SP8EBC/ParaTNC/doc/zlacza_pcb.jpg

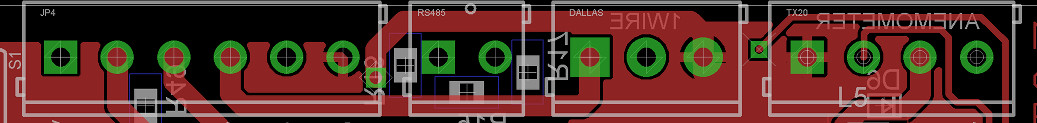
doc/zlacza_pcb.jpg
