SP8EBC/ParaTNC/doc/Screenshot_2026-09-29_10-51-03.jpg

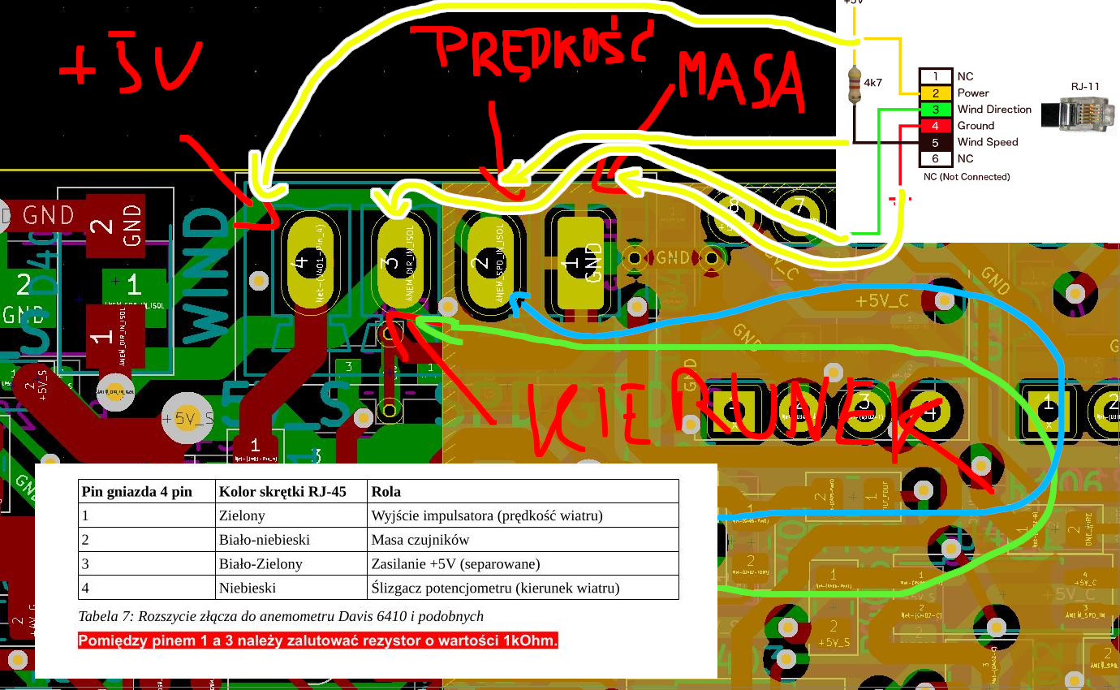
doc/Screenshot_2026-09-29_10-51-03.jpg
