SP8EBC/ParaTNC/doc/eclipse_indexer_config.png

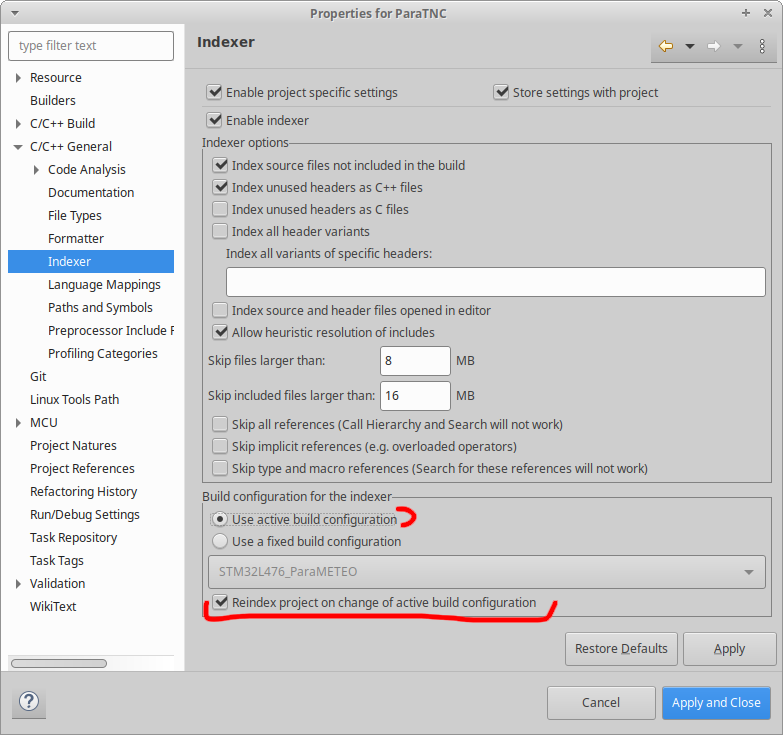
doc/eclipse_indexer_config.png
