SP8EBC/ParaTNC/doc/soft_reset_message_.jpg

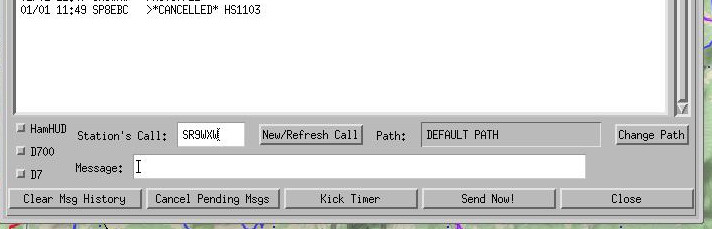
doc/soft_reset_message_.jpg
