SP8EBC/ParaTNC/(threads)

Thread 1 (2019-04-27):

Fake wind measuremenets after reconnecting DS12B20 sensor

SP8EBC, 2019-04-27:
Sometimes it is observed that after connecting DS12B20 temp sensor to controller which was powered up without it, wind measuremenets became screwed for unknown reasons

```
2019-04-27 09:58:20 CEST: SP8EBC-1>AKLPRZ,qAR,OK8UOF:T#057,058,002,109,120,000,00111000
2019-04-27 10:02:21 CEST: SP8EBC-1>AKLPRZ,qAR,OK8UOF:!4948.82N/01903.50E_000/000g000t032r...p...P...b00000
2019-04-27 10:03:22 CEST: SP8EBC-1>AKLPRZ,qAO,SP9AMG-1:=4948.82N101903.50E# Mateusz SP8EBC
2019-04-27 10:06:23 CEST: SP8EBC-1>AKLPRZ,qAO,SP9AMG-1:!4948.82N/01903.50E_000/000g000t032r...p...P...b00000
2019-04-27 10:08:24 CEST: SP8EBC-1>AKLPRZ,qAO,SP9AMG-1:T#058,073,003,105,120,000,00111000
2019-04-27 10:10:25 CEST: SP8EBC-1>AKLPRZ,qAR,OK8UOF:!4948.82N/01903.50E_000/000g000t032r...p...P...b00000
2019-04-27 10:14:26 CEST: SP8EBC-1>AKLPRZ,qAO,SP9AMG-1:!4948.82N/01903.50E_000/027g005t091r...p...P...b00000
2019-04-27 10:18:27 CEST: SP8EBC-1>AKLPRZ,qAR,OK8UOF:=4948.82N101903.50E# Mateusz SP8EBC
2019-04-27 10:18:28 CEST: SP8EBC-1>AKLPRZ,qAR,OK8UOF:!4948.82N/01903.50E_000/027g005t091r...p...P...b00000
2019-04-27 10:18:29 CEST: SP8EBC-1>AKLPRZ,qAO,SP9AMG-1:T#059,067,001,109,120,000,00111000
2019-04-27 10:22:31 CEST: SP8EBC-1>AKLPRZ,qAO,SP9AMG-1:!4948.82N/01903.50E_000/027g005t091r...p...P...b00000
```

Closed 2023-02-14.

Thread 3 (2021-06-13):

Failed linking during building target STM32L476_ParaMETEO

SP8EBC, 2021-06-13:
[console.log](https://github.com/SP8EBC/ParaTNC/files/6644348/console.log)

Closed 2021-09-14.

Thread 9 (2023-02-14):

Rework wx_handler_pressure to get pressure not humidity from RTU slave

SP8EBC, 2023-02-14:
`
```
        case WX_SOURCE_RTU:
	case WX_SOURCE_FULL_RTU: {

//		// get the value read from RTU registers
//		measurement_retval = rtu_get_humidity(&rte_wx_humidity, config_rtu);
//
//		// check
//		if (measurement_retval == MODBUS_RET_OK || measurement_retval == MODBUS_RET_DEGRADED) {
//
//			// set the flag that external temperature is available
//			output |= WX_HANDLER_PARAMETER_RESULT_HUMIDITY;
//
//			if (measurement_retval == BME280_OK) {
//				rte_wx_humidity_valid = rte_wx_humidity;
//			}
//		}
//
```
`

Thread 10 (2023-07-03):

ParaMETEO hardware: values of resitor to scale B+ to ADC voltage range

SP8EBC, 2023-07-03:
Some PCBs has 51k/510k pair. Some have 10k/100k. This might be a part of fix related to continous / non-continous ADC mode of operation. It has been checked and worked on in the past, but it needs to be consistent!!!!

Thread 11 (2023-07-13):

ParaMETEO hardware: fitting DB-9 connector

SP8EBC, 2023-07-13:
It's hard to believe but there is a problem with mechanical compatibility between two Amphenol connectors.

DE09P065TXLF - DB9 male soldered on cable
LD09S24A4GV00LF - DB9 female straight on PCB.

male plug cannot be pull completely into a connector. For some reason there will be no contact in between. The solution is to put two 1mm washers between male plug screw and a peg in the PCB female connector.

Thread 12 (2023-10-15):

APRS-IS connecting routine stalled after timeout and first reconnection

SP8EBC, 2023-10-15:
As a result the controller is no longer communicating with APRS-IS server and it looks like that it is not even connected at all. Below some raw aprs.fi logs. The second one is from a moment when communcation has been lost.
```
2023-10-14 05:32:39 CEST: [SR9WXP](https://aprs.fi/?c=raw&limit=&call=SR9WXP)>AKLPRZ,TCPIP*,qAC,T2ITALYN:!4932.18N/01919.18E_024/000g000t032r...p...P...b09682h45
2023-10-14 05:34:39 CEST: [SR9WXP](https://aprs.fi/?c=raw&limit=&call=SR9WXP)>AKLPRZ,TCPIP*,qAC,T2ITALYN:!4932.18N/01919.18E_024/000g000t032r...p...P...b09681h45
2023-10-14 05:36:37 CEST: [SR9WXP](https://aprs.fi/?c=raw&limit=&call=SR9WXP)>AKLPRZ,qAR,[SR9NSK](https://aprs.fi/?c=raw&limit=&call=SR9NSK):!4932.18N/01919.18E_021/000g000t032r...p...P...b09681h45
2023-10-14 05:36:40 CEST: [SR9WXP](https://aprs.fi/?c=raw&limit=&call=SR9WXP)>AKLPRZ,qAR,[SR9NSK](https://aprs.fi/?c=raw&limit=&call=SR9NSK):T#051,025,000,002,115,155,00101000
2023-10-14 05:38:41 CEST: [SR9WXP](https://aprs.fi/?c=raw&limit=&call=SR9WXP)>AKLPRZ,TCPIP*,qAC,T2ITALYN:!4932.18N/01919.18E_024/000g000t032r...p...P...b09681h45
2023-10-14 05:40:41 CEST: [SR9WXP](https://aprs.fi/?c=raw&limit=&call=SR9WXP)>AKLPRZ,TCPIP*,qAC,T2ITALYN:!4932.18N/01919.18E_024/000g000t032r...p...P...b09681h45
2023-10-14 05:41:41 CEST: [SR9WXP](https://aprs.fi/?c=raw&limit=&call=SR9WXP)>AKLPRZ,qAO,[SQ9KPH-12](https://aprs.fi/?c=raw&limit=&call=SQ9KPH-12):!4932.18N/01919.18E_021/000g000t032r...p...P...b09680h46
2023-10-14 05:42:42 CEST: [SR9WXP](https://aprs.fi/?c=raw&limit=&call=SR9WXP)>AKLPRZ,TCPIP*,qAC,T2ITALYN:!4932.18N/01919.18E_022/000g000t032r...p...P...b09681h46
2023-10-14 05:44:42 CEST: [SR9WXP](https://aprs.fi/?c=raw&limit=&call=SR9WXP)>AKLPRZ,TCPIP*,qAC,T2ITALYN:!4932.18N/01919.18E_022/000g000t032r...p...P...b09681h45
2023-10-14 12:19:49 CEST: [SR9WXP](https://aprs.fi/?c=raw&limit=&call=SR9WXP)>AKLPRZ,qAR,[SR9KFZ](https://aprs.fi/?c=raw&limit=&call=SR9KFZ):=4932.18NR01919.18E& DigiW1 + WX = TXPower 1W = Pilsko, wyciag orczykowy VII, 1440m AMSL = sp8ebc@interia.pl [vbat: 1318][rtc_ok: 1]
2023-10-14 12:19:52 CEST: [SR9WXP](https://aprs.fi/?c=raw&limit=&call=SR9WXP)>AKLPRZ,qAR,[SP9DLM](https://aprs.fi/?c=raw&limit=&call=SP9DLM):>[powersave registers][last_sleep_ts: 0x90724][last_wakeup_ts: 0x91152][sleep_wakeup_cntrs: 0xF90141][monitor: 0x0][last_sleep_time: 0xF0]
2023-10-14 12:21:26 CEST: [SR9WXP](https://aprs.fi/?c=raw&limit=&call=SR9WXP)>AKLPRZ,qAR,[SP9DLM](https://aprs.fi/?c=raw&limit=&call=SP9DLM):>[GSM status][network: Plus GSM][signal: -68dBm][freq: 935.59MHz][cellid: f660][lac: 539d][IP addr: 10.18.7.101  ]
2023-10-14 12:22:46 CEST: [SR9WXP](https://aprs.fi/?c=raw&limit=&call=SR9WXP)>AKLPRZ,TCPIP*,qAC,T2NORWAY:=4932.18NR01919.18E& DigiW1 + WX = TXPower 1W = Pilsko, wyciag orczykowy VII, 1440m AMSL = sp8ebc@interia.pl
2023-10-14 12:22:46 CEST: [SR9WXP](https://aprs.fi/?c=raw&limit=&call=SR9WXP)>AKLPRZ,TCPIP*,qAC,T2NORWAY:>[aprsis][]# aprsc 2.1.15-gc67551b
2023-10-14 12:24:05 CEST: [SR9WXP](https://aprs.fi/?c=raw&limit=&call=SR9WXP)>AKLPRZ,TCPIP*,qAC,T2NORWAY:!4932.18N/01919.18E_204/010g015t054r...p...P...b08523h91
2023-10-14 12:24:25 CEST: [SR9WXP](https://aprs.fi/?c=raw&limit=&call=SR9WXP)>AKLPRZ,qAR,[SR7NST](https://aprs.fi/?c=raw&limit=&call=SR7NST):!4932.18N/01919.18E_211/010g015t054r...p...P...b08522h90
2023-10-14 12:24:50 CEST: [SR9WXP](https://aprs.fi/?c=raw&limit=&call=SR9WXP)>AKLPRZ,qAR,[SP9DLM](https://aprs.fi/?c=raw&limit=&call=SP9DLM):>[APRS-IS timeout][aprsis_unsucessfull_conn_counter: 0]
2023-10-14 12:26:19 CEST: [SR9WXP](https://aprs.fi/?c=raw&limit=&call=SR9WXP)>AKLPRZ,TCPIP*,qAC,T2SWEDEN:=4932.18NR01919.18E& DigiW1 + WX = TXPower 1W = Pilsko, wyciag orczykowy VII, 1440m AMSL = sp8ebc@interia.pl
2023-10-14 12:26:19 CEST: [SR9WXP](https://aprs.fi/?c=raw&limit=&call=SR9WXP)>AKLPRZ,TCPIP*,qAC,T2SWEDEN:>[aprsis][]# aprsc 2.1.15-gc67551b
2023-10-14 12:27:30 CEST: [SR9WXP](https://aprs.fi/?c=raw&limit=&call=SR9WXP)>AKLPRZ,TCPIP*,qAC,T2SWEDEN:!4932.18N/01919.18E_207/010g016t054r...p...P...b08525h90
2023-10-14 12:29:31 CEST: [SR9WXP](https://aprs.fi/?c=raw&limit=&call=SR9WXP)>AKLPRZ,TCPIP*,qAC,T2SWEDEN:!4932.18N/01919.18E_207/009g016t054r...p...P...b08525h90
2023-10-14 12:32:52 CEST: [SR9WXP](https://aprs.fi/?c=raw&limit=&call=SR9WXP)>AKLPRZ,TCPIP*,qAC,T2CSNGRAD:=4932.18NR01919.18E& DigiW1 + WX = TXPower 1W = Pilsko, wyciag orczykowy VII, 1440m AMSL = sp8ebc@interia.pl
2023-10-14 12:32:52 CEST: [SR9WXP](https://aprs.fi/?c=raw&limit=&call=SR9WXP)>AKLPRZ,TCPIP*,qAC,T2CSNGRAD:>[aprsis][]# aprsc 2.1.15-gc67551b
2023-10-14 12:33:59 CEST: [SR9WXP](https://aprs.fi/?c=raw&limit=&call=SR9WXP)>AKLPRZ,TCPIP*,qAC,T2CSNGRAD:!4932.18N/01919.18E_209/010g016t054r...p...P...b08517h89
2023-10-14 12:34:28 CEST: [SR9WXP](https://aprs.fi/?c=raw&limit=&call=SR9WXP)>AKLPRZ,qAR,[SP9DLM](https://aprs.fi/?c=raw&limit=&call=SP9DLM):!4932.18N/01919.18E_217/010g016t054r...p...P...b08517h89
2023-10-14 12:36:06 CEST: [SR9WXP](https://aprs.fi/?c=raw&limit=&call=SR9WXP)>AKLPRZ,TCPIP*,qAC,T2PRT:=4932.18NR01919.18E& DigiW1 + WX = TXPower 1W = Pilsko, wyciag orczykowy VII, 1440m AMSL = sp8ebc@interia.pl
2023-10-14 12:36:06 CEST: [SR9WXP](https://aprs.fi/?c=raw&limit=&call=SR9WXP)>AKLPRZ,TCPIP*,qAC,T2PRT:>[aprsis][]# aprsc 2.1.14-g5e22b37
2023-10-14 12:36:29 CEST: [SR9WXP](https://aprs.fi/?c=raw&limit=&call=SR9WXP)>AKLPRZ,qAR,[SP9DLM](https://aprs.fi/?c=raw&limit=&call=SP9DLM):>[GSM status][network: Plus GSM][signal: -70dBm][freq: 935.59MHz][cellid: f660][lac: 539d][IP addr: 10.169.130.219  ]
2023-10-14 12:39:36 CEST: [SR9WXP](https://aprs.fi/?c=raw&limit=&call=SR9WXP)>AKLPRZ,qAR,[SP9DLM](https://aprs.fi/?c=raw&limit=&call=SP9DLM):!4932.18N/01919.18E_201/009g015t055r...p...P...b08522h89
2023-10-14 12:41:58 CEST: [SR9WXP](https://aprs.fi/?c=raw&limit=&call=SR9WXP)>AKLPRZ,TCPIP*,qAC,T2SWEDEN:=4932.18NR01919.18E& DigiW1 + WX = TXPower 1W = Pilsko, wyciag orczykowy VII, 1440m AMSL = sp8ebc@interia.pl
2023-10-14 12:41:58 CEST: [SR9WXP](https://aprs.fi/?c=raw&limit=&call=SR9WXP)>AKLPRZ,TCPIP*,qAC,T2SWEDEN:>[aprsis][]# aprsc 2.1.15-gc67551b
2023-10-14 12:43:38 CEST: [SR9WXP](https://aprs.fi/?c=raw&limit=&call=SR9WXP)>AKLPRZ,TCPIP*,qAC,T2SWEDEN:!4932.18N/01919.18E_203/009g013t055r...p...P...b08522h89
2023-10-14 12:45:38 CEST: [SR9WXP](https://aprs.fi/?c=raw&limit=&call=SR9WXP)>AKLPRZ,TCPIP*,qAC,T2SWEDEN:!4932.18N/01919.18E_195/008g011t055r...p...P...b08523h89
2023-10-14 12:47:38 CEST: [SR9WXP](https://aprs.fi/?c=raw&limit=&call=SR9WXP)>AKLPRZ,TCPIP*,qAC,T2SWEDEN:!4932.18N/01919.18E_199/009g015t055r...p...P...b08523h89
2023-10-14 12:49:34 CEST: [SR9WXP](https://aprs.fi/?c=raw&limit=&call=SR9WXP)>AKLPRZ,qAR,[SP9DLM](https://aprs.fi/?c=raw&limit=&call=SP9DLM):T#002,171,000,006,200,139,10001000
2023-10-14 12:49:38 CEST: [SR9WXP](https://aprs.fi/?c=raw&limit=&call=SR9WXP)>AKLPRZ,TCPIP*,qAC,T2SWEDEN:!4932.18N/01919.18E_189/009g015t055r...p...P...b08523h89
2023-10-14 12:51:38 CEST: [SR9WXP](https://aprs.fi/?c=raw&limit=&call=SR9WXP)>AKLPRZ,TCPIP*,qAC,T2SWEDEN:!4932.18N/01919.18E_198/009g012t055r...p...P...b08523h89
2023-10-14 12:54:34 CEST: [SR9WXP](https://aprs.fi/?c=raw&limit=&call=SR9WXP)>AKLPRZ,qAR,[SP9DLM](https://aprs.fi/?c=raw&limit=&call=SP9DLM):!4932.18N/01919.18E_204/008g013t055r...p...P...b08523h89
2023-10-14 12:55:39 CEST: [SR9WXP](https://aprs.fi/?c=raw&limit=&call=SR9WXP)>AKLPRZ,TCPIP*,qAC,T2SWEDEN:!4932.18N/01919.18E_204/009g014t055r...p...P...b08523h89
2023-10-14 12:57:39 CEST: [SR9WXP](https://aprs.fi/?c=raw&limit=&call=SR9WXP)>AKLPRZ,TCPIP*,qAC,T2SWEDEN:!4932.18N/01919.18E_193/009g014t055r...p...P...b08523h88
```

```2023-10-14 20:42:56 CEST: [SR9WXP](https://aprs.fi/?c=raw&limit=&call=SR9WXP)>AKLPRZ,qAR,[SP9DLM](https://aprs.fi/?c=raw&limit=&call=SP9DLM):!4932.18N/01919.18E_258/006g008t047r...p...P...b08519h97
2023-10-14 20:44:55 CEST: [SR9WXP](https://aprs.fi/?c=raw&limit=&call=SR9WXP)>AKLPRZ,TCPIP*,qAC,T2SWEDEN:!4932.18N/01919.18E_271/006g007t047r...p...P...b08520h97
2023-10-14 20:46:57 CEST: [SR9WXP](https://aprs.fi/?c=raw&limit=&call=SR9WXP)>AKLPRZ,TCPIP*,qAC,T2SWEDEN:!4932.18N/01919.18E_274/005g007t047r...p...P...b08520h97
2023-10-14 20:47:55 CEST: [SR9WXP](https://aprs.fi/?c=raw&limit=&call=SR9WXP)>AKLPRZ,qAR,[SR9NSK](https://aprs.fi/?c=raw&limit=&call=SR9NSK):!4932.18N/01919.18E_278/005g007t047r...p...P...b08520h97
2023-10-14 20:48:56 CEST: [SR9WXP](https://aprs.fi/?c=raw&limit=&call=SR9WXP)>AKLPRZ,TCPIP*,qAC,T2SWEDEN:!4932.18N/01919.18E_284/004g005t047r...p...P...b08520h97
2023-10-14 20:50:56 CEST: [SR9WXP](https://aprs.fi/?c=raw&limit=&call=SR9WXP)>AKLPRZ,TCPIP*,qAC,T2SWEDEN:!4932.18N/01919.18E_261/004g005t047r...p...P...b08519h97
2023-10-14 20:52:55 CEST: [SR9WXP](https://aprs.fi/?c=raw&limit=&call=SR9WXP)>AKLPRZ,qAR,[SP9DLM](https://aprs.fi/?c=raw&limit=&call=SP9DLM):!4932.18N/01919.18E_324/002g005t047r...p...P...b08518h97
2023-10-14 20:55:33 CEST: [SR9WXP](https://aprs.fi/?c=raw&limit=&call=SR9WXP)>AKLPRZ,TCPIP*,qAC,T2SWEDEN:!4932.18N/01919.18E_280/005g008t047r...p...P...b08519h97
2023-10-14 20:57:58 CEST: [SR9WXP](https://aprs.fi/?c=raw&limit=&call=SR9WXP)>AKLPRZ,qAR,[SP9DLM](https://aprs.fi/?c=raw&limit=&call=SP9DLM):!4932.18N/01919.18E_272/006g007t047r...p...P...b08520h97
2023-10-14 20:57:59 CEST: [SR9WXP](https://aprs.fi/?c=raw&limit=&call=SR9WXP)>AKLPRZ,qAR,[SP9DLM](https://aprs.fi/?c=raw&limit=&call=SP9DLM):>[GSM status][network: Plus GSM][signal: -70dBm][freq: 935.59MHz][cellid: f660][lac: 539d][IP addr: 10.22.78.160  ]
2023-10-14 20:59:00 CEST: [SR9WXP](https://aprs.fi/?c=raw&limit=&call=SR9WXP)>AKLPRZ,TCPIP*,qAC,T2ROMANIA:=4932.18NR01919.18E& DigiW1 + WX = TXPower 1W = Pilsko, wyciag orczykowy VII, 1440m AMSL = sp8ebc@interia.pl
2023-10-14 21:03:00 CEST: [SR9WXP](https://aprs.fi/?c=raw&limit=&call=SR9WXP)>AKLPRZ,qAR,[SP9UVG-13](https://aprs.fi/?c=raw&limit=&call=SP9UVG-13):!4932.18N/01919.18E_275/004g006t047r...p...P...b08521h97
2023-10-14 21:03:04 CEST: [SR9WXP](https://aprs.fi/?c=raw&limit=&call=SR9WXP)>AKLPRZ,qAR,[SP9UVG-13](https://aprs.fi/?c=raw&limit=&call=SP9UVG-13):T#051,186,000,002,127,127,10001000
2023-10-14 21:13:04 CEST: [SR9WXP](https://aprs.fi/?c=raw&limit=&call=SR9WXP)>AKLPRZ,qAR,[SP9UVG-13](https://aprs.fi/?c=raw&limit=&call=SP9UVG-13):!4932.18N/01919.18E_312/003g004t044r...p...P...b08521h96
2023-10-14 21:13:07 CEST: [SR9WXP](https://aprs.fi/?c=raw&limit=&call=SR9WXP)>AKLPRZ,qAR,[SP9UVG-13](https://aprs.fi/?c=raw&limit=&call=SP9UVG-13):T#052,182,000,000,128,125,10001000
2023-10-14 21:18:11 CEST: [SR9WXP](https://aprs.fi/?c=raw&limit=&call=SR9WXP)>AKLPRZ,qAR,[SP9UVG-13](https://aprs.fi/?c=raw&limit=&call=SP9UVG-13):!4932.18N/01919.18E_018/003g004t043r...p...P...b08521h96
2023-10-14 21:23:07 CEST: [SR9WXP](https://aprs.fi/?c=raw&limit=&call=SR9WXP)>AKLPRZ,qAR,[SR9KFZ](https://aprs.fi/?c=raw&limit=&call=SR9KFZ):!4932.18N/01919.18E_347/001g002t042r...p...P...b08520h96```

SP8EBC, 2023-10-24:
This was not an error. There is a problem with GSM signal level in that location. Network becomes unavailable during foggy and/or rainy weather.

Closed 2023-10-24.

Thread 13 (2023-10-30):

Probable bug in srl_reset function

SP8EBC, 2023-10-30:
This function supposes to reset USART driver state by clearing receive and transmit enums to 'IDLE', reset some counter etc. It is used in three places by sim800 GPRS/GSM modem driver. The problem might be that srl_reset does not disable interrupts for USART port, which might cause a deadlock or rather a deadloop, after a port will receive something **after** it is reset.

Below some screenshots of controller in such state.
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

SP8EBC, 2023-10-30:
```mateusz@mateusz-ThinkCentre-M720q:~/Documents/___STM32/ParaTNC$ git diff 4429c67 6648c8c system/src/drivers/l4/serial_stm32l4x.c
mateusz@mateusz-ThinkCentre-M720q:~/Documents/___STM32/ParaTNC$ git diff 4429c67 28b65cc system/src/drivers/l4/serial_stm32l4x.c
diff --git a/system/src/drivers/l4/serial_stm32l4x.c b/system/src/drivers/l4/serial_stm32l4x.c
index 4d9182c..9e2796a 100644
--- a/system/src/drivers/l4/serial_stm32l4x.c
+++ b/system/src/drivers/l4/serial_stm32l4x.c
@@ -730,7 +730,22 @@ void srl_irq_handler(srl_context_t *ctx) {
                        }

                        break;
-                       default: break;
+               case SRL_TX_IDLE:^M
+                       ctx->port->CR1 &= (0xFFFFFFFF ^ USART_CR1_TE);          //wyġṗczanie nadajnika portu szeregowego^M
+                       ctx->port->CR1 &= (0xFFFFFFFF ^ USART_CR1_TXEIE);^M
+                       ctx->port->CR1 &= (0xFFFFFFFF ^ USART_CR1_TCIE);        // wyġṗczanie przerwañ od portu szeregowego^M
+                       ctx->port->ISR &= (0xFFFFFFFF ^ USART_ISR_TC);^M
+                       ctx->srl_tx_state = SRL_TX_IDLE;^M
+^M
+                       // reset tx buffer pointer to internal one^M
+                       ctx->srl_tx_buf_pointer = ctx->srl_tx_internal_buf_pointer;^M
+                       ctx->srl_tx_buf_ln = ctx->srl_tx_internal_buf_ln;^M
+^M
+                       if (ctx->te_port != 0) {^M
+                               LL_GPIO_ResetOutputPin(ctx->te_port, ctx->te_pin);^M
+                       }^M
+                       break;^M
+               default: break;^M
                }
        }

mateusz@mateusz-ThinkCentre-M720q:~/Documents/___STM32/ParaTNC$```
