SP8EBC/ParaTNC/hardware/parameteo_hwrev_h/parameteo_hwrev_h.pdf

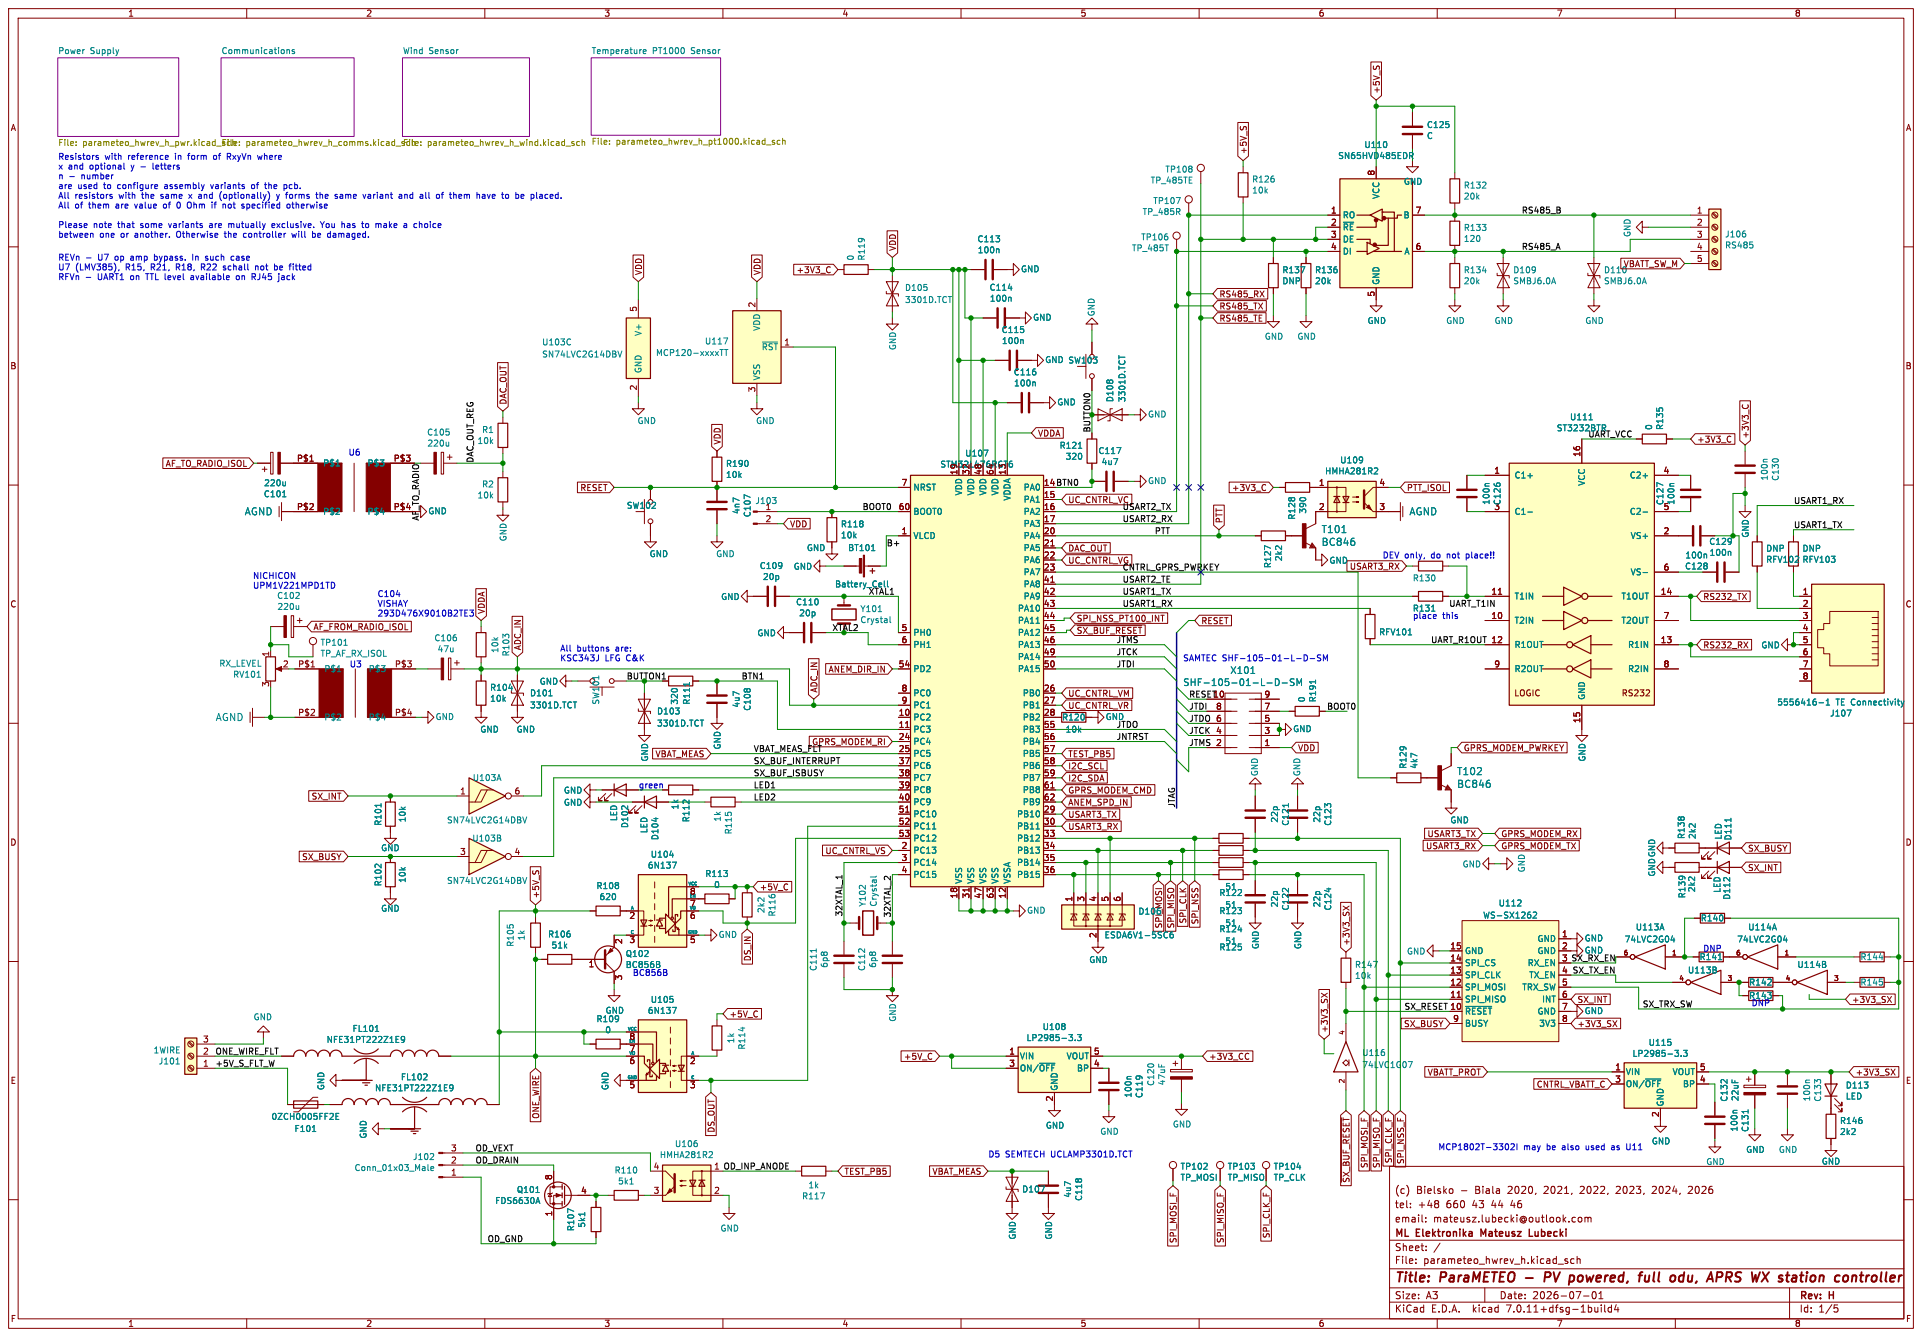
[picture p27: page 1]

Communications File: parameteo_hwrev_h_comms.kicad_sch Wind Sensor File: parameteo_hwrev_h_wind.kicad_sch Power Supply File: parameteo_hwrev_h_pwr.kicad_sch

2 3 GND GND GND R101 10k GND GND R102 10k R107 5k1 FL101 NFE31PT222Z1E9 F101

2 ON/~{OFF} 3 BP 4 VOUT 5 U108

2 ON/~{OFF} 3 BP 4 VOUT 5 C118 4u7D107 GND

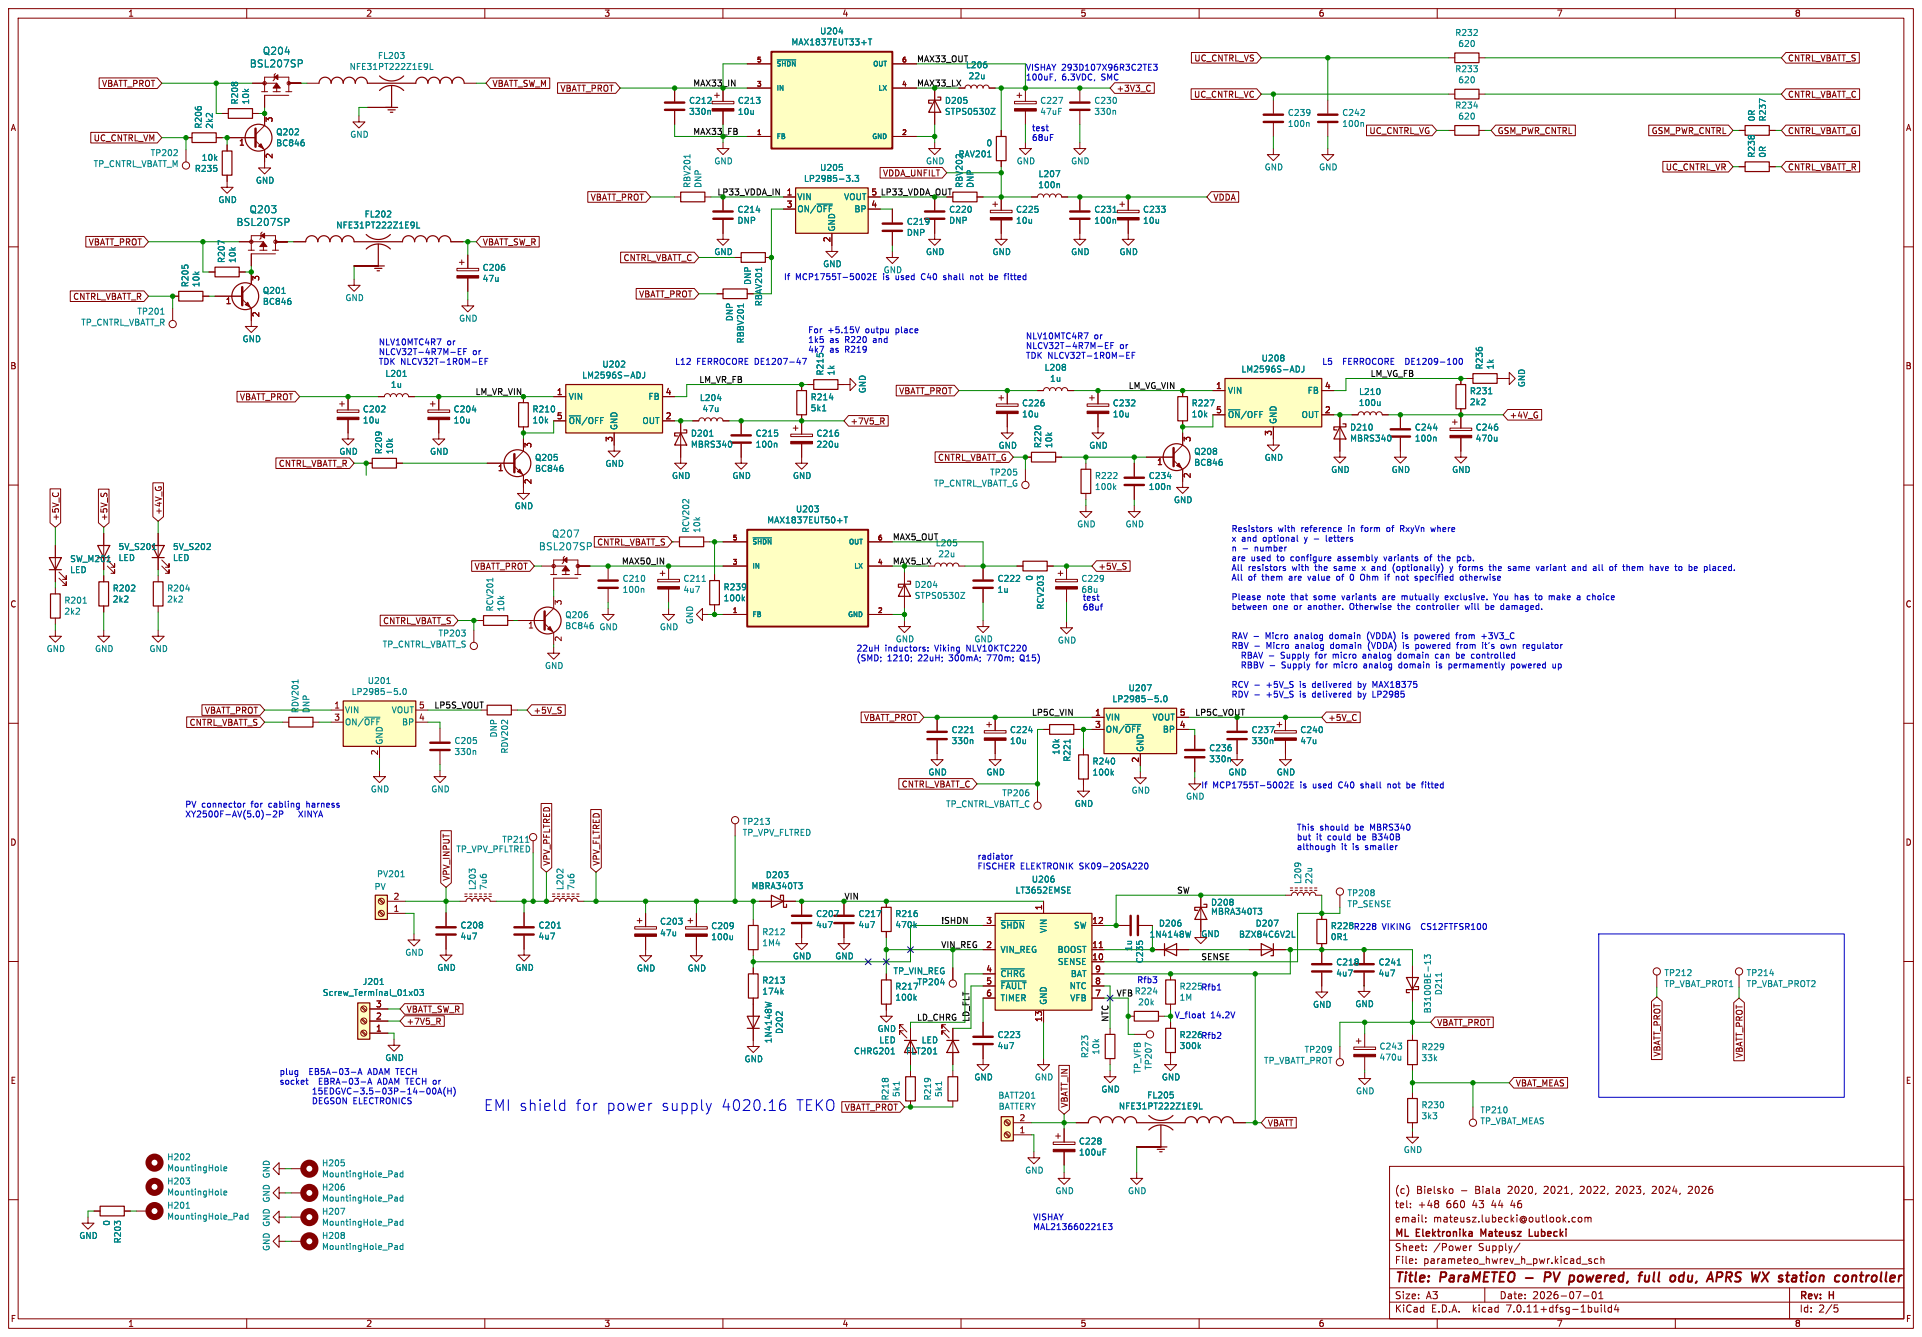
[picture p28: page 2]

2 ON/~{OFF} 3 BP 4 VOUT 5 C212

2 ON/~{OFF} 3 BP 4 VOUT 5 U205

3 FB 4 ~{ON}/OFF 5 GND Q208

2 ON/~{OFF} 3 BP 4 VOUT 5 U201

2 ON/~{OFF} 3 BP 4 VOUT 5 U207

2 ON/~{OFF} 3 BP 4 VOUT 5 GND

but it could be B340B

radiator FISCHER ELEKTRONIK SK09-20SA220 EMI shield for power supply 4020.16 TEKO

1 SENSE 10 BOOST 11 SW 12 GND 13 VIN_REG 2 ~{SHDN} 3 ~{CHRG} 4 ~{FAULT} 5 TIMER 6 VFB 7 NTC 8 BAT 9 U206
LT3652EMSE

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

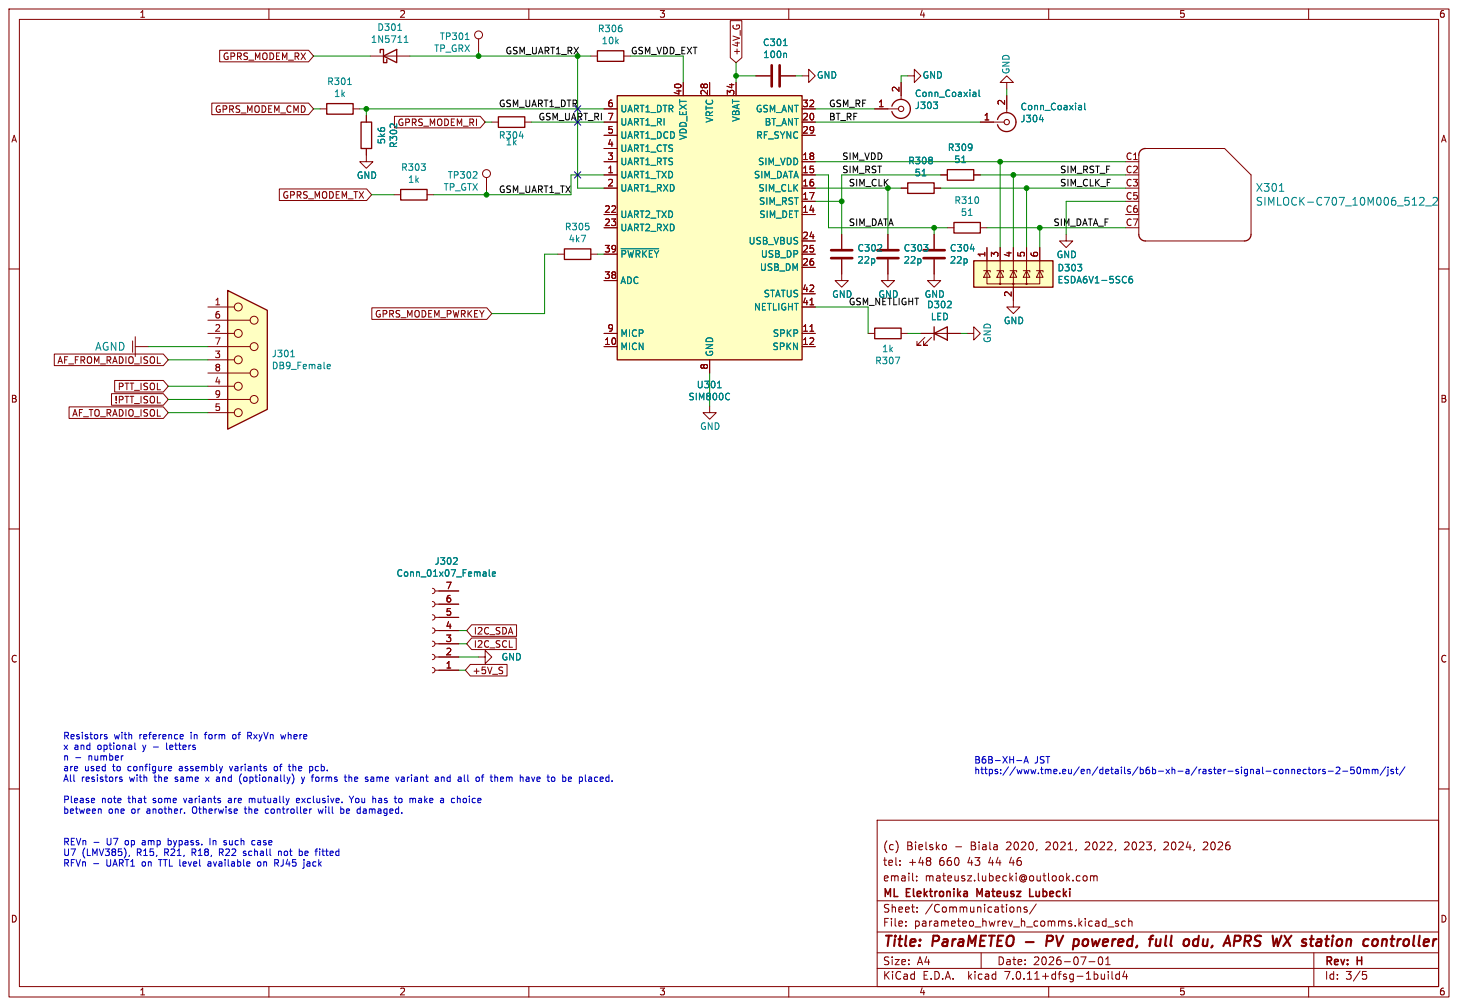
[picture p29: page 3]

https://www.tme.eu/en/details/b6b-xh-a/raster-signal-connectors-2-50mm/jst/

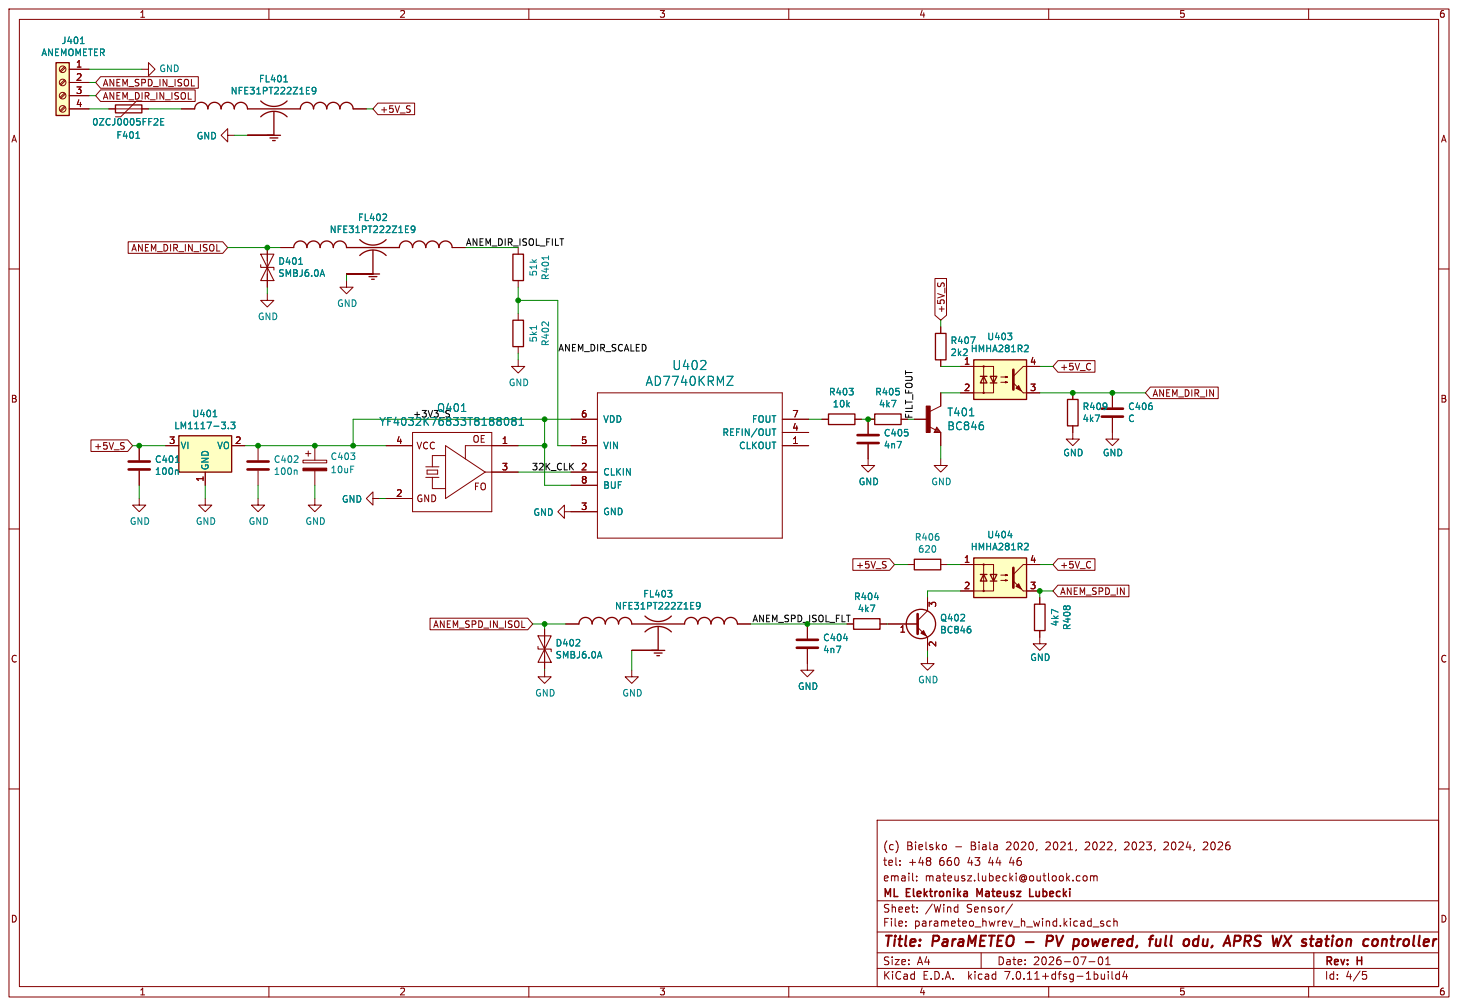
[picture p30: page 4]

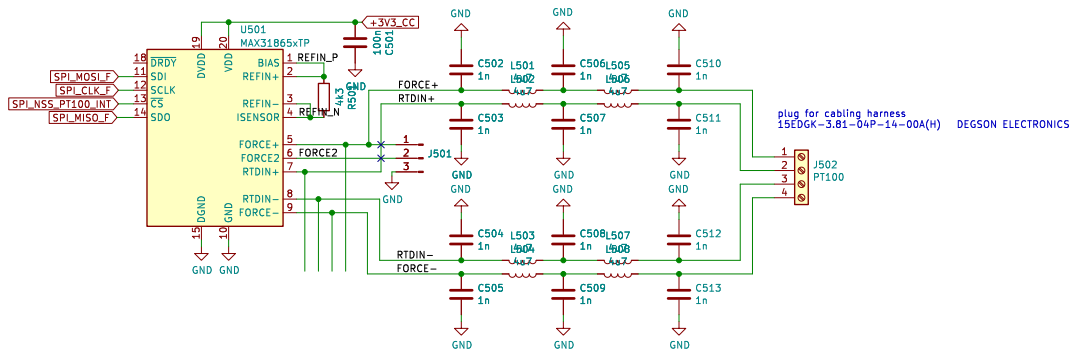
[picture p31: page 5]
