SP8EBC/ParaTNC/hardware/parameteo_hwrev_f/parameteo_hwrev_f.pdf

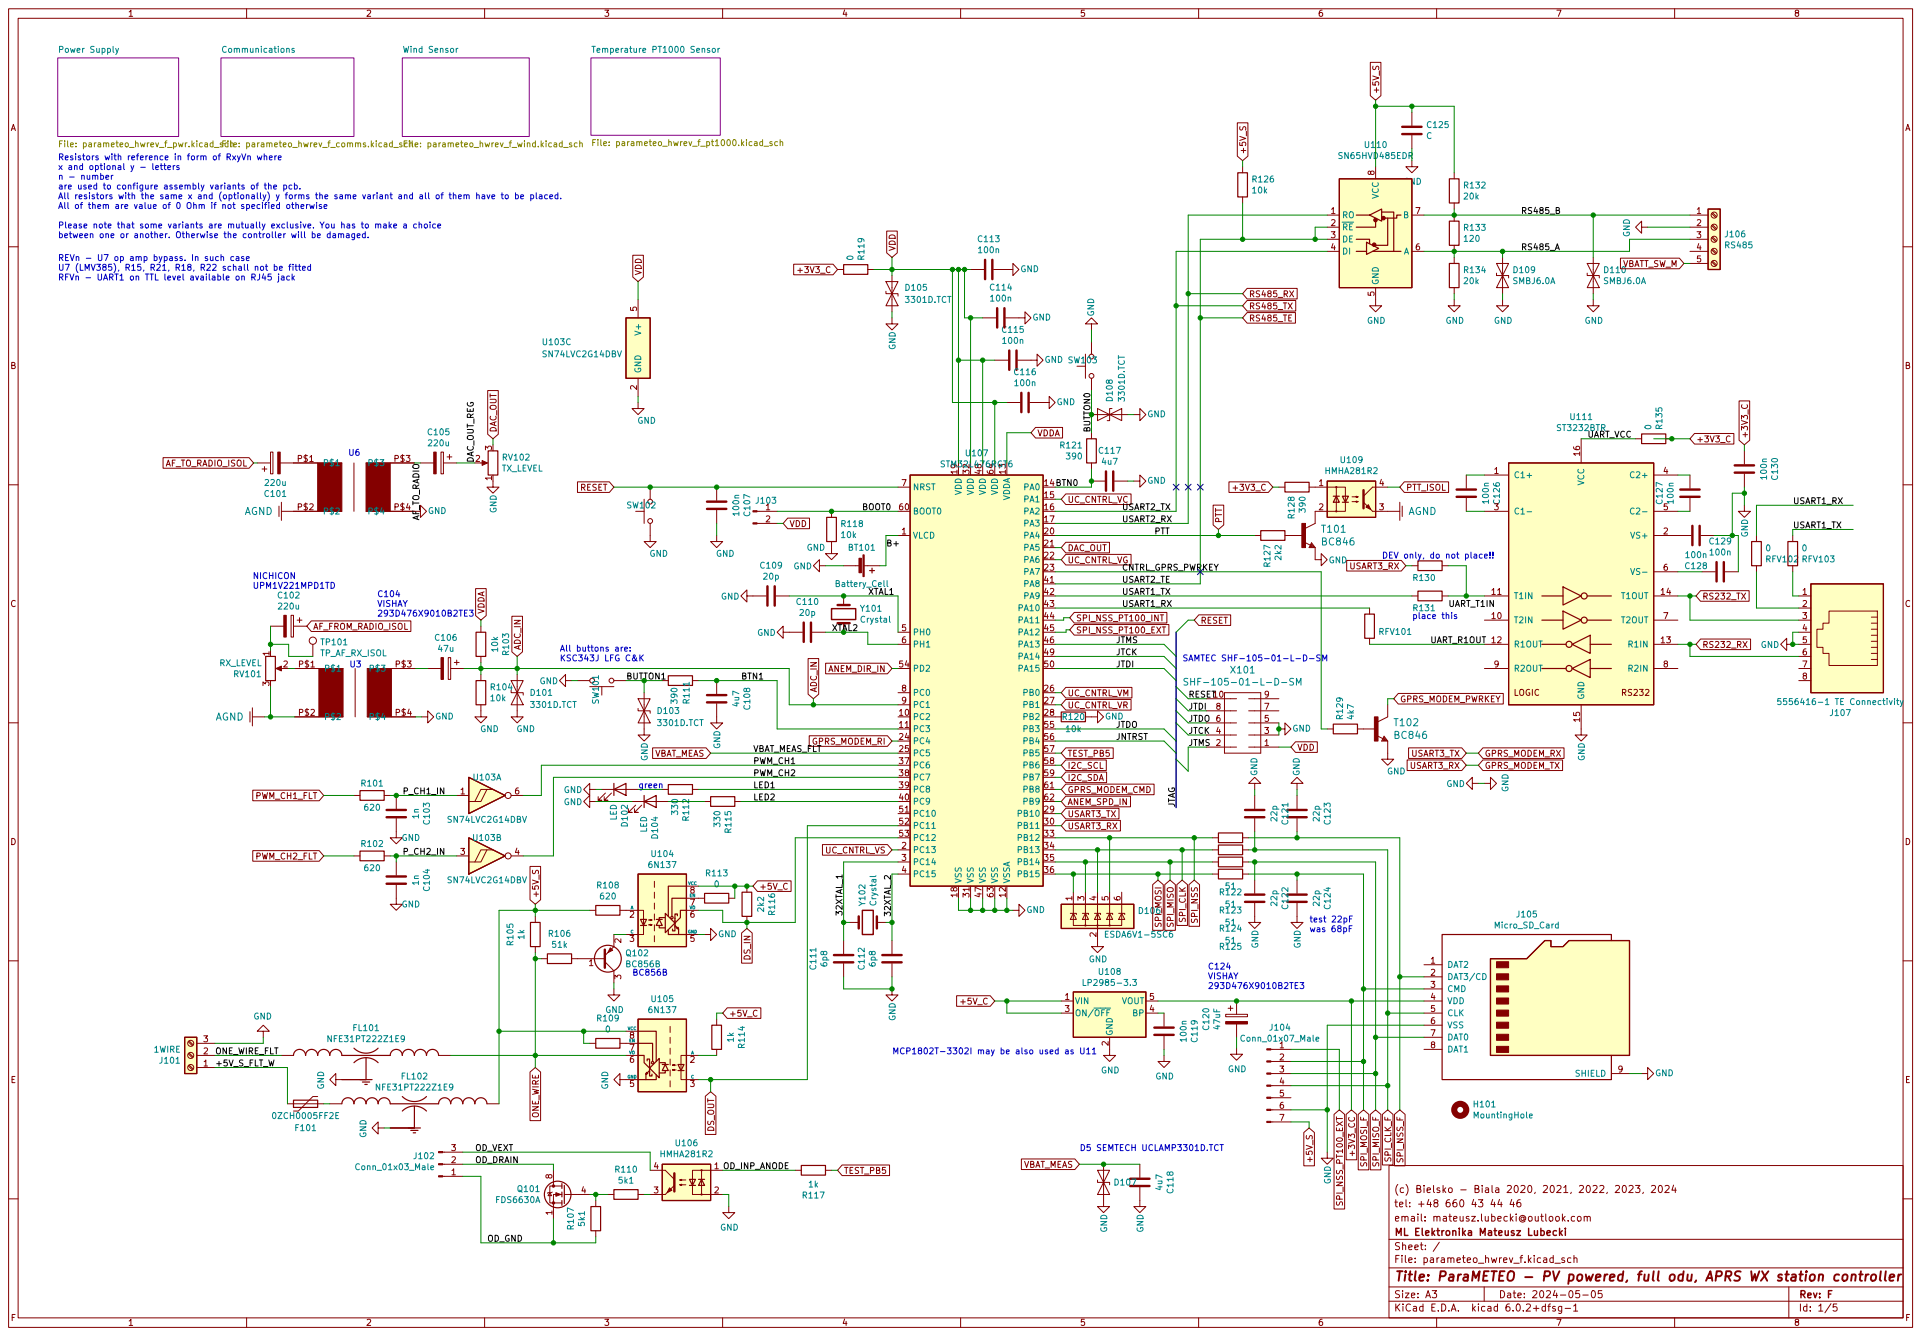
[picture p32: page 1]

Communications File: parameteo_hwrev_f_comms.kicad_sch Wind Sensor File: parameteo_hwrev_f_wind.kicad_sch

File: parameteo_hwrev_f_pwr.kicad_sch
Resistors with reference in form of RxyVn where
x and optional y - letters n - number are used to configure assembly variants of the pcb.

All resistors with the same x and (optionally) y forms the same variant and all of them have to be placed.
All of them are value of 0 Ohm if not specified otherwise

Please note that some variants are mutually exclusive. You has to make a choice
between one or another. Otherwise the controller will be damaged. NICHICON

U7 (LMV385), R15, R21, R18, R22 schall not be fitted
RFVn - UART1 on TTL level available on RJ45 jack

place this All buttons are: KSC343J LFG C&K C104 VISHAY

was 68pF SAMTEC SHF-105-01-L-D-SM

2 ON/~{OFF} 3 BP 4 VOUT 5 U108

MCP1802T-3302I may be also used as U11

(c) Bielsko - Biala 2020, 2021, 2022, 2023, 2024
tel: +48 660 43 44 46
File: parameteo_hwrev_f.kicad_sch Sheet: / ML Elektronika Mateusz Lubecki email: mateusz.lubecki@outlook.com

Id: 1/5 Title: ParaMETEO - PV powered, full odu, APRS WX station controller

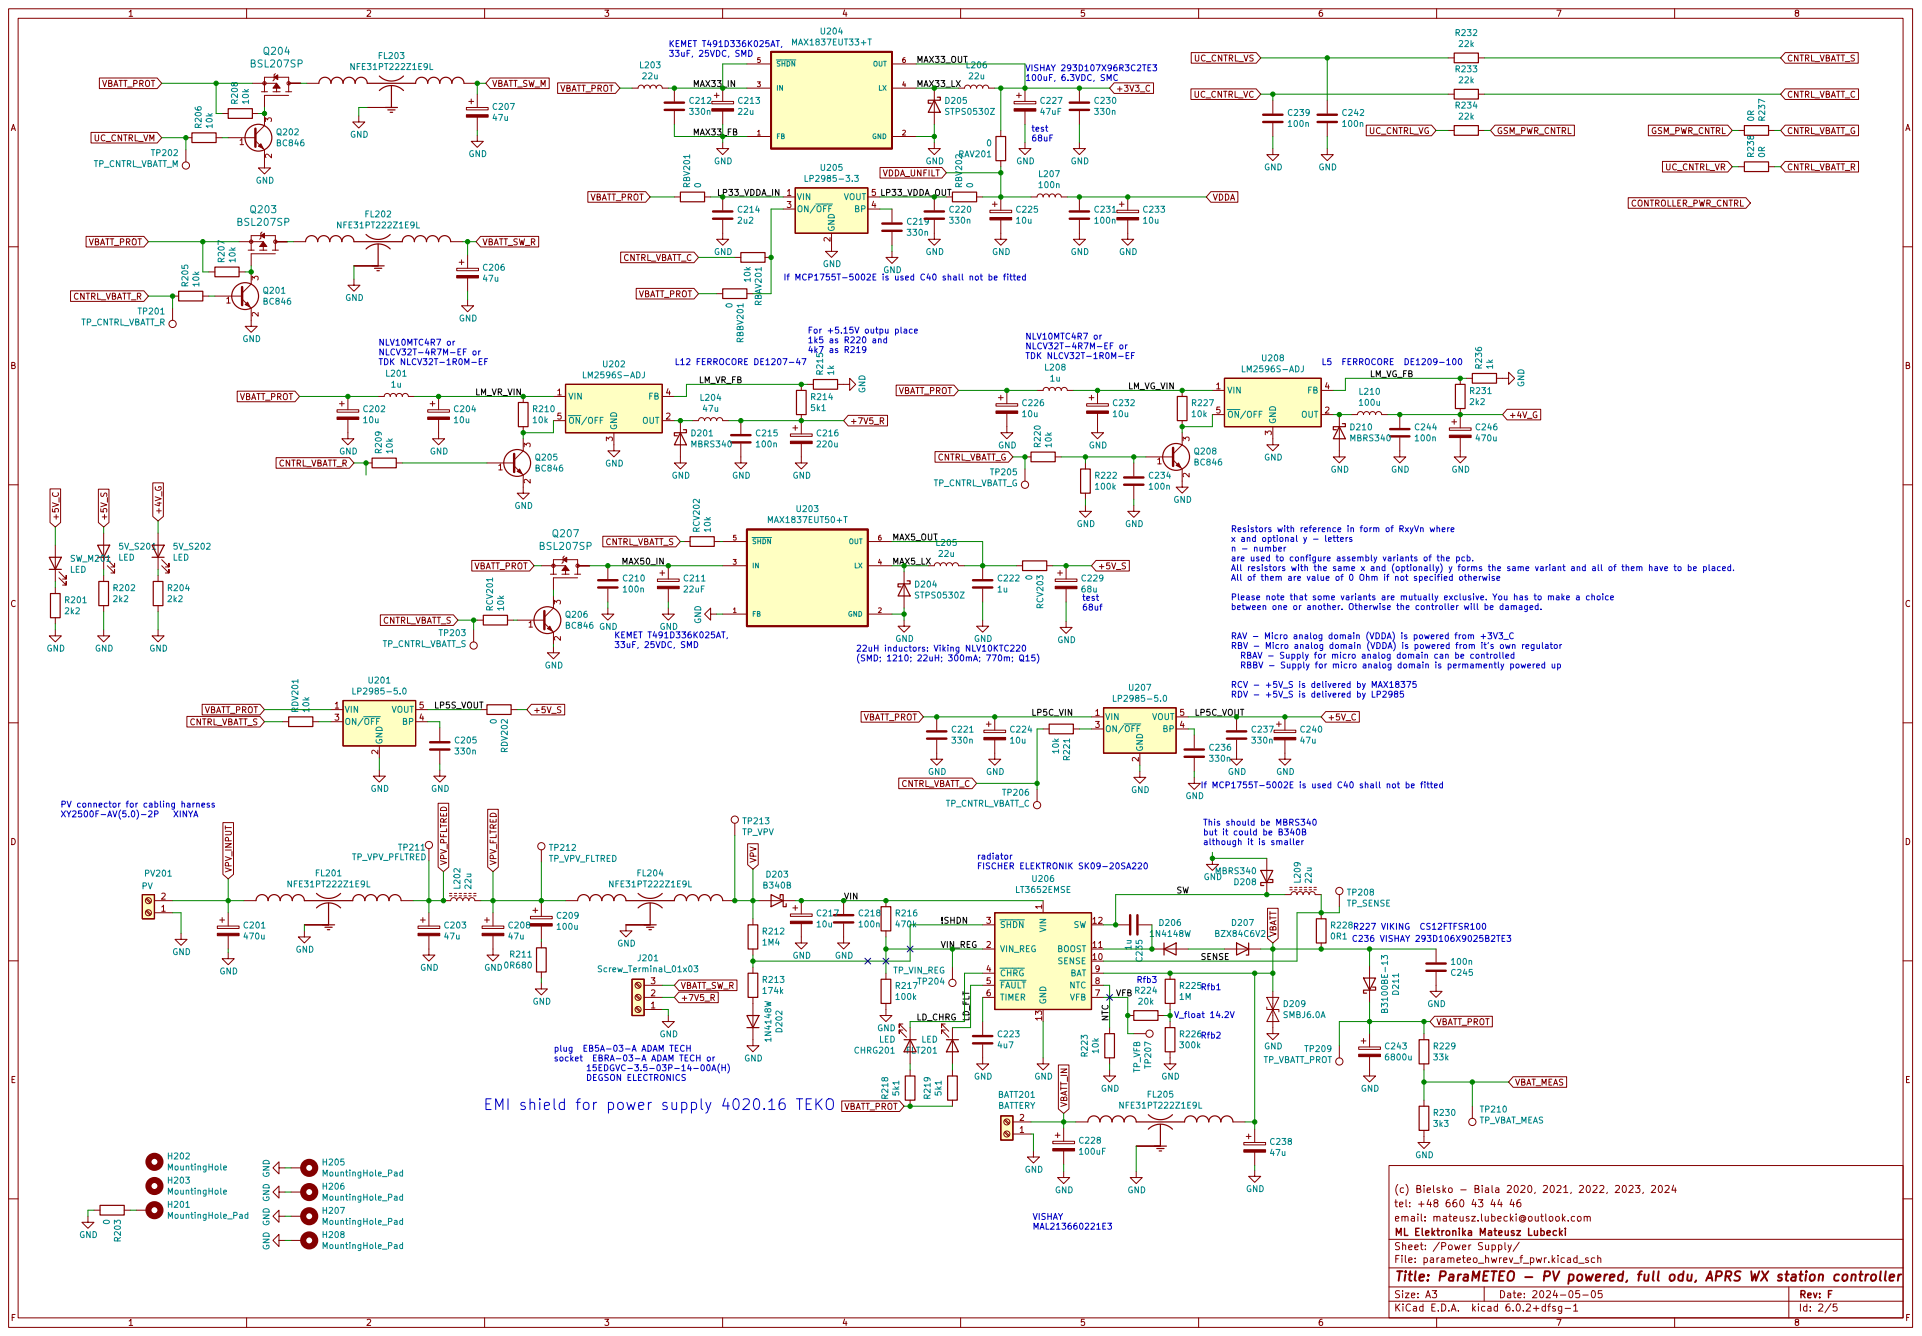
[picture p33: page 2]

NLV10MTC4R7 or NLCV32T-4R7M-EF or TDK NLCV32T-1R0M-EF VISHAY 293D107X96R3C2TE3 100uF, 6.3VDC, SMC

2 ON/~{OFF} 3 BP 4 VOUT 5 U205

2 3 Q201 BC846 R207 10k GND R2030 H203 MountingHole H202 MountingHole GND
5k1 FL204 NFE31PT222Z1E9L GND

If MCP1755T-5002E is used C40 shall not be fitted

For +5.15V outpu place 1k5 as R220 and 4k7 as R219

NLV10MTC4R7 or NLCV32T-4R7M-EF or TDK NLCV32T-1R0M-EF

x and optional y - letters n - number are used to configure assembly variants of the pcb.

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

Please note that some variants are mutually exclusive. You has to make a choice
between one or another. Otherwise the controller will be damaged.
GND R223 10k R221 10k GND GND

RAV - Micro analog domain (VDDA) is powered from +3V3_C
RBV - Micro analog domain (VDDA) is powered from it's own regulator
RBAV - Supply for micro analog domain can be controlled
RBBV - Supply for micro analog domain is permamently powered up
LP5C_VOUT SENSE

2 ON/~{OFF} 3 BP 4 VOUT 5 U201

2 ON/~{OFF} 3 BP 4 VOUT 5 U207

RCV - +5V_S is delivered by MAX18375
RDV - +5V_S is delivered by LP2985 C236 VISHAY 293D106X9025B2TE3

PV connector for cabling harness
XY2500F-AV(5.0)-2P XINYA

but it could be B340B
although it is smaller Rfb1

1 SENSE 10 BOOST 11 SW 12 GND 13 VIN_REG 2 ~{SHDN} 3 ~{CHRG} 4 ~{FAULT} 5 TIMER 6 VFB 7 NTC 8 BAT 9 U206

plug EB5A-03-A ADAM TECH socket EBRA-03-A ADAM TECH or

EMI shield for power supply 4020.16 TEKO

(c) Bielsko - Biala 2020, 2021, 2022, 2023, 2024
tel: +48 660 43 44 46
Sheet: /Power Supply/ ML Elektronika Mateusz Lubecki email: mateusz.lubecki@outlook.com

File: parameteo_hwrev_f_pwr.kicad_sch
Id: 2/5 Title: ParaMETEO - PV powered, full odu, APRS WX station controller

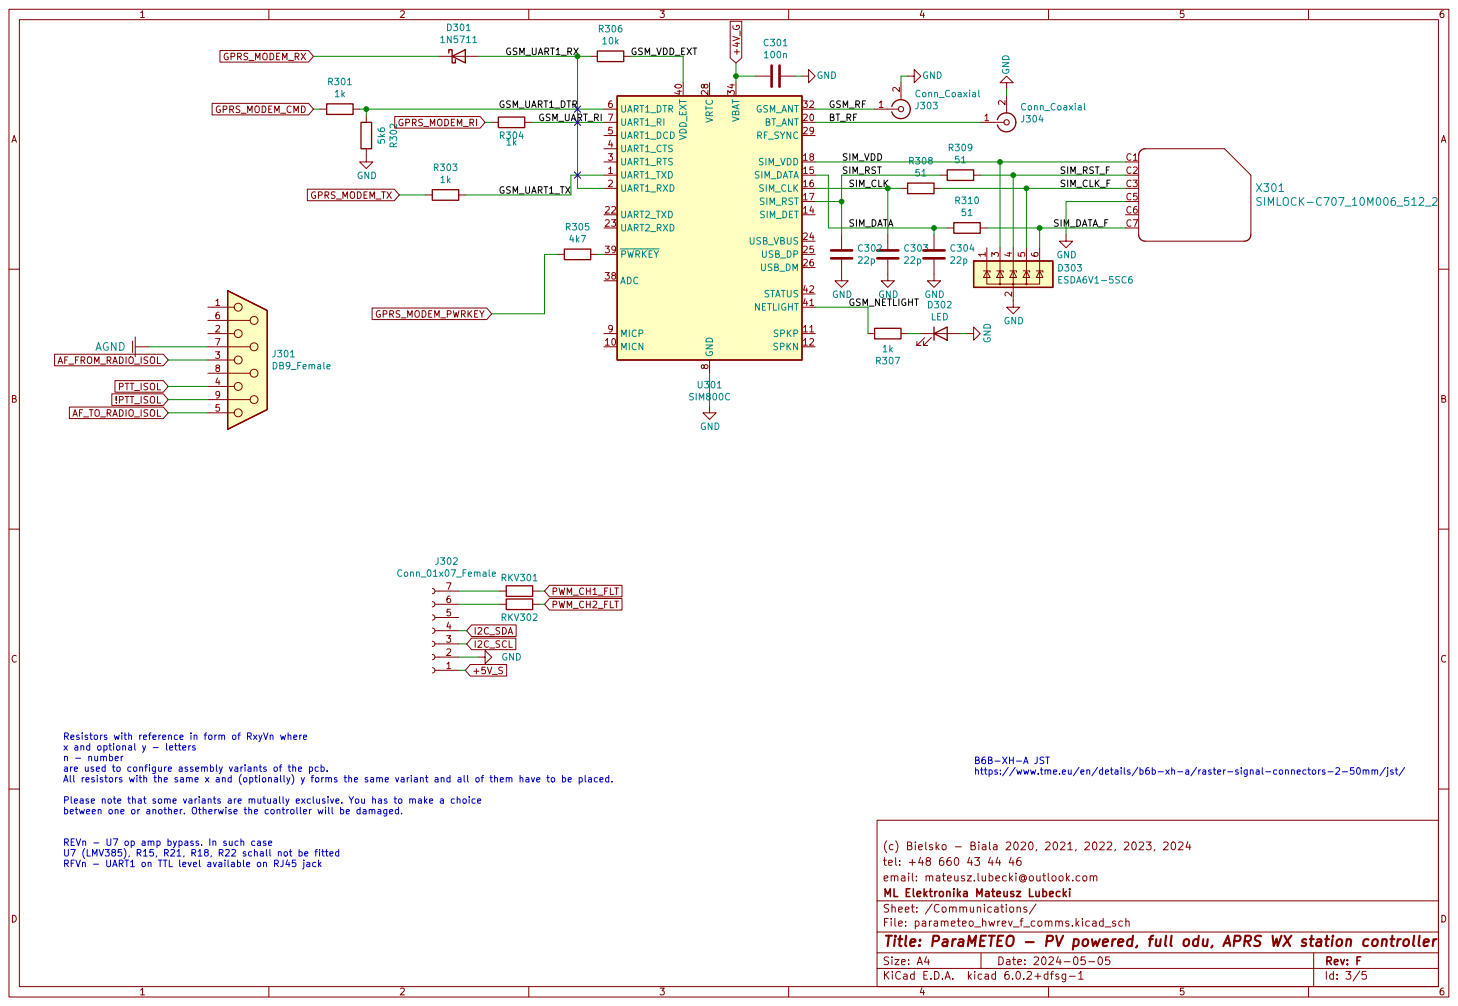
[picture p34: page 3]

Resistors with reference in form of RxyVn where
x and optional y - letters n - number are used to configure assembly variants of the pcb.
All resistors with the same x and (optionally) y forms the same variant and all of them have to be placed.

https://www.tme.eu/en/details/b6b-xh-a/raster-signal-connectors-2-50mm/jst/

Please note that some variants are mutually exclusive. You has to make a choice

REVn - U7 op amp bypass. In such case
U7 (LMV385), R15, R21, R18, R22 schall not be fitted
RFVn - UART1 on TTL level available on RJ45 jack

(c) Bielsko - Biala 2020, 2021, 2022, 2023, 2024
tel: +48 660 43 44 46
File: parameteo_hwrev_f_comms.kicad_sch Sheet: /Communications/ ML Elektronika Mateusz Lubecki email: mateusz.lubecki@outlook.com

Id: 3/5 Title: ParaMETEO - PV powered, full odu, APRS WX station controller

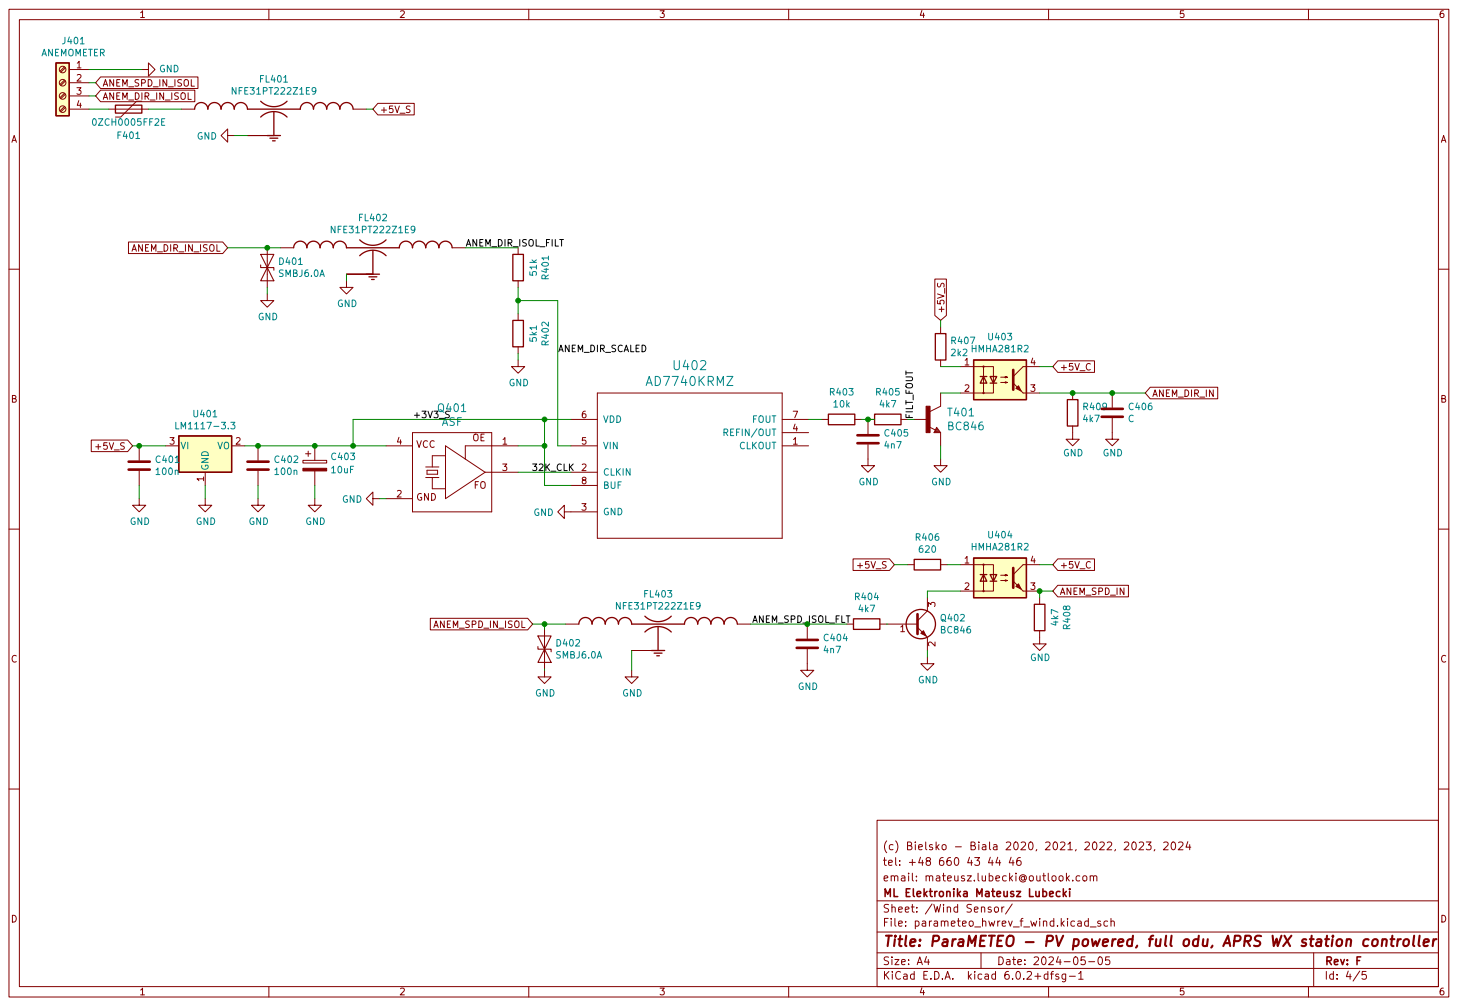
[picture p35: page 4]

(c) Bielsko - Biala 2020, 2021, 2022, 2023, 2024
tel: +48 660 43 44 46
File: parameteo_hwrev_f_wind.kicad_sch Sheet: /Wind Sensor/ ML Elektronika Mateusz Lubecki email: mateusz.lubecki@outlook.com

Id: 4/5 Title: ParaMETEO - PV powered, full odu, APRS WX station controller

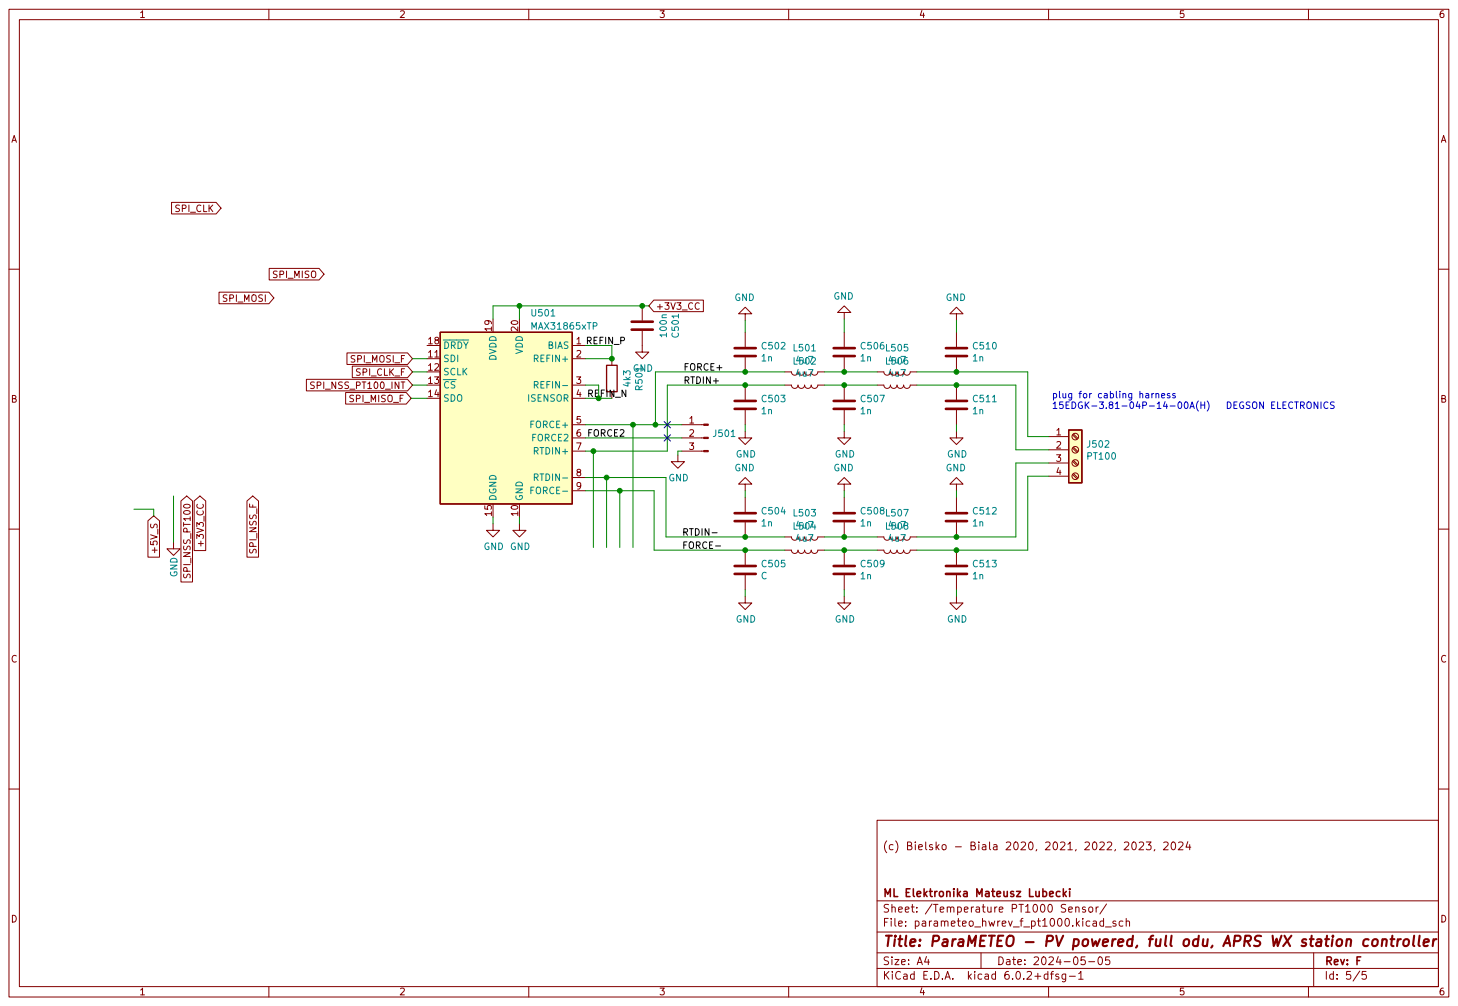
[picture p36: page 5]

Sheet: /Temperature PT1000 Sensor/ ML Elektronika Mateusz Lubecki (c) Bielsko - Biala 2020, 2021, 2022, 2023, 2024 R501 4k3

File: parameteo_hwrev_f_pt1000.kicad_sch
Id: 5/5 Title: ParaMETEO - PV powered, full odu, APRS WX station controller
