SP8EBC/ParaTNC/src/configuration_nvm/configuration_handler.c

/*
 * configuration_handler.c
 *
 *  Created on: Apr 28, 2021
 *      Author: mateusz
 */

#include <configuration_nvm/config_data.h>
#include <configuration_nvm/config_data_externs.h>
#include <configuration_nvm/configuration_handler.h>
#include "station_config_target_hw.h"

#include "io_default_vbat_scaling.h"

#include "main.h"

#ifdef STM32F10X_MD_VL
#include <stm32f10x.h>
#include <stm32f10x_crc.h>
#include <stm32f10x_flash.h>
#endif

#ifdef STM32L471xx
#include "./drivers/l4/flash_stm32l4x.h"
#include <stm32l4xx.h>
#include <stm32l4xx_ll_crc.h>
#endif

/**
 * STM32L476RE, 512KB flash mem, last flash memory page
 * 0x0807F800 - 0x0807FFFF; 2 K; Page 383
 *
 *  __config_section_default_start =    0x0801E000;
    __config_section_first_start = 	    0x0801E800;		// page 61, 0x3D
    __config_section_second_start =     0x0801F000;		// page 62, 0x3E
    __config_section_third_start =      0x0801F800;		// page 63, 0x3F
 *
 */

#define CONFIG_SECTION_FIRST_START 		0x0801E800
#define CONFIG_SECTION_SECOND_START		0x0801F000
#define CONFIG_SECTION_DEFAULT_START	0x0801E000

#define CONFIG_MODE_PGM_CNTR	0x0
#define CONFIG_MODE_OFSET		0x20			//	Current size: 0x14, free: 0x0C
#define CONFIG_BASIC_OFFSET		0x40			//	Current size: 0xA6, free: 0x3A
#define CONFIG_SOURCES_OFFSET	0x120			//	Current size: 0x8,  free: 0x18
#define CONFIG_UMB_OFFSET		0x140			//	Current size: 0x10, free: 0x10
#define CONFIG_RTU_OFFSET		0x160			//	Current size: 0x10, free: 0x90
#define CONFIG_GSM_OFFSET		0x200			//	Current size: 0x114,
#define CONFIG__END__OFFSET		0x7E0

#include <string.h>

const uint32_t * const config_section_first_start = 		(const uint32_t *)CONFIG_SECTION_FIRST_START;
const uint32_t * const config_section_second_start = 		(const uint32_t *)CONFIG_SECTION_SECOND_START;
const uint32_t * const config_section_default_start = 		(const uint32_t *)CONFIG_SECTION_DEFAULT_START;

#ifdef PARAMETEO
#define STRUCT_COUNT 6
#endif

#ifdef STM32L471xx
const uint16_t * config_data_pgm_cntr_first_ptr		= (uint16_t*)(CONFIG_SECTION_FIRST_START + CONFIG_MODE_PGM_CNTR);
const uint16_t * config_data_pgm_cntr_second_ptr	= (uint16_t*)(CONFIG_SECTION_SECOND_START + CONFIG_MODE_PGM_CNTR);

const config_data_mode_t * config_data_mode_first_ptr 				= (const config_data_mode_t * )		(CONFIG_SECTION_FIRST_START + CONFIG_MODE_OFSET);
const config_data_basic_t * config_data_basic_first_ptr 			= (const config_data_basic_t *)		(CONFIG_SECTION_FIRST_START + CONFIG_BASIC_OFFSET);
const config_data_wx_sources_t * config_data_wx_sources_first_ptr 	= (const config_data_wx_sources_t *)(CONFIG_SECTION_FIRST_START + CONFIG_SOURCES_OFFSET);
const config_data_umb_t * config_data_umb_first_ptr					= (const config_data_umb_t *)		(CONFIG_SECTION_FIRST_START + CONFIG_UMB_OFFSET);
const config_data_rtu_t * config_data_rtu_first_ptr					= (const config_data_rtu_t *)		(CONFIG_SECTION_FIRST_START + CONFIG_RTU_OFFSET);
const config_data_gsm_t * config_data_gsm_first_ptr					= (const config_data_gsm_t *)		(CONFIG_SECTION_FIRST_START + CONFIG_GSM_OFFSET);

const config_data_mode_t * config_data_mode_second_ptr 						= (const config_data_mode_t * )		(CONFIG_SECTION_SECOND_START + CONFIG_MODE_OFSET);
const config_data_basic_t * config_data_basic_second_ptr 					= (const config_data_basic_t *)		(CONFIG_SECTION_SECOND_START + CONFIG_BASIC_OFFSET);
const config_data_wx_sources_t * config_data_wx_sources_second_ptr			= (const config_data_wx_sources_t *)(CONFIG_SECTION_SECOND_START + CONFIG_SOURCES_OFFSET);
const config_data_umb_t * config_data_umb_second_ptr 						= (const config_data_umb_t *)		(CONFIG_SECTION_SECOND_START + CONFIG_UMB_OFFSET);
const config_data_rtu_t * config_data_rtu_second_ptr						= (const config_data_rtu_t *)		(CONFIG_SECTION_SECOND_START + CONFIG_RTU_OFFSET);
const config_data_gsm_t * config_data_gsm_second_ptr						= (const config_data_gsm_t *)		(CONFIG_SECTION_SECOND_START + CONFIG_GSM_OFFSET);

const config_data_gsm_t * config_data_gsm_default_ptr = (const config_data_gsm_t *)&config_data_gsm_default;

#endif

#ifdef STM32F10X_MD_VL

#define STRUCT_COUNT 5
const uint16_t * config_data_pgm_cntr_first_ptr		= &config_data_pgm_cntr_first;
const uint16_t * config_data_pgm_cntr_second_ptr	= &config_data_pgm_cntr_second;

const config_data_mode_t * config_data_mode_first_ptr 				= &config_data_mode_first;
const config_data_basic_t * config_data_basic_first_ptr 			= &config_data_basic_first;
const config_data_wx_sources_t * config_data_wx_sources_first_ptr 	= &config_data_wx_sources_first;
const config_data_umb_t * config_data_umb_first_ptr					= &config_data_umb_first;
const config_data_rtu_t * config_data_rtu_first_ptr					= &config_data_rtu_first;

const config_data_mode_t * config_data_mode_second_ptr 						= &config_data_mode_second;
const config_data_basic_t * config_data_basic_second_ptr 					= &config_data_basic_second;
const config_data_wx_sources_t * config_data_wx_sources_second_ptr			= &config_data_wx_sources_second;
const config_data_umb_t * config_data_umb_second_ptr 						= &config_data_umb_second;
const config_data_rtu_t * config_data_rtu_second_ptr						= &config_data_rtu_second;

#endif

#define CRC_OFFSET				0x7F8
#define CRC_16B_WORD_OFFSET		CRC_OFFSET / 2
#define CRC_32B_WORD_OFFSET		CRC_OFFSET / 4

#define CONFIG_SECTION_LN 0x800

#define FEND	(uint8_t)0xC0
#define FESC	(uint8_t)0xDB
#define TFEND	(uint8_t)0xDC
#define TFESC	(uint8_t)0xDD

#define KISS_GET_RUNNING_CONFIG 	(uint8_t) 0x20
#define KISS_RUNNING_CONFIG			(uint8_t) 0x70

volatile extern const config_data_basic_t config_data_basic_default;
volatile extern const config_data_mode_t config_data_mode_default;
volatile extern const config_data_umb_t config_data_umb_default;
volatile extern const config_data_rtu_t config_data_rtu_default;
volatile extern const config_data_wx_sources_t config_data_wx_sources_default;

configuration_handler_region_t configuration_handler_loaded;

uint8_t config_kiss_flash_state = 0;

#define WAIT_FOR_PGM_COMPLETION			\
	while (1) {\
		flash_status = FLASH_GetBank1Status();				\
															\
		if (flash_status == FLASH_BUSY) {					\
			;												\
		}													\
		else if (flash_status == FLASH_ERROR_PG) {			\
			out = -1;										\
			break;											\
		}													\
		else {												\
			break;											\
		}													\
	}														\

static int configuration_handler_program_counter(uint16_t counter, int8_t bank) {

	int out = 0;

	// flash operation result
	FLASH_Status flash_status = 0;

	// unlock flash memory
	FLASH_Unlock();

	// enable programming
	FLASH->CR |= FLASH_CR_PG;

#ifdef STM32F10X_MD_VL
	if (bank == 1) {
		// set programming counter. If second region is also screwed the first one will be used as a source
		// if second is OK it will be used instead (if its programming counter has value three or more).
		*(uint16_t*)&config_data_pgm_cntr_first = counter;
	}
	else {
		// set programming counter. If second region is also screwed the first one will be used as a source
		// if second is OK it will be used instead (if its programming counter has value three or more).
		*(uint16_t*)&config_data_pgm_cntr_second = counter;
	}

#endif

#ifdef STM32L471xx
	if (bank == 1) {
		// set programming counter. If second region is also screwed the first one will be used as a source
		// if second is OK it will be used instead (if its programming counter has value three or more).
		*((uint32_t*)(config_data_pgm_cntr_first_ptr)) = counter;
		WAIT_FOR_PGM_COMPLETION

		*((uint32_t*)(config_data_pgm_cntr_first_ptr)+ 1) = 0xFFFFFFFFu;
		WAIT_FOR_PGM_COMPLETION

	}
	else {
		// set programming counter. If second region is also screwed the first one will be used as a source
		// if second is OK it will be used instead (if its programming counter has value three or more).
		*((uint32_t*)(config_data_pgm_cntr_second_ptr)) = counter;
		WAIT_FOR_PGM_COMPLETION

		*((uint32_t*)(config_data_pgm_cntr_second_ptr) + 1) = 0xFFFFFFFFu;
		WAIT_FOR_PGM_COMPLETION

	}
#endif
	// disable programming
	FLASH->CR &= (0xFFFFFFFF ^ FLASH_CR_PG);

	// lock the memory back
	FLASH_Lock();

	return out;
}

static int configuration_handler_program_crc(uint32_t crc, int8_t bank) {

	int out = 0;

	// flash operation result
	FLASH_Status flash_status = 0;

	// unlock flash memory
	FLASH_Unlock();

	// enable programming
	FLASH->CR |= FLASH_CR_PG;

#ifdef STM32F10X_MD_VL
	uint16_t * dst = 0;

	if (bank == 1) {
		dst = (uint16_t *)(config_section_first_start) + CRC_16B_WORD_OFFSET;
	}
	else if (bank == 2) {
		dst = (uint16_t *)(config_section_second_start) + CRC_16B_WORD_OFFSET;
	}

	// program the CRC value
	*dst = (uint16_t)(crc & 0xFFFF);
	WAIT_FOR_PGM_COMPLETION
	*(dst + 1) = (uint16_t)((crc & 0xFFFF0000) >> 16);

	flash_status = FLASH_GetBank1Status();

	if (flash_status != FLASH_COMPLETE) {
		out = -2;	// exit from the loop in case of programming error
	}
#endif

#ifdef STM32L471xx
	if (bank == 1) {
		// program the CRC value
		*(uint32_t*)((uint32_t *)config_section_first_start + CRC_32B_WORD_OFFSET) = (uint32_t)(crc);
		WAIT_FOR_PGM_COMPLETION
		*(uint32_t*)((uint32_t *)config_section_first_start + CRC_32B_WORD_OFFSET + 1) = 0xFFFFFFFFu;
		WAIT_FOR_PGM_COMPLETION

	}
	else if (bank == 2) {
		// program the CRC value
		*(uint32_t*)((uint32_t *)config_section_second_start + CRC_32B_WORD_OFFSET) = (uint32_t)(crc);
		WAIT_FOR_PGM_COMPLETION
		*(uint32_t*)((uint32_t *)config_section_second_start + CRC_32B_WORD_OFFSET + 1) = 0xFFFFFFFFu;
		WAIT_FOR_PGM_COMPLETION

	}
	else {
		out = -3;
	}


#endif

	// disable programming
	FLASH->CR &= (0xFFFFFFFF ^ FLASH_CR_PG);

	// lock the memory back
	FLASH_Lock();

	return out;
}

static int configuration_handler_program_data(volatile void * source, volatile void * destination, uint16_t size) {

	int out = 0;

	int i = 0;

	// flash operation result
	FLASH_Status flash_status = 0;

	// unlock flash memory
	FLASH_Unlock();

#ifdef STM32F10X_MD_VL
	// source pointer
	volatile uint16_t * src = (uint16_t *)source;

	// destination pointer for flash reprogramming
	volatile uint16_t * dst = (uint16_t *)destination;

	// amount of 16 bit words to copy across the memory
	uint16_t siz = size / 2;
#endif

#ifdef STM32L471xx
	// source pointer
	volatile uint32_t * src = (uint32_t *)source;

	// destination pointer for flash reprogramming
	volatile uint32_t * dst = (uint32_t *)destination;

	// amount of 32 bit words to copy across the memory
	uint16_t siz = size / 4;
#endif

	// enable programming
	FLASH->CR |= FLASH_CR_PG;

	// if so reprogram first section
	for (i = 0; i < siz; i++) {

		// copy data
		*(dst + i) = *(src + i);

		WAIT_FOR_PGM_COMPLETION
	}

#ifdef STM32L471xx
	// this family supports only 64 bit aligned in-application flash programming
	if ((siz % 2) != 0) {
		// if size is an odd number pad with extra 0xFFFFFF
		*(dst + i) = 0xFFFFFFFFu;

		// check current status
		flash_status = FLASH_GetBank1Status();
	}
#endif

	// disable programming
	FLASH->CR &= (0xFFFFFFFF ^ FLASH_CR_PG);

	// lock the memory back
	FLASH_Lock();

	return out;
}

uint32_t configuration_handler_check_crc(void) {

	// last four bytes of a configuration blocks holds the CRC32 value itself.
	// four bytes before CRC is used to store programming timestamp,
	// which is not included into CRC calculation.
	// four bytes AFTER a crc is not used at all and is kept due to
	// STM32L4xx target limitations which require 64 bit aligned write block size

	uint32_t out = 0;

	// crc stored in the configuration section
	uint32_t crc_expected = 0;

	// calculated CRC value
	uint32_t crc_current = 0;

	// calculate CRC over everything from config_section_first except last 12 bytes
	crc_current = calcCRC32std(config_section_first_start, CRC_OFFSET - 4, 0x04C11DB7, 0xFFFFFFFF, 0, 0, 0);

	// expected crc is stored in the last 32b word of the configuration section
	crc_expected = *(config_section_first_start + CRC_32B_WORD_OFFSET);

	// check if calculated CRC value match value stored in flash memory
	if (crc_expected == crc_current) {
		out |= 0x01;
	}

	// and do the same but for second section
	crc_current = calcCRC32std(config_section_second_start, CRC_OFFSET - 4, 0x04C11DB7, 0xFFFFFFFF, 0, 0, 0);

	//crc_expected = *__config_section_second_end;
	crc_expected = *(config_section_second_start + CRC_32B_WORD_OFFSET);

	// check if calculated CRC value match value stored in flash memory
	if (crc_expected == crc_current) {
		out |= 0x02;
	}
	return out;
}

uint32_t configuration_handler_restore_default_first(void) {

	uint32_t out = 0;

	// loop iterators
	int i = 0;
	int8_t config_struct_it = 0;

	// source pointer
	volatile void * source = 0x00;

	// destination pointer for flash reprogramming
	volatile void * target = 0x00;

	// amount of 16 bit words to copy across the memory
	uint16_t size = 0;

	// target region CRC value to be stored in the flash memory
	uint32_t target_crc_value = 0;

	// flash operation result
	FLASH_Status flash_status = 0;

	int comparision_result = 0;

#ifdef STM32F10X_MD_VL
	FLASH_Unlock();
#endif

	// erase first page
	flash_status = FLASH_ErasePage((uint32_t)config_section_first_start);
	flash_status = FLASH_ErasePage((uint32_t)config_section_first_start + 0x400);

	// check if erasure was completed successfully
	if (flash_status == FLASH_COMPLETE) {

		for (config_struct_it = 0; config_struct_it < STRUCT_COUNT; config_struct_it++) {

			// set pointers
			switch (config_struct_it) {
				case 0:	// mode
					source = (void *) &config_data_mode_default;
					target = (void *) config_data_mode_first_ptr;
					size = sizeof(config_data_mode_t);			// divide two for 16bit programming, divide four for
					break;
				case 1:	// basic
					source = (void *) &config_data_basic_default;
					target = (void *) config_data_basic_first_ptr;
					size = sizeof(config_data_basic_t);
					break;
				case 2:	// sources
					source = (void *) &config_data_wx_sources_default;
					target = (void *) config_data_wx_sources_first_ptr;
					size = sizeof(config_data_wx_sources_t);
					break;
				case 3:
					source = (void *) &config_data_umb_default;
					target = (void *) config_data_umb_first_ptr;
					size = sizeof(config_data_umb_t);
					break;
				case 4:
					source = (void *) &config_data_rtu_default;
					target = (void *) config_data_rtu_first_ptr;
					size = sizeof(config_data_rtu_t);
					break;
#ifdef PARAMETEO
				case 5:
					source = (void *) &config_data_gsm_default;
					target = (void *) config_data_gsm_first_ptr;
					size = sizeof(config_data_gsm_t);
					break;
#endif
			}

			// program data
			configuration_handler_program_data(source, target, size);

			// verify programming
			comparision_result = memcmp((const void * )target, (const void * )source, size);

			if (comparision_result != 0) {
				// quit from the
				out = -1;

				return out;
			}
		}
	}
	else {
		return -2;
	}

	configuration_handler_program_counter(0x0002u, 1);

	// set programming counter. If second region is also screwed the first one will be used as a source
	// if second is OK it will be used instead (if its programming counter has value three or more).
	//*(uint16_t*)&config_data_pgm_cntr_first = 0x0002u;

	target_crc_value = calcCRC32std(config_section_first_start, CRC_OFFSET - 4, 0x04C11DB7, 0xFFFFFFFF, 0, 0, 0);

	out = configuration_handler_program_crc(target_crc_value, 1);

	// disable programming
	FLASH->CR &= (0xFFFFFFFF ^ FLASH_CR_PG);

	// lock the memory back
	FLASH_Lock();

	return out;

}

uint32_t configuration_handler_restore_default_second(void) {
	uint32_t out = 0;

	// loop iterators
	int i = 0;
	int8_t config_struct_it = 0;

	// source pointer
	volatile void * source = 0x00;

	// destination pointer for flash reprogramming
	volatile void * target = 0x00;

	// amount of 16 bit words to copy across the memory
	uint16_t size = 0;

	// target region CRC value to be stored in the flash memory
	uint32_t target_crc_value = 0;

	// flash operation result
	FLASH_Status flash_status = 0;

	int comparision_result = 0;

#ifdef STM32F10X_MD_VL
	FLASH_Unlock();
#endif

	// erase first page
	flash_status = FLASH_ErasePage((uint32_t)config_section_second_start);
	flash_status = FLASH_ErasePage((uint32_t)config_section_second_start + 0x400);

	// check if erasure was completed successfully
	if (flash_status == FLASH_COMPLETE) {

		for (config_struct_it = 0; config_struct_it < STRUCT_COUNT; config_struct_it++) {

			// set pointers
			switch (config_struct_it) {
				case 0:	// mode
					source = (void *) &config_data_mode_default;
					target = (void *) config_data_mode_second_ptr;
					size = sizeof(config_data_mode_t);
					break;
				case 1:	// basic
					source = (void *) &config_data_basic_default;
					target = (void *) config_data_basic_second_ptr;
					size = sizeof(config_data_basic_t);
					break;
				case 2:	// sources
					source = (void *) &config_data_wx_sources_default;
					target = (void *) config_data_wx_sources_second_ptr;
					size = sizeof(config_data_wx_sources_t);
					break;
				case 3:
					source = (void *) &config_data_umb_default;
					target = (void *) config_data_umb_second_ptr;
					size = sizeof(config_data_umb_t);
					break;
				case 4:
					source = (void *) &config_data_rtu_default;
					target = (void *) config_data_rtu_second_ptr;
					size = sizeof(config_data_rtu_t);
					break;
#ifdef PARAMETEO
				case 5:
					source = (void *) &config_data_gsm_default;
					target = (void *) config_data_gsm_second_ptr;
					size = sizeof(config_data_gsm_t);
					break;
#endif
			}

			// program data
			configuration_handler_program_data(source, target, size);

			// verify programming
			comparision_result = memcmp((const void * )target, (const void * )source, size);

			if (comparision_result != 0) {
				// quit from the
				out = -1;

				return out;
			}
		}
	}
	else {
		return -2;
	}

	configuration_handler_program_counter(0x0003u, 2);

	// set programming counter. If second region is also screwed the first one will be used as a source
	// if second is OK it will be used instead (if its programming counter has value three or more).
	//*(uint16_t*)&config_data_pgm_cntr_second = 0x0002u;

	target_crc_value = calcCRC32std(config_section_second_start, CRC_OFFSET - 4, 0x04C11DB7, 0xFFFFFFFF, 0, 0, 0);

	out = configuration_handler_program_crc(target_crc_value, 2);

	// disable programming
	FLASH->CR &= (0xFFFFFFFF ^ FLASH_CR_PG);

	// lock the memory back
	FLASH_Lock();

	return out;
}

void configuration_handler_load_configuration(configuration_handler_region_t region) {

#ifdef STM32L471xx
	if (region == REGION_DEFAULT) {
		main_config_data_gsm = config_data_gsm_default_ptr;
	}
	else if (region == REGION_FIRST) {
		main_config_data_gsm = config_data_gsm_first_ptr;
	}
	else if (region == REGION_SECOND) {
		main_config_data_gsm = config_data_gsm_second_ptr;
	}
	else {
		;
	}
#endif

	if (region == REGION_DEFAULT) {
		main_config_data_mode = &config_data_mode_default;
		main_config_data_basic = &config_data_basic_default;
		main_config_data_wx_sources = &config_data_wx_sources_default;
		main_config_data_umb = &config_data_umb_default;
		main_config_data_rtu = &config_data_rtu_default;
	}
	else if (region == REGION_FIRST) {
		main_config_data_mode = config_data_mode_first_ptr;
		main_config_data_basic = config_data_basic_first_ptr;
		main_config_data_wx_sources = config_data_wx_sources_first_ptr;
		main_config_data_umb = config_data_umb_first_ptr;
		main_config_data_rtu = config_data_rtu_first_ptr;
	}
	else if (region == REGION_SECOND) {
		main_config_data_mode = config_data_mode_second_ptr;
		main_config_data_basic = config_data_basic_second_ptr;
		main_config_data_wx_sources = config_data_wx_sources_second_ptr;
		main_config_data_umb = config_data_umb_second_ptr;
		main_config_data_rtu = config_data_rtu_second_ptr;
	}
	else {
		;
	}

	configuration_handler_loaded = region;

}

configuration_erase_startup_t configuration_handler_erase_startup(void) {
	// flash operation result
	FLASH_Status flash_status = 0;

	uint32_t page_address;

	if (configuration_handler_loaded == REGION_FIRST) {
		page_address = (uint32_t)config_section_second_start;
	}
	else if (configuration_handler_loaded == REGION_SECOND) {
		page_address = (uint32_t)config_section_first_start;
	}
	else {
		return ERASE_STARTUP_IDLE;
	}


#ifdef STM32F10X_MD_VL
	FLASH_Unlock();
#endif

	// erase page
	flash_status = FLASH_ErasePage((uint32_t)page_address);
	flash_status = FLASH_ErasePage((uint32_t)page_address + 0x400);

	// lock the memory back
	FLASH_Lock();

	if (flash_status == FLASH_COMPLETE) {
		return ERASE_STARTUP_DONE;
	}
	else {
		return ERASE_STARTUP_ERROR;
	}
}

configuration_erase_startup_t configuration_handler_program_startup(uint8_t * data, uint8_t dataln, uint16_t offset) {

	int comparision_result;

	// flash operation result
	int flash_status = 0;

	// source pointer
	volatile void * source = data;

	// destination pointer for flash reprogramming
	volatile void * target = 0x00;

	if (configuration_handler_loaded == REGION_FIRST) {
		target = (void *)config_section_second_start + offset;
	}
	else if (configuration_handler_loaded == REGION_SECOND) {
		target = (void *)config_section_first_start + offset;
	}
	else {
		return ERASE_STARTUP_IDLE;
	}

	if ((dataln % 8) != 0) {
		return ERASE_STARTUP_IDLE;

	}

	// program data
	flash_status = configuration_handler_program_data(source, target, dataln);

	if (flash_status == 0) {

		// verify programming
		comparision_result = memcmp((const void * )target, (const void * )source, dataln);

		if (comparision_result == 0) {
			return ERASE_STARTUP_DONE;
		}
		else {
			return ERASE_STARTUP_ERROR;
		}

		return ERASE_STARTUP_DONE;
	}
	else {
		return ERASE_STARTUP_ERROR;
	}

}

uint32_t configuration_get_register(void) {

	uint32_t out = 0;

#ifdef STM32F10X_MD_VL
	out = BKP->DR3;
#endif

#ifdef STM32L471xx
	out = RTC->BKP3R;

#endif

	return out;
}

void configuration_set_register(uint32_t value) {
#ifdef STM32F10X_MD_VL
	BKP->DR3 = value;
#endif

#ifdef STM32L471xx
	// enable access to backup domain
	PWR->CR1 |= PWR_CR1_DBP;

	RTC->BKP3R = value;

	PWR->CR1 &= (0xFFFFFFFF ^ PWR_CR1_DBP);

#endif
}

void configuration_set_bits_register(uint32_t value) {
#ifdef STM32F10X_MD_VL
	BKP->DR3 |= value;
#endif

#ifdef STM32L471xx
	// enable access to backup domain
	PWR->CR1 |= PWR_CR1_DBP;

	RTC->BKP3R |= value;

	PWR->CR1 &= (0xFFFFFFFF ^ PWR_CR1_DBP);

#endif
}

void configuration_clear_bits_register(uint32_t value) {
#ifdef STM32F10X_MD_VL
	BKP->DR3 &= (0xFFFF ^ value);
#endif

#ifdef STM32L471xx
	// enable access to backup domain
	PWR->CR1 |= PWR_CR1_DBP;

	RTC->BKP3R &= (0xFFFFFFFF ^ value);

	PWR->CR1 &= (0xFFFFFFFF ^ PWR_CR1_DBP);

#endif
}

configuration_handler_region_t configuration_get_current(uint32_t * size) {
	if (size != 0x00) {
		*size = CONFIG_SECTION_LN;
	}

	return configuration_handler_loaded;
}

const uint32_t * configuration_get_address(configuration_handler_region_t region) {
	switch (region) {
	case REGION_FIRST:
		return config_section_first_start;
		break;
	case REGION_SECOND:
		return config_section_second_start;
		break;
	default:
		return config_section_default_start;
	}

}

int configuration_get_inhibit_wx_pwr_handle(void) {

	int out = 0;

	if ((main_config_data_basic->engineering1 & ENGINEERING1) == 0) {
		if ((main_config_data_basic->engineering1 & ENGINEERING1_INH_WX_PWR_HNDL) != 0) {
			out = 1;
		}
	}

	return out;
}

int configuration_get_early_tx_assert(void) {
	int out = 0;

	if ((main_config_data_basic->engineering1 & ENGINEERING1) == 0) {
		if ((main_config_data_basic->engineering1 & ENGINEERING1_EARLY_TX_ASSERT) != 0) {
			out = 1;
		}
	}

	return out;
}

int configuration_get_power_cycle_gsmradio_on_no_communications(void) {
	int out = 0;

	if ((main_config_data_basic->engineering1 & ENGINEERING1) == 0) {
		if ((main_config_data_basic->engineering1 & ENGINEERING1_PWRCYCLE_GSM_ON_NOCOMM) != 0) {
			out = 1;
		}
	}

	return out;
}

int configuration_get_power_cycle_vbat_r(void) {

	int out = 0;

	if ((main_config_data_basic->engineering2 & ENGINEERING2) == 0) {
		if ((main_config_data_basic->engineering2 & ENGINEERING2_POWER_CYCLE_R) != 0) {
			out = 1;
		}
	}

	return out;
}

int configuration_get_reboot_after_24_hours(void) {
	int out = 0;

	if ((main_config_data_basic->engineering2 & ENGINEERING2) == 0) {
		if ((main_config_data_basic->engineering2 & ENGINEERING2_REBOOT_AFTER_24) != 0) {
			out = 1;
		}
	}

	return out;
}

uint16_t configuration_get_vbat_a_coeff(void) {

	uint16_t out = 0;

	// get coefficient stored into flash memory
	out = main_config_data_basic->battery_scalling_a;

	// check if it is set to non default value
	if (out == 0x00 || out == 0xFF) {
		// revert back to hardcoded value
		out = VBAT_MEAS_A_COEFF;
	}

	return out;
}


uint16_t configuration_get_vbat_b_coeff(void) {

	uint16_t out = 0;

	// get coefficient stored into flash memory
	out = main_config_data_basic->battery_scalling_b;

	// check if it is set to non default value
	if (out == 0x00 || out == 0xFF) {
		// revert back to hardcoded value
		out = VBAT_MEAS_B_COEFF;
	}

	return out;
}

configuration_button_function_t configuration_get_left_button(void) {
	configuration_button_function_t out = BUTTON_DISABLED;

	switch (main_config_data_basic->button_one_left) {
		case 1:	out = BUTTON_SEND_WX; 			break;
		case 2:	out = BUTTON_SEND_WX_INTERNET; 	break;
		case 3:	out = BUTTON_SEND_BEACON;		break;
		case 4:	out = BUTTON_FORCE_UART_KISS;	break;
		case 5: out = BUTTON_FORCE_UART_LOG;	break;
		case 6: out = BUTTON_RESET_GSM_GPRS;	break;
		case 7: out = BUTTON_RECONNECT_APRSIS; break;
	}

	return out;
}


configuration_button_function_t configuration_get_right_button(void) {
	configuration_button_function_t out = BUTTON_DISABLED;

	switch (main_config_data_basic->button_two_right) {
		case 1:	out = BUTTON_SEND_WX; 			break;
		case 2:	out = BUTTON_SEND_WX_INTERNET; 	break;
		case 3:	out = BUTTON_SEND_BEACON;		break;
		case 4:	out = BUTTON_FORCE_UART_KISS;	break;
		case 5: out = BUTTON_FORCE_UART_LOG;	break;
		case 6: out = BUTTON_RESET_GSM_GPRS;	break;
		case 7: out = BUTTON_RECONNECT_APRSIS; break;
	}

	return out;
}

/**
 * This function check if security access must be unlocked to execute given
 * UDS service
 * @param medium
 * @param routine_type
 * @return
 */
int configuration_get_is_security_access_required(uint8_t medium, uint8_t routine_type) {

}
