SP8EBC/ParaTNC/include/main_freertos_externs.h

/*
 * main_freertos_externs.h
 *
 *  Created on: Aug 17, 2025
 *      Author: mateusz
 */

#ifndef MAIN_FREERTOS_EXTERNS_H_
#define MAIN_FREERTOS_EXTERNS_H_

#include <FreeRTOS.h>
#include <event_groups.h>

/// ==================================================================================================
///	GLOBAL DEFINITIONS
/// ==================================================================================================
// clang-format off
#define MAIN_EVENTGROUP_PWRSAVE_ONE_MIN			(1 << 0)
#define MAIN_EVENTGROUP_PWRSAVE_ONE_SEC			(1 << 1)
#define MAIN_EVENTGROUP_PWRSAVE_TWO_SEC			(1 << 2)
#define MAIN_EVENTGROUP_PWRSAVE_TEN_SEC			(1 << 4)
#define MAIN_EVENTGROUP_PWRSAVE_MAIN			(1 << 5)
#define MAIN_EVENTGROUP_PWRSAVE_FANET			(1 << 6)
#define MAIN_EVENTGROUP_PWRSAVE_EV_SRL_KISS_RX	(1 << 7)
#define MAIN_EVENTGROUP_PWRSAVE_EV_SRL_KISS_TX	(1 << 8)
#define MAIN_EVENTGROUP_PWRSAVE_EV_SRL_GSM_RX	(1 << 9)
#define MAIN_EVENTGROUP_PWRSAVE_EV_SRL_GSM_TX	(1 << 10)
#define MAIN_EVENTGROUP_PWRSAVE_EV_SRL_SENSOR	(1 << 11)
#define MAIN_EVENTGROUP_PWRSAVE_EV_APRS_TRIG	(1 << 12)

#define MAIN_EVENTGROUP_WAIT_FOR	(									\
									MAIN_EVENTGROUP_PWRSAVE_ONE_MIN |	\
									MAIN_EVENTGROUP_PWRSAVE_ONE_SEC |	\
									MAIN_EVENTGROUP_PWRSAVE_TWO_SEC |	\
									MAIN_EVENTGROUP_PWRSAVE_TEN_SEC |	\
									MAIN_EVENTGROUP_PWRSAVE_MAIN	|	\
									MAIN_EVENTGROUP_PWRSAVE_FANET	|	\
									MAIN_EVENTGROUP_PWRSAVE_EV_SRL_KISS_RX	|	\
									MAIN_EVENTGROUP_PWRSAVE_EV_SRL_KISS_TX	|	\
									MAIN_EVENTGROUP_PWRSAVE_EV_SRL_GSM_RX		|	\
									MAIN_EVENTGROUP_PWRSAVE_EV_SRL_GSM_TX		|	\
									MAIN_EVENTGROUP_PWRSAVE_EV_SRL_SENSOR		|	\
									MAIN_EVENTGROUP_PWRSAVE_EV_APRS_TRIG	\
									)


#define MAIN_EVENTGROUP_SERIAL_KISS_RX_DONE		(1 << 0)
#define MAIN_EVENTGROUP_SERIAL_GSM_RX_DONE		(1 << 1)
#define MAIN_EVENTGROUP_SERIAL_GSM_TX_DONE		(1 << 2)
#define MAIN_EVENTGROUP_SERIAL_KISS_TX_DONE		(1 << 3)
#define MAIN_EVENTGROUP_SERIAL_WX_RX_DONE		(1 << 4)
#define MAIN_EVENTGROUP_SERIAL_WX_RX_ERROR		(1 << 5)
#define MAIN_EVENTGROUP_SERIAL_WX_TX_DONE		(1 << 6)

#define MAIN_EVENTGROUP_SERIAL_WX	(MAIN_EVENTGROUP_SERIAL_WX_RX_DONE | \
									MAIN_EVENTGROUP_SERIAL_WX_RX_ERROR | \
									MAIN_EVENTGROUP_SERIAL_WX_TX_DONE)

#define MAIN_EVENTGROUP_APRSIS_TRIG_MESSAGE_ACK			(1 << 0)
#define MAIN_EVENTGROUP_APRSIS_TRIG_SEND_MESSAGE		(1 << 1)
#define MAIN_EVENTGROUP_APRSIS_TRIG_GSM_STATUS			(1 << 2)
#define MAIN_EVENTGROUP_APRSIS_TRIG_APRSIS_COUNTERS		(1 << 3)
#define MAIN_EVENTGROUP_APRSIS_TRIG_APRSIS_LOGINSTRING	(1 << 4)
#define MAIN_EVENTGROUP_APRSIS_TRIG_TELEMETRY_VALUES	(1 << 5)
#define MAIN_EVENTGROUP_APRSIS_TRIG_TELEMETRY_DESCR		(1 << 6)
#define MAIN_EVENTGROUP_APRSIS_TRIG_EVENTS				(1 << 7)

#define MAIN_EVENTGROUP_APRSIS_TRIG  	MAIN_EVENTGROUP_APRSIS_TRIG_MESSAGE_ACK 		|	\
										MAIN_EVENTGROUP_APRSIS_TRIG_SEND_MESSAGE 		| 	\
										MAIN_EVENTGROUP_APRSIS_TRIG_GSM_STATUS			|	\
										MAIN_EVENTGROUP_APRSIS_TRIG_APRSIS_COUNTERS 	|	\
										MAIN_EVENTGROUP_APRSIS_TRIG_APRSIS_LOGINSTRING 	| 	\
										MAIN_EVENTGROUP_APRSIS_TRIG_TELEMETRY_VALUES	|	\
										MAIN_EVENTGROUP_APRSIS_TRIG_EVENTS

#define MAIN_EVENTGROUP_RADIO_MESSAGE_RXED		(1 << 0)

#define MAIN_EVENTGROUP_RADIO_MESSAGE_TXED		(1 << 0)

#define MAIN_EVENTGROUP_API_NTP_SEND_EVENT_LOG	(1 << 0)
#define MAIN_EVENTGROUP_API_NTP_SYNC_TIME		(1 << 1)

#define MAIN_EVENTGROUP_API_NTP		MAIN_EVENTGROUP_API_NTP_SEND_EVENT_LOG	|	\
									MAIN_EVENTGROUP_API_NTP_SYNC_TIME

#define MAIN_EVENTGROUP_SX1262_ISBUSY			(1 << 0)
#define MAIN_EVENTGROUP_SX1262_INTERRUPT		(1 << 1)

#define MAIN_EVENTGROUP_FANET_SEND_METEO		(1 << 0)

#define MAIN_EVENTGROUP_ONE_MINUTE		(1 << 10)

// clang-format on
/// ==================================================================================================
///	GLOBAL TYPEDEFS
/// ==================================================================================================

/// ==================================================================================================
///	GLOBAL VARIABLES
/// ==================================================================================================

//! Event group synchronizing powersave task not to run while another tasks are running.
extern EventGroupHandle_t main_eventgroup_handle_powersave;

extern EventGroupHandle_t main_eventgroup_handle_serial_kiss;

//! Event group blocking GSM 800 driver code until rx or tx from/to GSM modem is complete.
extern EventGroupHandle_t main_eventgroup_handle_serial_gsm;

extern EventGroupHandle_t main_eventgroup_handle_serial_sensor;

//! Event group blocking GSM 800 driver code until rx or tx from/to GSM modem is complete.
extern EventGroupHandle_t main_eventgroup_handle_aprs_trigger;

extern EventGroupHandle_t main_eventgroup_handle_radio_message;

extern EventGroupHandle_t main_eventgroup_handle_radio_message_transmit;

extern EventGroupHandle_t main_eventgroup_handle_ntp_and_api_client;

//! Declare a variable to hold the handle of the event group for triggering FANET.
extern EventGroupHandle_t main_eventgroup_handle_fanet;

//! a variable to hold the handle of the event group for sx1262 driver.
extern EventGroupHandle_t main_eventgroup_handle_sx1262;

extern EventGroupHandle_t main_eventgtoup_handle_one_minute;

extern TimerHandle_t main_timer_aprsis_telemetry_descr;

/// ==================================================================================================
///	GLOBAL FUNCTIONS
/// ==================================================================================================
void main_callback_post_tx (void);

#endif /* MAIN_FREERTOS_EXTERNS_H_ */
