SP8EBC/ParaTNC/src/event_log_to_string.c

/*
 * event_log_to_string.c
 *
 *  Created on: Sep 4, 2026
 *      Author: mateusz
 */

#include "event_log_to_string.h"
#include "debug_hardfault.h"
#include "event_log_strings.h"
#include <stdio.h>

const char *event_log_severity_to_str (event_log_severity_t severity)
{

	switch (severity) {
	case EVENT_DEBUG: return event_log_str_severity_debug; /**< EVENT_DEBUG */
	case EVENT_INFO: return event_log_str_severity_info;   /**< EVENT_INFO */
	case EVENT_INFO_CYCLIC: return event_log_str_severity_info_cyclic;
	case EVENT_WARNING: return event_log_str_severity_warning; /**< EVENT_WARNING */
	case EVENT_ERROR: return event_log_str_severity_error;	   /**< EVENT_ERROR */
	case EVENT_ASSERT:
		return event_log_str_severity_assert; /**< EVENT_ASSERT assert failure, which result in hard
												 reset*/
	case EVENT_BOOTUP:
		return event_log_str_severity_bootup; /**< EVENT_BOOTUP all info events generated during
												 bootup */
	case EVENT_TIMESYNC:
		return event_log_str_severity_timesync; /**< EVENT_TIMESYNC event generated once at startup
		   and then every 6 hours to keep master_time and RTC date and time sync */
	case EVENT_MARKER_BAD: return "";
	}

	return 0;
}

/**
 * Returns a pointer to a string representing event source
 * @param src
 * @return
 */
const char *event_log_source_to_str (event_log_source_t src)
{
	switch (src) {
	case EVENT_SRC_MAIN: return event_log_str_src_main; break;
	case EVENT_SRC_WX_HANDLER: return event_log_str_src_wx_handler; break;
	case EVENT_SRC_PWR_SAVE: return event_log_str_src_pwr_save; break;
	case EVENT_SRC_PACKET_TX_HANDLER: return event_log_str_src_packet_tx_handler; break;
	case EVENT_SRC_APRSIS: return event_log_str_src_aprsis; break;
	case EVENT_SRC_KISS: return event_log_str_src_kiss; break;
	case EVENT_SRC_APRS_RF: return event_log_str_src_aprs_rf; break;
	case EVENT_SRC_GSM_GPRS: return event_log_str_src_gsm_gprs; break;
	case EVENT_SRC_TCPIP: return event_log_str_src_tcpip; break;
	case EVENT_SRC_HTTP_CLIENT: return event_log_str_src_http_client; break;
	case EVENT_SRC_MODBUS: return event_log_str_src_modbus; break;
	case EVENT_SRC_UMB: return event_log_str_src_umb; break;
	case EVENT_SRC_DRV_ANEMOMETER: return event_log_str_src_drv_anemometer; break;
	case EVENT_SRC_DRV_I2C: return event_log_str_src_drv_i2c; break;
	case EVENT_SRC_DRV_UART: return event_log_str_src_drv_uart; break;
	case EVENT_SRC_DRV_SPI: return event_log_str_src_drv_spi; break;
	default: return event_log_default;
	}
}

/**
 *
 * @param source
 * @param event_id
 * @return
 */
const char *event_id_to_str (event_log_source_t source, uint8_t event_id)
{
	const char *out = event_log_default;

	switch (source) {
	case EVENT_SRC_MAIN: {

		if (event_id == EVENTS_MAIN_BOOTUP_COMPLETE) {
			out = event_log_str_main_bootup_complete;
		}
		else if (event_id == EVENTS_MAIN_TIMESYNC_BOOTUP) {
			out = event_log_str_main_timesync_bootup;
		}
		else if (event_id == EVENTS_MAIN_TIMESYNC_PERIODIC) {
			out = event_log_str_main_timesync_periodic;
		}
		else if (event_id == EVENTS_MAIN_TIMESYNC_NTP) {
			out = event_log_str_main_timesync_ntp;
		}
		else if (event_id == EVENTS_MAIN_CYCLIC) {
			out = event_log_str_main_info_cyclic;
		}
		else if (event_id == EVENTS_MAIN_POSTMORTEM_HARDFAULT) {
			out = event_log_str_main_info_hardault;
		}
		else if (event_id == EVENTS_MAIN_POSTMORTEM_SUPERVISOR) {
			out = event_log_str_main_info_supervisor;
		}
		else if (event_id == EVENTS_MAIN_CONFIG_FIRST_CRC_FAIL) {
			out = event_log_str_main_error_first_crc_fail;
		}
		else if (event_id == EVENTS_MAIN_CONFIG_SECOND_CRC_FAIL) {
			out = event_log_str_main_error_second_crc_fail;
		}
		else if (event_id == EVENTS_MAIN_CONFIG_FIRST_RESTORE) {
			out = event_log_str_main_warn_first_restore;
		}
		else if (event_id == EVENTS_MAIN_CONFIG_SECOND_RESTORE) {
			out = event_log_str_main_warn_second_restore;
		}
		else if (event_id == EVENTS_MAIN_CALLBACK_PRETX) {
			out = event_log_str_main_callback_pretx;
		}
		else if (event_id == EVENTS_MAIN_CALLBACK_POSTTX) {
			out = event_log_str_main_callback_posttx;
		}
		break;
	}
	case EVENT_SRC_WX_HANDLER: {

		if (event_id == EVENTS_WX_HANDLER_WARN_TEMPERATURE_INT_FAILED) {
			out = event_log_str_wx_handler_temperature_int_failed;
		}
		else if (event_id == EVENTS_WX_HANDLER_WARN_TEMPERATURE_DALLAS_DEGR) {
			out = event_log_str_wx_handler_temperature_dallas_degraded;
		}
		else if (event_id == EVENTS_WX_HANDLER_WARN_TEMPERATURE_DALLAS_NAV) {
			out = event_log_str_wx_handler_temperature_dallas_not_avble;
		}
		else if (event_id == EVENTS_WX_HANDLER_WARN_TEMPERATURE_EXCESIVE_SLEW) {
			out = event_log_str_wx_handler_temperature_excesive_slew;
		}
		else if (event_id == EVENTS_WX_HANDLER_WARN_PRESSURE_FAILED) {
			out = event_log_str_wx_handler_temperature_pressure_fail;
		}
		else if (event_id == EVENTS_WX_HANDLER_WARN_HUMIDITY_FAILED) {
			out = event_log_str_wx_handler_temperature_humidity_fail;
		}
		///////
		///
		else if (event_id == EVENTS_WX_HANDLER_ERROR_RTE_CHECK_ANEM_TIMER_HAS_BEEN_FIRED) {
			out = event_log_str_wx_handler_error_rte_check_anem_timer_has_been_fired;
		}
		else if (event_id == EVENTS_WX_HANDLER_ERROR_RTE_CHECK_SLEW_LIMIT) {
			out = event_log_str_wx_handler_error_rte_check_slew_limit;
		}
		else if (event_id == EVENTS_WX_HANDLER_ERROR_RTE_CHECK_DEBOUCING) {
			out = event_log_str_wx_handler_error_rte_check_debouncing;
		}
		else if (event_id == EVENTS_WX_HANDLER_ERROR_RTE_CHECK_UF_CONVERTER_FAIL) {
			out = event_log_str_wx_handler_error_rte_check_uf_converter_fail;
		}
		else if (event_id == EVENTS_WX_HANDLER_ERROR_RTE_CHECK_WINDSPEED_BUFFERS) {
			out = event_log_str_wx_handler_error_rte_check_windspeed_buffers;
		}

		break;
	}
	case EVENT_SRC_PWR_SAVE:
		if (event_id == EVENTS_PWR_SAVE_BATT_LOW_GOING_SLEEP) {
			out = event_log_str_pwr_save_going_sleep;
		}
		else if (event_id == EVENTS_PWR_SAVE_GO_TO_INTERMEDIATE_SLEEP) {
			out = event_log_str_pwr_save_goto_intermediate_sleep;
		}
		else if (event_id == EVENTS_PWR_SAVE_WOKEN_UP_RTC_INTERRUPT) {
			out = event_log_str_pwr_save_wokenup_rtc_it;
		}
		else if (event_id == EVENTS_PWR_SAVE_WOKEN_UP_AFTER_LAST_SLEEP) {
			out = event_log_str_pwr_save_wokenup_after_last;
		}
		else if (event_id == EVENTS_PWR_SAVE_WOKEN_UP_EXITED) {
			out = event_log_str_pwr_save_wokenup_exited;
		}
		else if (event_id == EVENTS_PWR_SAVE_SWITCHING_MODE) {
			out = event_log_str_pwr_save_switching_mode;
		}
		// event_log_str_pwr_save_switching_mode
		else if (event_id == EVENTS_PWR_SAVE_STATE_C0) {
			out = event_log_str_pwr_save_state_c0;
		}
		else if (event_id == EVENTS_PWR_SAVE_STATE_C1) {
			out = event_log_str_pwr_save_state_c1;
		}
		else if (event_id == EVENTS_PWR_SAVE_STATE_C2) {
			out = event_log_str_pwr_save_state_c2;
		}
		else if (event_id == EVENTS_PWR_SAVE_STATE_C3) {
			out = event_log_str_pwr_save_state_c3;
		}
		else if (event_id == EVENTS_PWR_SAVE_STATE_M4) {
			out = event_log_str_pwr_save_state_m4;
		}
		else if (event_id == EVENTS_PWR_SAVE_STATE_M4A) {
			out = event_log_str_pwr_save_state_m4a;
		}
		else if (event_id == EVENTS_PWR_SAVE_STATE_I5) {
			out = event_log_str_pwr_save_state_i5;
		}
		else if (event_id == EVENTS_PWR_SAVE_STATE_L6) {
			out = event_log_str_pwr_save_state_l6;
		}
		else if (event_id == EVENTS_PWR_SAVE_STATE_L7) {
			out = event_log_str_pwr_save_state_l7;
		}
		break;
	case EVENT_SRC_PACKET_TX_HANDLER:
		if (event_id == EVENTS_TX_HANDLER_INFO_SENDING_WXFRAME) {
			out = event_log_str_packet_tx_handler_info_sending_wx_frame;
		}
		else if (event_id == EVENTS_TX_HANDLER_INFO_SET_CURRENT_COUNTERS) {
			out = event_log_str_packet_tx_handler_info_set_counters;
		}
		else if (event_id == EVENTS_TX_HANDLER_INFO_SENDING_WXFRAME_APRSIS) {
			out = event_log_str_packet_tx_handler_info_sending_wx_frame_via_gsm;
		}
		break;
	case EVENT_SRC_APRSIS: {
		if (event_id == EVENTS_APRSIS_ERROR_IM_NOT_OK_LAST_KEEPALIVE) {
			out = event_log_str_aprsis_im_not_ok_last_keepalive;
		}
		else if (event_id == EVENTS_APRSIS_ERROR_IM_NOT_OK_LAST_TRANSMIT_LONG) {
			out = event_log_str_aprsis_im_not_ok_last_transmit;
		}
		else if (event_id == EVENTS_APRSIS_WARN_AUTH_FAILED) {
			out = event_log_str_aprsis_warn_auth_failed;
		}
		else if (event_id == EVENTS_APRSIS_WARN_TIMEOUT_WAITING_AUTH) {
			out = event_log_str_aprsis_warn_timeout_waiting_auth;
		}
		else if (event_id == EVENTS_APRSIS_WARN_NO_HELLO_MESSAGE) {
			out = event_log_str_aprsis_warn_no_hello_message;
		}
		else if (event_id == EVENTS_APRSIS_WARN_TIMEOUT_WAITING_HELLO_MSG) {
			out = event_log_str_aprsis_warn_timeout_waiting_hello_msg;
		}
		else if (event_id == EVENTS_APRSIS_WARN_CONNECT_FAILED) {
			out = event_log_str_aprsis_warn_connect_failed;
		}
		else if (event_id == EVENTS_APRSIS_WARN_WRONG_STATE) {
			out = event_log_str_aprsis_warn_wrong_state;
		}
		else if (event_id == EVENTS_APRSIS_WARN_DEAD_KEEPALIVE) {
			out = event_log_str_aprsis_warn_dead_keepalive;
		}
		else if (event_id == EVENTS_APRSIS_WARN_DEAD_TRANSMIT) {
			out = event_log_str_aprsis_warn_dead_transmit;
		}
		else if (event_id == EVENTS_APRSIS_INFO_CONNECTING_APRSIS) {
			out = event_log_str_aprsis_connecting;
		}
		break;
	}
	case EVENT_SRC_KISS:
		if (event_id == EVENTS_DEFINITIONS_KISS_WARN_ERASING_STARTUP) {
			out = event_log_str_kiss_warn_erasing_startup;
		}
		else if (event_id == EVENTS_DEFINITIONS_KISS_WARN_FLASHING_STARTUP) {
			out = event_log_str_kiss_warn_programming_startup;
		}

		break;
	case EVENT_SRC_APRS_RF: break;
	case EVENT_SRC_GSM_GPRS:
		if (event_id == EVENTS_GSM_GPRS_ERR_APN_CONFIGURATION_MISSING) {
			out = event_log_str_tcpip_error_apn_config_missing;
		}
		else if (event_id == EVENTS_GSM_GPRS_WARN_ASYNC_MSG_DETECTED) {
			out = event_log_str_tcpip_warn_async_msg_detected;
		}
		else if (event_id == EVENTS_GSM_GPRS_ERR_SIM_CARD_STATUS) {
			out = event_log_str_tcpip_error_sim_card_status;
		}
		else if (event_id == EVENTS_GSM_GPRS_WARN_NOT_REGISTERED_TO_NETWORK) {
			out = event_log_str_tcpip_warn_not_registered_to_nework;
		}
		else if (event_id == EVENTS_GSM_GPRS_WARN_SERIAL_RX_ERROR) {
			out = event_log_str_tcpip_warn_serial_rx_error;
		}
		else if (event_id == EVENTS_GSM_GPRS_REGISTERED_NETWORK) {
			out = event_log_str_tcpip_bootup_registered_network;
		}
		else if (event_id == EVENTS_GSM_GPRS_SIGNAL_LEVEL) {
			out = event_log_str_tcpip_bootup_signal_level;
		}
		else if (event_id == EVENTS_GSM_GPRS_IMSI) {
			out = event_log_str_tcpip_bootup_imsi;
		}
		else if (event_id == EVENTS_GSM_GPRS_IP_ADDRESS) {
			out = event_log_str_tcpip_bootup_ip_address;
		}
		else if (event_id == EVENTS_GSM_GPRS_HANDSHAKING) {
			out = event_log_str_tcpip_handshaking;
		}
		else if (event_id == EVENTS_GSM_GPRS_POWERED_ON) {
			out = event_log_str_tcpip_powered_on;
		}
		else if (event_id == EVENTS_GSM_GPRS_WARN_RESET_SERIAL) {
			out = event_log_str_tcpip_reset_serial;
		}
		else if (event_id == EVENTS_GSM_GPRS_INITIALIZING_GET_PIN_STATUS) {
			out = event_log_str_tcpip_get_pin_status;
		}
		else if (event_id == EVENTS_GSM_GPRS_INITIALIZING_GET_PIN_STATUS_DONE) {
			out = event_log_str_tcpip_initializing_get_pin_status_done;
		}
		else if (event_id == EVENTS_GSM_GPRS_WARN_GET_NETWORK_REGISTRATION) {
			out = event_log_str_tcpip_warn_get_network_registration;
		}
		else if (event_id == EVENTS_GSM_GPRS_INITIALIZING_GET_NETWORK_REGISTR) {
			out = event_log_str_tcpip_get_network_registration;
		}
		else if (event_id == EVENTS_GSM_GPRS_INITIALIZING_GET_NETWORK_REGISTR_DONE) {
			out = event_log_str_tcpip_initializing_get_network_reg_done;
		}
		else if (event_id == EVENTS_GSM_GPRS_INITIALIZING_GET_IMSI) {
			out = event_log_str_tcpip_get_imsi;
		}
		break;
	case EVENT_SRC_TCPIP:
		if (event_id == EVENTS_TCPIP_ERR_CONNECTING) {
			out = event_log_str_tcpip_error_connecting;
		}
		else if (event_id == EVENTS_TCPIP_ERR_CONNECTING_NO_MODEM_RESPONSE) {
			out = event_log_str_tcpip_error_connecting_no_modem_resp;
		}

		break;
	case EVENT_SRC_HTTP_CLIENT: break;
	case EVENT_SRC_MODBUS: break;
	case EVENT_SRC_UMB: {
		if (event_id == EVENTS_UMB_WARN_CRC_FAILED_IN_RECEIVED_FRAME) {
			out = event_log_str_umb_warn_crc_failed_in_received_frame;
		}
		else if (event_id == EVENTS_UMB_WARN_RECEIVED_FRAME_MALFORMED) {
			out = event_log_str_umb_warn_received_frame_malformed;
		}
		else if (event_id == EVENTS_UMB_WARN_NOK_STATUS_IN_GET_STATUS_RESP) {
			out = event_log_str_umb_warn_nok_sensor_status_in_get_status_data;
		}
		else if (event_id == EVENTS_UMB_WARN_NOK_STATUS_IN_OFFLINE_DATA_RESP) {
			out = event_log_str_umb_warn_nok_sensor_status_in_offline_data;
		}
		else if (event_id == EVENTS_UMB_ERROR_RECEIVING) {
			out = event_log_str_umb_error_receiving;
		}
		else if (event_id == EVENTS_UMB_ERROR_UNEXPECTED_ROUTINE_ID) {
			out = event_log_str_umb_error_unexp_routine_id;
		}
		else if (event_id == EVENTS_UMB_ERROR_QF_NOT_AVAILABLE) {
			out = event_log_str_umb_error_quality_factor_not_avail;
		}

		break;
	}
	case EVENT_SRC_DRV_ANEMOMETER: {

		if (event_id == EVENTS_DRV_ANEMOMETER_WARN_NO_PULSES_INT_FIRED) {
			out = event_log_str_drv_anemometer_no_pulses_int_fired;
		}
		else if (event_id == EVENTS_DRV_ANEMOMETER_WARN_EXCESIVE_SLEW) {
			out = event_log_str_drv_anemometer_excesive_slew_rate;
		}
		else if (event_id == EVENTS_DRV_ANEMOMETER_ERROR_UF_CONV_NOT_WORKING) {
			out = event_log_str_drv_anemometer_uf_conv_not_working;
		}
		else if (event_id == EVENTS_DRV_ANEMOMETER_ERROR_UF_FREQ_TOO_HI) {
			out = event_log_str_drv_anemometer_uf_freq_to_hi;
		}
		else if (event_id == EVENTS_DRV_ANEMOMETER_WARN_QF_NOT_FULL) {
			out = event_log_str_drv_anemometer_qf_not_full;
		}

		break;
	}
	case EVENT_SRC_DRV_I2C: break;
	case EVENT_SRC_DRV_UART: break;
	case EVENT_SRC_DRV_SPI: break;
	case EVENT_SRC_FANET:
		if (event_id == EVENTS_FANET_FAIL_TO_SEND_METEO) {
			out = event_log_str_fanet_fail_to_send_weather;
		}
		break;
	default: out = event_log_default;
	}

	return out;
}

/**
 * Generates string representation of given event log in exposed form
 * @param exposed pointer to an event to be converted
 * @param output char buffer to place a string into
 * @param output_ln maximum length of output string
 * @return length of assembled string
 */
uint16_t event_exposed_to_string (const event_log_exposed_t *exposed, char *output,
								  uint16_t output_ln)
{
	uint16_t out = 0;

	char severity = ' ';

	switch (exposed->severity) {
	case EVENT_DEBUG: severity = 'D'; break;
	case EVENT_INFO: severity = 'I'; break;
	case EVENT_INFO_CYCLIC: severity = 'C'; break;
	case EVENT_WARNING: severity = 'W'; break;
	case EVENT_ERROR: severity = 'E'; break;
	case EVENT_ASSERT: severity = 'A'; break;
	case EVENT_BOOTUP: severity = 'B'; break;
	case EVENT_TIMESYNC: severity = 'T'; break;
	case EVENT_MARKER_BAD: severity = ' '; break;
	}

	if (exposed->severity == EVENT_TIMESYNC) {
		out = snprintf (output,
						output_ln,
						"[%c][CNT:%lu][MT:%lu][RTC_TIMESYNC][DATE:%d/%d/%d][TIME:%d:%d:%d]",
						severity,
						exposed->event_counter_id,
						exposed->event_master_time,
						(uint16_t)exposed->param2,
						(uint16_t)exposed->param,
						(uint16_t)exposed->wparam,
						(uint16_t)exposed->wparam2,
						(uint16_t)exposed->lparam,
						(uint16_t)exposed->lparam2);
	}
	else if (exposed->severity == EVENT_ERROR &&
			 exposed->event_id == EVENTS_MAIN_POSTMORTEM_HARDFAULT) {
		// special format for hardfault postmortem logs

		char *first = (char *)event_log_default;
		char *second = (char *)event_log_default;

		// param value defines which stackframe registers are stored as lparams
		switch (exposed->param) {
		case 1:
			first = (char *)event_log_str_hardfault_lr;
			second = (char *)event_log_str_hardfault_pc;
			break;
		case 2:
			first = (char *)event_log_str_hardfault_r0;
			second = (char *)event_log_str_hardfault_r1;
			break;
		case 3:
			first = (char *)event_log_str_hardfault_r2;
			second = (char *)event_log_str_hardfault_r3;
			break;
		case 4:
			first = (char *)event_log_str_hardfault_r12;
			second = (char *)event_log_str_hardfault_cfsr;
			break;
		case 5:
			first = (char *)event_log_str_hardfault_src;
			second = (char *)event_log_str_hardfault_xpsr;
			break;
		default:
			first = (char *)event_log_default;
			second = (char *)event_log_default;
			break;
		}

		// value of 5 contain hard fault source, which might be decoded from numeric value to
		// dedicated string
		if (exposed->param == 5) {
			char *source = (char *)event_log_default;

			switch (exposed->lparam) {
			case DEBUG_HARDFAULT_SOURCE_HFLT: source = (char *)event_log_str_hardfault_hf; break;
			case DEBUG_HARDFAULT_SOURCE_USAGEFLT:
				source = (char *)event_log_str_hardfault_usage;
				break;
			case DEBUG_HARDFAULT_SOURCE_BUSFLT: source = (char *)event_log_str_hardfault_bus; break;
			case DEBUG_HARDFAULT_SOURCE_MMUFLT: source = (char *)event_log_str_hardfault_mmu; break;
			}
			// special case if the fault source can be printed
			out = snprintf (output,
							output_ln,
							"[ERR-HF][CNT:%lu][%s: %s][%s: 0x%lX]",
							(unsigned long)exposed->event_counter_id,
							first,
							source,
							second,
							exposed->lparam2);
		}
		else {
			// everything else which has only registers values
			out = snprintf (output,
							output_ln,
							"[ERR-HF][CNT:%lu][%s: 0x%lX][%s: 0x%lX]",
							(unsigned long)exposed->event_counter_id,
							first,
							exposed->lparam,
							second,
							exposed->lparam2);
		}
	}
	else if (exposed->severity == EVENT_ERROR &&
			 exposed->event_id == EVENTS_MAIN_POSTMORTEM_SUPERVISOR) {
		// special case for a log with a master time value on which
		// supervisor failure has been detected
		if (exposed->param == 0) {
			out = snprintf (output,
							output_ln,
							"[ERR-SUP][CNT:%lu][0][MT-FLT: %lu][%d: %lu]",
							(unsigned long)exposed->event_counter_id,
							exposed->lparam,
							exposed->param + 1,
							exposed->lparam2);
		}
		else {
			if (exposed->lparam != 0 && exposed->lparam2 != 0) {
				// everything else which has only registers values
				out = snprintf (output,
								output_ln,
								"[ERR-SUP][CNT:%lu][0][%d: %lu][%d: %lu]",
								(unsigned long)exposed->event_counter_id,
								exposed->param,
								exposed->lparam,
								exposed->param + 1,
								exposed->lparam2);
			}
		}
	}
	else {
		// if pointer to event string is set
		if (variant_validate_is_within_flash ((const void *)exposed->event_str_name) == 1) {
			out = snprintf (output,
							output_ln,
							"[%c][CNT:%lu][MT:%lu][%s][%s][P: %X %X %X %X %lX %lX]",
							severity,
							(unsigned long)exposed->event_counter_id,
							exposed->event_master_time,
							exposed->source_str_name,
							exposed->event_str_name,
							exposed->param,
							exposed->param2,
							exposed->wparam,
							exposed->wparam2,
							exposed->lparam,
							exposed->lparam2);
		}
		else {
			out = snprintf (output,
							output_ln,
							"[%c][CNT:%lu][MT:%lu][%s][EV:%d][P: %X %X %X %X %lX %lX]",
							severity,
							(unsigned long)exposed->event_counter_id,
							exposed->event_master_time,
							exposed->source_str_name,
							exposed->event_id,
							exposed->param,
							exposed->param2,
							exposed->wparam,
							exposed->wparam2,
							exposed->lparam,
							exposed->lparam2);
		}
	}

	return out;
}
