SP8EBC/ParaTNC/system/src/drivers/l4/serial_stm32l4x.c

#include "drivers/serial.h"

#include "station_config.h"
#include "station_config_target_hw.h"

#include "kiss_communication/kiss_communication_defs.h"

#include "main.h" // global_time is here

#include <string.h>

#include <stm32l4xx.h>
#include <stm32l4xx_ll_dma.h>
#include <stm32l4xx_ll_gpio.h>
#include <stm32l4xx_ll_usart.h>

#ifdef SEPARATE_TX_BUFF
uint8_t srl_usart1_tx_buffer[TX_BUFFER_1_LN] = {'\0'};
#endif

#ifdef SEPARATE_RX_BUFF
uint8_t srl_usart1_rx_buffer[RX_BUFFER_1_LN] = {'\0'};
#endif

#ifdef SEPARATE_TX_BUFF
uint8_t srl_usart2_tx_buffer[TX_BUFFER_2_LN] = {'\0'};
#endif

#ifdef SEPARATE_RX_BUFF
uint8_t srl_usart2_rx_buffer[RX_BUFFER_2_LN] = {'\0'};
#endif

uint8_t srl_usart3_tx_buffer[TX_BUFFER_3_LN] = {'\0'};
uint8_t srl_usart3_rx_buffer[RX_BUFFER_3_LN] = {'\0'};

void srl_init (srl_context_t *ctx, USART_TypeDef *port, uint8_t *rx_buffer, uint16_t rx_buffer_size,
			   uint8_t *tx_buffer, uint16_t tx_buffer_size, uint32_t baudrate, uint8_t stop_bits)
{

	if (ctx->srl_rx_state == SRL_RX_IDLE)
		return;

// point to internal buffers by default
#ifdef SEPARATE_TX_BUFF
	ctx->srl_tx_buf_pointer = tx_buffer;
	ctx->srl_rx_buf_ln = tx_buffer_size;
#endif

#ifdef SEPARATE_RX_BUFF
	ctx->srl_rx_buf_pointer = rx_buffer;
	ctx->srl_tx_buf_ln = rx_buffer_size;
#endif

	ctx->srl_tx_internal_buf_pointer = tx_buffer;
	ctx->srl_tx_internal_buf_ln = tx_buffer_size;

	memset (ctx->srl_rx_buf_pointer, 0x00, ctx->srl_rx_buf_ln);
	memset (ctx->srl_tx_buf_pointer, 0x00, ctx->srl_tx_buf_ln);

	ctx->port = port;
	ctx->port_baurate = baudrate;
	ctx->port_stopbits = stop_bits;

	// ctx->te_port = 0;
	// ctx->te_pin = 0;

	ctx->srl_tx_start_time = 0xFFFFFFFFu;

	LL_USART_InitTypeDef USART_InitStructure;

	USART_InitStructure.BaudRate = baudrate;
	USART_InitStructure.DataWidth = LL_USART_DATAWIDTH_8B;
	USART_InitStructure.StopBits = LL_USART_STOPBITS_1;
	USART_InitStructure.Parity = LL_USART_PARITY_NONE;
	USART_InitStructure.TransferDirection = LL_USART_DIRECTION_RX;
	USART_InitStructure.HardwareFlowControl = LL_USART_HWCONTROL_NONE;
	USART_InitStructure.OverSampling = LL_USART_OVERSAMPLING_16;

	const ErrorStatus init_res = LL_USART_Init (port, &USART_InitStructure);

	if (init_res != SUCCESS) {
		ctx->srl_rx_state = SRL_RX_ERROR;
		return;
	}

	if (port == USART1) {
		NVIC_EnableIRQ (USART1_IRQn);
	}
	else if (port == USART2) {
		NVIC_EnableIRQ (USART2_IRQn);
	}
	else if (port == USART3) {
		NVIC_EnableIRQ (USART3_IRQn);
	}

	port->CR1 |= USART_CR1_UE;
	port->ISR &= (0xFFFFFFFF ^ USART_ISR_TC);

	ctx->srl_rx_state = SRL_RX_IDLE;
	ctx->srl_tx_state = SRL_TX_IDLE;
	ctx->srl_tx_with_dma = 0;

	ctx->srl_rx_error_reason = SRL_ERR_NONE;

	ctx->srl_rx_timeout_calc_started = 0;
	ctx->total_idle_counter = 0;
	ctx->total_overrun_counter = 0;

	ctx->srl_rx_start_time = 0;
	ctx->srl_rx_waiting_start_time = 0;

	ctx->srl_rx_timeout_enable = 0;
	ctx->srl_rx_timeout_waiting_enable = 0;

	ctx->srl_rx_kiss_mode = 0;
	ctx->srl_rx_kiss_escaping_now = 0;

	// ctx->srl_rx_done_or_error = 0;
	ctx->srl_rx_term = 0;
}

static void srl_init_dma_helper (uint8_t *tx_buffer,
								 uint32_t tx_buffer_size, USART_TypeDef *port)
{
	LL_DMA_InitTypeDef DMA_InitStruct;
	LL_DMA_StructInit(&DMA_InitStruct);

	DMA_InitStruct.Direction = LL_DMA_DIRECTION_MEMORY_TO_PERIPH;
	DMA_InitStruct.Mode = LL_DMA_MODE_NORMAL;
	DMA_InitStruct.NbData = tx_buffer_size;
	DMA_InitStruct.MemoryOrM2MDstAddress = (uint32_t)tx_buffer;
	DMA_InitStruct.MemoryOrM2MDstDataSize = LL_DMA_MDATAALIGN_BYTE;
	DMA_InitStruct.MemoryOrM2MDstIncMode = LL_DMA_MEMORY_INCREMENT;
	// DMA_InitStruct.PeriphOrM2MSrcAddress = (uint32_t)tx_buffer;
	DMA_InitStruct.PeriphOrM2MSrcDataSize = LL_DMA_PDATAALIGN_BYTE;
	DMA_InitStruct.PeriphOrM2MSrcIncMode = LL_DMA_PERIPH_NOINCREMENT;

	if (port == USART1) {
		DMA_InitStruct.PeriphOrM2MSrcAddress = (uint32_t)&USART1->TDR;
		DMA_InitStruct.PeriphRequest = LL_DMA_REQUEST_2;
		LL_DMA_DeInit (DMA1, LL_DMA_CHANNEL_4);
		LL_DMA_Init (DMA1, LL_DMA_CHANNEL_4, &DMA_InitStruct);
		LL_DMA_EnableIT_TC (DMA1, LL_DMA_CHANNEL_4);
		LL_DMA_EnableChannel (DMA1, LL_DMA_CHANNEL_4);
		LL_USART_EnableDMAReq_TX (USART1);
		NVIC_EnableIRQ (DMA1_Channel4_IRQn);
	}
	else if (port == USART2) {
		DMA_InitStruct.PeriphOrM2MSrcAddress = (uint32_t)&USART2->TDR;
		DMA_InitStruct.PeriphRequest = LL_DMA_REQUEST_2;
		LL_DMA_DeInit (DMA1, LL_DMA_CHANNEL_7);
		LL_DMA_Init (DMA1, LL_DMA_CHANNEL_7, &DMA_InitStruct);
		LL_DMA_EnableIT_TC (DMA1, LL_DMA_CHANNEL_7);
		LL_DMA_EnableChannel (DMA1, LL_DMA_CHANNEL_7);
		NVIC_EnableIRQ (DMA1_Channel7_IRQn);
	}
	else if (port == USART3) {
		DMA_InitStruct.PeriphOrM2MSrcAddress = (uint32_t)&USART3->TDR;
		DMA_InitStruct.PeriphRequest = LL_DMA_REQUEST_2;
		LL_DMA_DeInit (DMA1, LL_DMA_CHANNEL_2);
		LL_DMA_Init (DMA1, LL_DMA_CHANNEL_2, &DMA_InitStruct);
		LL_DMA_EnableIT_TC (DMA1, LL_DMA_CHANNEL_2);
		LL_DMA_EnableChannel (DMA1, LL_DMA_CHANNEL_2);
		NVIC_EnableIRQ (DMA1_Channel2_IRQn);
	}
}

void srl_init_dma (srl_context_t *ctx, USART_TypeDef *port, uint8_t *rx_buffer,
				   uint16_t rx_buffer_size, uint8_t *tx_buffer, uint16_t tx_buffer_size,
				   uint32_t baudrate, uint8_t stop_bits)
{

	// firstly do regular initialization
	srl_init (ctx, port, rx_buffer, rx_buffer_size, tx_buffer, tx_buffer_size, baudrate, stop_bits);

	srl_init_dma_helper (tx_buffer, tx_buffer_size, port);

	ctx->srl_tx_with_dma = 1;

	port->ISR &= (0xFFFFFFFF ^ USART_ISR_TC);
	port->ISR &= (0xFFFFFFFF ^ USART_ISR_TXE);
}

void srl_reset (srl_context_t *ctx)
{
	ctx->srl_rx_state = SRL_RX_IDLE;
	ctx->srl_tx_state = SRL_TX_IDLE;

	ctx->srl_rx_error_reason = SRL_ERR_NONE;

	ctx->srl_rx_timeout_calc_started = 0;
	ctx->total_idle_counter = 0;
	ctx->total_overrun_counter = 0;

	ctx->srl_rx_start_time = 0;
	ctx->srl_rx_waiting_start_time = 0;

	// ctx->srl_rx_timeout_enable = 0;
	ctx->srl_rx_timeout_waiting_enable = 0;
	ctx->srl_rx_kiss_mode = 0;
	ctx->srl_rx_kiss_escaping_now = 0;
}

void srl_close (srl_context_t *ctx)
{
	LL_USART_DeInit (ctx->port);

	if (ctx->te_port != NULL && ctx->te_pin != 0) {
		LL_GPIO_ResetOutputPin (ctx->te_port, ctx->te_pin);
	}

	ctx->srl_rx_state = SRL_RX_NOT_CONFIG;
	ctx->srl_tx_state = SRL_TX_NOT_CONFIG;
}

// this function shall be called in 10ms periods by some timer to check the timeout
// during receive. This method works differently depends on what receive mode was initiaded
//
// if start & stop characters are in use the timeout will be calculted from the time when
// start character was received and operation mode has been switched from SRL_WAITING_TO_RX
// to SRL_RXING
//
// if no start & stop character is used by software timeout is calculated from the time when
// first character was received after calling srl_receive_data
void srl_keep_timeout (srl_context_t *ctx)
{
	if (ctx->srl_rx_state != SRL_RX_NOT_CONFIG && ctx->srl_rx_timeout_enable == 1) {

		// checking if flag to check a timeout is raised
		if (ctx->srl_rx_timeout_calc_started == 1) {

			// check if timeout expired
			if (master_time - ctx->srl_rx_start_time > ctx->srl_rx_timeout_trigger_value_in_msec) {
				// disable the receiving part of UART, disable interrupt and switch to an error
				// state
				ctx->port->CR1 &= (0xFFFFFFFF ^ USART_CR1_RE);
				ctx->port->CR1 &= (0xFFFFFFFF ^ USART_CR1_RXNEIE);

				ctx->srl_rx_state = SRL_RX_ERROR;

				ctx->srl_rx_error_reason = SRL_ERR_TIMEOUT_RECEIVING;

				if (ctx->srl_rx_done_or_error != 0) {
					ctx->srl_rx_done_or_error (ctx);
				}
			}
		}
	}
	else {
		;
	}

	if ((ctx->srl_rx_state == SRL_WAITING_TO_RX || ctx->srl_rx_state == SRL_RXING) &&
		ctx->srl_rx_timeout_waiting_enable == 1) {
		if (master_time - ctx->srl_rx_waiting_start_time >
			ctx->srl_rx_timeout_trigger_value_in_msec) {
			ctx->port->CR1 &= (0xFFFFFFFF ^ USART_CR1_RE);
			ctx->port->CR1 &= (0xFFFFFFFF ^ USART_CR1_RXNEIE);

			ctx->srl_rx_state = SRL_RX_ERROR;

			ctx->srl_rx_error_reason = SRL_ERR_TIMEOUT_WAITING;

			if (ctx->srl_rx_done_or_error != 0) {
				ctx->srl_rx_done_or_error (ctx);
			}
		}
	}
}

uint8_t srl_send_data (srl_context_t *ctx, const uint8_t *data, uint8_t mode, uint16_t leng,
					   uint8_t internal_external)
{
	if (ctx->srl_tx_state == SRL_TXING)
		return SRL_BUSY;

	/* Wesja z dnia 04.09.2013

		char* data - wskaznik na tablice z danymi do przeslania
		char mode - tryb pracy ktory okresla czy ma wysylac okreslona liczbe znakow
					czy wysylac wszystko do napotkania 0x00
		short leng - ilosc znakow do wyslania istotna tylko gdy mode = 1
		internal_external - ustawienie 0 spowoduje skopiowanie do wewnentrznego bufora i wysylanie z
	   niego jedynka spowoduje wysylanie bezposrednio z wewnetrznego
		 */
	int i;

	// the bytes counter needs to be set to 1 as the first byte is sent in this function
	ctx->srl_tx_bytes_counter = 1;

	// if an user want to send data using internal buffer
	if (internal_external == 0) {

		// if data at the input is too long to fit in the buffer
		if (leng >= ctx->srl_rx_buf_ln)
			return SRL_DATA_TOO_LONG;

		// setting a pointer to transmit buffer to the internal buffer inside the driver
		ctx->srl_tx_buf_pointer = ctx->srl_tx_internal_buf_pointer;

		ctx->srl_tx_buf_ln = ctx->srl_tx_internal_buf_ln;

		// cleaning the buffer from previous content
		memset (ctx->srl_tx_buf_pointer, 0x00, ctx->srl_tx_buf_ln);

		// copying the data from provided pointer to internal buffer
		if (mode == 0) {
			// copying everything till the 0x00 is spoted or till the buffer border is reached
			for (i = 0; (i < TX_BUFFER_1_LN && *(data + i) != '\0'); i++)
				ctx->srl_tx_buf_pointer[i] = data[i];
			ctx->srl_tx_bytes_req = i;
		}
		else if (mode == 1) {
			// we don't need to check against buffer size because this was confirmed already
			for (i = 0; i <= leng; i++)
				ctx->srl_tx_buf_pointer[i] = data[i];
			ctx->srl_tx_bytes_req = leng;
		}
	}
	else if (internal_external == 1) {
		ctx->srl_tx_buf_pointer = data;
		ctx->srl_tx_bytes_req = leng;
		ctx->srl_tx_buf_ln = leng;
	}
	else
		return SRL_WRONG_BUFFER_PARAM;

	if (ctx->te_port != 0 && ctx->early_tx_assert != 0) { // added in commit 8d0dd57
		LL_GPIO_SetOutputPin (ctx->te_port, ctx->te_pin);
	}
	if (ctx->srl_tx_with_dma == 1) {

		ctx->port->ISR &= (0xFFFFFFFF ^ USART_ISR_TC);
		ctx->port->ISR &= (0xFFFFFFFF ^ USART_ISR_TXE);

		srl_init_dma_helper (ctx->srl_tx_buf_pointer,
							 ctx->srl_tx_bytes_req,
							 ctx->port);

		// enabling transmitter
		ctx->port->CR1 |= USART_CR1_TE;
		ctx->port->ISR &= (0xFFFFFFFF ^ USART_ISR_TC);
		ctx->port->TDR = ctx->srl_tx_buf_pointer[0];
		ctx->srl_tx_state = SRL_TXING;
		ctx->port->CR1 &= (0xFFFFFFFF ^ USART_CR1_TXEIE);
		ctx->port->CR1 |= USART_CR1_TCIE;

		return SRL_OK;
	}

	// enabling transmitter
	ctx->port->CR1 |= USART_CR1_TE;
	ctx->port->ISR &= (0xFFFFFFFF ^ USART_ISR_TC);
	ctx->port->TDR = ctx->srl_tx_buf_pointer[0];
	ctx->srl_tx_state = SRL_TXING;
	ctx->port->CR1 |= USART_CR1_TXEIE;
	ctx->port->CR1 |= USART_CR1_TCIE;


	return SRL_OK;
}

/**
 * This function assumes than
 */
uint8_t srl_start_tx (srl_context_t *ctx, short leng)
{
	if (ctx->srl_tx_state == SRL_TXING)
		return SRL_BUSY;

	// if data at the input is too long to fit in the buffer
	if (leng >= ctx->srl_rx_buf_ln)
		return SRL_DATA_TOO_LONG;

	if (leng == 0)
		return SRL_WRONG_PARAMS_COMBINATION;

	ctx->srl_tx_bytes_req = leng;

	// setting a pointer to transmit buffer to the internal buffer inside the driver
	// ctx->srl_tx_buf_pointer = srl_usart1_tx_buffer;

	if (ctx->te_port != 0 && ctx->early_tx_assert != 0) { // // added in commit 8d0dd57
		LL_GPIO_SetOutputPin (ctx->te_port, ctx->te_pin);
	}

	// check if delay should be applied to transmission
	if (ctx->srl_tx_start_time == 0xFFFFFFFFu) {
		if (ctx->srl_tx_with_dma == 1) {

			ctx->port->ISR &= (0xFFFFFFFF ^ USART_ISR_TC);
			ctx->port->ISR &= (0xFFFFFFFF ^ USART_ISR_TXE);

			srl_init_dma_helper (ctx->srl_tx_buf_pointer,
								 ctx->srl_tx_bytes_req,
								 ctx->port);

			// enabling transmitter
			ctx->port->CR1 |= USART_CR1_TE;
			ctx->port->ISR &= (0xFFFFFFFF ^ USART_ISR_TC);
			ctx->port->TDR = ctx->srl_tx_buf_pointer[0];
			ctx->srl_tx_state = SRL_TXING;
			ctx->port->CR1 &= (0xFFFFFFFF ^ USART_CR1_TXEIE);
			ctx->port->CR1 |= USART_CR1_TCIE;
		}
		else {

			// 0xFFFFFFFF is a magic number which disables the pre-tx delay
			ctx->port->CR1 |= USART_CR1_TE;
			ctx->port->ISR &= (0xFFFFFFFF ^ USART_ISR_TC);
			ctx->port->TDR = ctx->srl_tx_buf_pointer[0];

			// the bytes counter needs to be set to 1 as the first byte is sent in this function
			ctx->srl_tx_bytes_counter = 1;

			ctx->srl_tx_state = SRL_TXING;

			ctx->port->CR1 |= USART_CR1_TXEIE;
			ctx->port->CR1 |= USART_CR1_TCIE;
		}
	}
	else {
		ctx->srl_tx_state = SRL_TX_WAITING;
		ctx->srl_tx_start_time = main_get_master_time ();
	}

	return SRL_OK;
}

void srl_wait_for_tx_completion (srl_context_t *ctx)
{
	while (ctx->srl_tx_state != SRL_TX_IDLE && ctx->srl_tx_state != SRL_TX_ERROR)
		;
}

uint8_t srl_wait_for_rx_completion_or_timeout (srl_context_t *ctx, uint8_t *output)
{

	*output = SRL_UNINITIALIZED;

	// block the execution until the
	while (ctx->srl_rx_state != SRL_RX_DONE && ctx->srl_rx_state != SRL_RX_ERROR)
		;

	switch (ctx->srl_rx_state) {
	case SRL_RX_DONE: {
		*output = SRL_OK;
		break;
	}

	case SRL_RX_ERROR: {
		*output = SRL_TIMEOUT;
		break;
	}

	default: {
		break;
	}
	}

	return *output;
}

uint8_t srl_receive_data (srl_context_t *ctx, int num, char start, char stop, char echo,
						  char len_addr, char len_modifier)
{
	if (ctx->srl_rx_state == SRL_RXING)
		return SRL_BUSY;

	// trace_printf("Serial:SrlReceiveData()\r\n");

	if (num >= ctx->srl_rx_buf_ln)
		return SRL_DATA_TOO_LONG;

	memset (ctx->srl_rx_buf_pointer, 0x00, ctx->srl_rx_buf_ln);

	ctx->srl_rx_error_reason = SRL_ERR_NONE;

	ctx->srl_rx_kiss_mode = 0;
	ctx->srl_rx_kiss_escaping_now = 0;

	// checking if user want
	if (start != 0x00) {
		ctx->srl_triggered_start = 1;
		ctx->srl_start_trigger = start;
	}
	else {
		ctx->srl_triggered_start = 0;
		ctx->srl_start_trigger = 0;
	}

	if (stop != 0x00) {
		ctx->srl_triggered_stop = 1;
		ctx->srl_stop_trigger = stop;
	}
	else {
		ctx->srl_triggered_stop = 0;
		ctx->srl_stop_trigger = 0;
	}

	if (ctx->srl_triggered_start == 1 /*|| ctx->srl_triggered_stop == 1*/) {
		if (num < 3)
			return SRL_WRONG_PARAMS_COMBINATION;

		ctx->srl_rx_state = SRL_WAITING_TO_RX;
		ctx->srl_rx_waiting_start_time = master_time;
	}
	else {
		ctx->srl_rx_state = SRL_RXING;
	}

	ctx->srl_enable_echo = echo;
	ctx->srl_rx_bytes_counter = 0;
	ctx->srl_rx_bytes_req = num;

	if (len_addr != 0) {
		ctx->srl_rx_lenght_param_addres = len_addr;
	}
	else {
		ctx->srl_rx_lenght_param_addres = num + 1;
	}
	ctx->srl_rx_lenght_param_modifier = len_modifier;

	ctx->srl_rx_timeout_calc_started = 0;

	ctx->port->CR1 |= USART_CR1_RE;		// uruchamianie odbiornika
	ctx->port->CR1 |= USART_CR1_RXNEIE;
	ctx->port->CR1 &= (0xFFFFFFFF ^ USART_CR1_IDLEIE);


	return SRL_OK;
}

/**
 * Triggers reception of KISS protocol data
 * @param ctx pointer to serial port context
 * @param num maximum frame lenght to be received
 * @return
 */
uint8_t srl_receive_data_kiss_protocol (srl_context_t *ctx, int num)
{
	if (ctx->srl_rx_state == SRL_RXING)
		return SRL_BUSY;

	if (num >= ctx->srl_rx_buf_ln)
		return SRL_DATA_TOO_LONG;

	// clear the rx buffer
	memset (ctx->srl_rx_buf_pointer, 0x00, ctx->srl_rx_buf_ln);

	ctx->srl_rx_kiss_mode = 1;
	ctx->srl_rx_kiss_escaping_now = 0;

	ctx->srl_triggered_start = 1;
	ctx->srl_start_trigger = FEND;

	ctx->srl_triggered_stop = 1;
	ctx->srl_stop_trigger = FEND;

	ctx->srl_enable_echo = 0;
	ctx->srl_rx_bytes_counter = 0;
	ctx->srl_rx_bytes_req = num;

	ctx->srl_rx_lenght_param_addres = num + 1;
	ctx->srl_rx_lenght_param_modifier = 0;

	ctx->srl_rx_timeout_calc_started = 0;

	ctx->srl_rx_state = SRL_WAITING_TO_RX;
	ctx->srl_rx_waiting_start_time = master_time;

	ctx->srl_rx_term = 0;

	ctx->port->CR1 |= USART_CR1_RE;		// uruchamianie odbiornika
	ctx->port->CR1 |= USART_CR1_RXNEIE;
	ctx->port->CR1 &= (0xFFFFFFFF ^ USART_CR1_IDLEIE);

	return SRL_OK;
}

/**
 * This function start the transfer with
 */
uint8_t srl_receive_data_with_instant_timeout (srl_context_t *ctx, int num, char start, char stop,
											   char echo, char len_addr, char len_modifier)
{
	if (ctx->srl_rx_state == SRL_RXING)
		return SRL_BUSY;

	if (num >= ctx->srl_rx_buf_ln)
		return SRL_DATA_TOO_LONG;

	memset (ctx->srl_rx_buf_pointer, 0x00, ctx->srl_rx_buf_ln);

	ctx->srl_rx_kiss_mode = 0;
	ctx->srl_rx_kiss_escaping_now = 0;

	// checking if user want
	if (start != 0x00) {
		ctx->srl_triggered_start = 1;
		ctx->srl_start_trigger = start;
	}
	else {
		ctx->srl_triggered_start = 0;
	}

	if (stop != 0x00) {
		ctx->srl_triggered_stop = 1;
		ctx->srl_stop_trigger = stop;
	}
	else {
		ctx->srl_triggered_stop = 0;
	}

	if (ctx->srl_triggered_start == 1 /*|| ctx->srl_triggered_stop == 1*/) {
		if (num < 3)
			return SRL_WRONG_PARAMS_COMBINATION;

		ctx->srl_rx_state = SRL_WAITING_TO_RX;
		ctx->srl_rx_waiting_start_time = master_time;
	}
	else {
		ctx->srl_rx_state = SRL_RXING;
	}

	ctx->srl_enable_echo = echo;
	ctx->srl_rx_bytes_counter = 0;
	ctx->srl_rx_bytes_req = num;

	if (len_addr != 0) {
		ctx->srl_rx_lenght_param_addres = len_addr;
	}
	else {
		ctx->srl_rx_lenght_param_addres = num + 1;
	}
	ctx->srl_rx_lenght_param_modifier = len_modifier;

	// set current time as receive start time
	ctx->srl_rx_start_time = master_time;

	ctx->srl_rx_timeout_calc_started = 1;

	ctx->port->CR1 |= USART_CR1_RE;		// uruchamianie odbiornika
	ctx->port->CR1 |= USART_CR1_RXNEIE;


	return SRL_OK;
}

uint8_t srl_receive_data_with_callback (srl_context_t *ctx, srl_rx_termination_callback_t cbk)
{
	uint8_t retval = SRL_OK;

	if (ctx->srl_rx_state == SRL_RXING) {
		retval = SRL_BUSY;
	}
	else {
		// check if input pointers were set to something
		if (cbk == NULL || ctx == NULL) {
			retval = SRL_WRONG_PARAMS_COMBINATION;
		}
		else {
			ctx->srl_rx_kiss_mode = 0;
			ctx->srl_rx_kiss_escaping_now = 0;

			// set the callback pointer within the context
			ctx->srl_rx_term = cbk;

			// set the amount of bytes to be received as the size
			// of the receive buffer (minus one byte for safety).
			// it will be up to the callback function to terminate the receiving
			ctx->srl_rx_bytes_req = ctx->srl_rx_buf_ln - 1;

			// clear the rx buffer
			memset (ctx->srl_rx_buf_pointer, 0x00, ctx->srl_rx_buf_ln);

			ctx->srl_rx_bytes_counter = 0;

			ctx->srl_rx_lenght_param_addres = 0xFF;
			ctx->srl_rx_lenght_param_modifier = 0;

			ctx->srl_triggered_start = 0;
			ctx->srl_triggered_stop = 0;
			ctx->srl_enable_echo = 0;

			ctx->srl_rx_timeout_calc_started = 0;

			ctx->srl_rx_state = SRL_RXING;
			ctx->port->CR1 |= USART_CR1_RE; // uruchamianie odbiornika
			ctx->port->CR1 |= USART_CR1_RXNEIE;
			ctx->port->CR1 |= USART_CR1_IDLEIE;

			ctx->srl_rx_waiting_start_time = master_time;
			ctx->srl_rx_start_time = master_time;
		}
	}

	return retval;
}
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
