SP8EBC/ParaTNC/src/it_handlers.c

/*
 * it_handlers.c
 *
 *  Created on: 28.05.2017
 *      Author: mateusz
 */

#include "it_handlers.h"
#include "station_config_target_hw.h"

#include <delay.h>

#include "cmsis/stm32l4xx/system_stm32l4xx.h"
#include "drivers/sx1262/sx1262.h"
#include "pwr_save.h"
#include <stm32l471xx.h>
#include <stm32l4xx.h>
#include <stm32l4xx_ll_dma.h>
#include <stm32l4xx_ll_tim.h>

#include "LedConfig.h"
#include "aprs/beacon.h"
#include "aprs/telemetry.h"
#include "aprs/wx.h"
#include "drivers/analog_anemometer.h"
#include "drivers/dallas.h"
#include "drivers/i2c.h"
#include "drivers/ms5611.h"
#include "drivers/serial.h"
#include "drivers/spi.h"
#include "main.h"
// #include "afsk.h"
#include "backup_registers.h"
#include "button.h"
#include "diag/Trace.h"
#include "io.h"
#include "supervisor.h"

#include "main_freertos_externs.h"
#include "rte_main.h"

#include "station_config.h"
#include <stored_configuration_nvm/configuration_handler.h>

/*
 * TIMERS
 *
 * TIM2_IRQHandler
 * TIM4 - windspeed
 * TIM5_IRQHandler
 * TIM7_IRQHandler
 * TIM17 - TIM1_TRG_COM_TIM17_IRQHandler
 */

/// ==================================================================================================
///	LOCAL DEFINITIONS
/// ==================================================================================================

/// ==================================================================================================
///	LOCAL DATA TYPES
/// ==================================================================================================

/// ==================================================================================================
///	LOCAL VARIABLES
/// ==================================================================================================

/* Zmienne używane do oversamplingu */
static int adc_sample_c2 = 0;	 // Zmienna odliczająca próbki
unsigned short int AdcBuffer[4]; // Bufor przechowujący kolejne wartości rejestru DR
static short int AdcValue;

static uint16_t it_handlers_60sec_counter_for_increment_counters = 0;

/// ==================================================================================================
///	GLOBAL VARIABLES
/// ==================================================================================================

uint8_t it_handlers_cpu_load_pool = 0;

uint8_t it_handlers_inhibit_radiomodem_dcd_led = 0;

volatile uint32_t it_handlers_freertos_proxy = 0;

/// ==================================================================================================
///	LOCAL FUNCTIONS
/// ==================================================================================================

/// ==================================================================================================
///	GLOBAL FUNCTIONS
/// ==================================================================================================

/**
 * Sets interrupt priorities
 */
void it_handlers_set_priorities (void)
{
	NVIC_SetPriority (TIM2_IRQn, 1); // one-wire delay
	NVIC_SetPriority (I2C1_EV_IRQn, 2);
	NVIC_SetPriority (TIM5_IRQn, 3);		  // DAC
	NVIC_SetPriority (DMA2_Channel5_IRQn, 4); // ADC dma transfer (was ADC)
	NVIC_SetPriority (SPI2_IRQn, 5);
	NVIC_SetPriority (USART1_IRQn, 6);		  // kiss
	NVIC_SetPriority (USART2_IRQn, 7);		  // wx
	NVIC_SetPriority (TIM1_UP_TIM16_IRQn, 8); // periodic counters (former Systick)
	NVIC_SetPriority (EXTI4_IRQn, 9);		  // DHT22 humidity sensor
	NVIC_SetPriority (I2C1_ER_IRQn, 10);
	NVIC_SetPriority (EXTI0_IRQn, 11); // FreeRTOS api proxy
	HAL_NVIC_SetPriority (SysTick_IRQn, 15, 0U);
}

void RTC_WKUP_IRQHandler (void)
{

	rte_main_woken_up = RTE_MAIN_WOKEN_UP_RTC_INTERRUPT;

	main_reload_internal_wdg ();

	// clear pending interrupt
	NVIC_ClearPendingIRQ (RTC_WKUP_IRQn);

	// enable access to backup domain
	PWR->CR1 |= PWR_CR1_DBP;

	// enable write access to RTC registers by writing two magic words
	RTC->WPR = 0xCA;
	RTC->WPR = 0x53;

	// disable wakeup interrupt
	RTC->CR &= (0xFFFFFFFF ^ RTC_CR_WUTIE);

	// disable wakeup timer
	RTC->CR &= (0xFFFFFFFF ^ RTC_CR_WUTE);

	// clear Wakeup timer flag
	// This flag is set by hardware when the wakeup auto-reload counter reaches 0.
	// This flag is cleared by software by writing 0.
	// This flag must be cleared by software at least 1.5 RTCCLK periods before WUTF is set to 1
	// again.
	RTC->ISR &= (0xFFFFFFFF ^ RTC_ISR_WUTF_Msk);

	// wait for wakeup timer to disable
	while ((RTC->ISR & RTC_ISR_WUTWF) == 0)
		;

	EXTI->PR1 |= EXTI_PR1_PIF20;

	// disable access do backup domain
	PWR->CR1 &= (0xFFFFFFFF ^ PWR_CR1_DBP);
}

/**
 * Interrupt handler used as a proxy to call FreeRTOS interrupt safe functions, from ISR context
 * at priority higher than a value of configLIBRARY_MAX_SYSCALL_INTERRUPT_PRIORITY
 */
void EXTI0_IRQHandler (void)
{

	// clear pending interrupt
	NVIC_ClearPendingIRQ (EXTI0_IRQn);

	if ((IT_HANDLERS_PROXY_KISS_UART_EV & it_handlers_freertos_proxy) != 0) {
		BaseType_t xHigherPriorityTaskWoken = pdFALSE;
		BaseType_t xResult = pdFAIL;
		xResult = xEventGroupSetBitsFromISR (main_eventgroup_handle_serial_kiss,
											 MAIN_EVENTGROUP_SERIAL_KISS_RX_DONE,
											 &xHigherPriorityTaskWoken);

		it_handlers_freertos_proxy &= (0xFFFFFFFFu ^ IT_HANDLERS_PROXY_KISS_UART_EV);

		if (xResult != pdFAIL)

		{
			/* If xHigherPriorityTaskWoken is now set to pdTRUE then a context
			   switch should be requested. The macro used is port specific and will
			   be either portYIELD_FROM_ISR() or portEND_SWITCHING_ISR() - refer to
			   the documentation page for the port being used. */
			portYIELD_FROM_ISR (xHigherPriorityTaskWoken);
		}
	}

	if ((IT_HANDLERS_PROXY_KISS_TX_UART_EV & it_handlers_freertos_proxy) != 0) {
		BaseType_t xHigherPriorityTaskWoken = pdFALSE;
		BaseType_t xResult = pdFAIL;
		xResult = xEventGroupSetBitsFromISR (main_eventgroup_handle_serial_kiss,
											 MAIN_EVENTGROUP_SERIAL_KISS_TX_DONE,
											 &xHigherPriorityTaskWoken);

		it_handlers_freertos_proxy &= (0xFFFFFFFFu ^ IT_HANDLERS_PROXY_KISS_TX_UART_EV);

		if (xResult != pdFAIL)

		{
			/* If xHigherPriorityTaskWoken is now set to pdTRUE then a context
			   switch should be requested. The macro used is port specific and will
			   be either portYIELD_FROM_ISR() or portEND_SWITCHING_ISR() - refer to
			   the documentation page for the port being used. */
			portYIELD_FROM_ISR (xHigherPriorityTaskWoken);
		}
	}

	if ((IT_HANDLERS_PROXY_GSM_RX_UART_EV & it_handlers_freertos_proxy) != 0) {
		BaseType_t xHigherPriorityTaskWoken = pdFALSE;
		BaseType_t xResult = pdFAIL;
		xResult = xEventGroupSetBitsFromISR (main_eventgroup_handle_serial_gsm,
											 MAIN_EVENTGROUP_SERIAL_GSM_RX_DONE,
											 &xHigherPriorityTaskWoken);

		it_handlers_freertos_proxy &= (0xFFFFFFFFu ^ IT_HANDLERS_PROXY_GSM_RX_UART_EV);

		if (xResult != pdFAIL)
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
