SP8EBC/ParaTNC/(commit log)

2017-08-20 Fix of critical bug in makefile and add wiring description
2018-04-17 first sketch of the dht22 sensor driver
2018-04-18 sht22 driver almost ready
2018-04-20 humidity sensor working with ms5611 and dallas on the same time
2018-04-21 little bugfix in main and testing without trace_printf
    [main.cpp]
2018-05-01 fix in kiss communication with host
    [TimerConfig.c, main.cpp]
2018-05-07 cirital bug fixed in PathConfig.h
    [PathConfig.c]
2018-05-07 sample config file and new gitignore
2018-12-29 interrupts routines moved to it_handlers.c
2019-01-02 refactoring serial driver, code actually in incompilable state
2019-01-02 daily commit with work on serial driver
2019-01-12 serial driver in compilable form
2019-01-13 full duplex transmission over UART
2019-01-13 Systick configuration and timeout keeper for uart
2019-01-22 refactoring of i2c code
2019-01-23 i2c timeout handler added, trasmit delay in afsk
2019-01-26 a lot of refactoring in drivers
2019-02-10 few bugfixed around KISS communication with host
    [KissCommunication.c, KissCommunication.h, main.c, main.h, serial.h]
2019-03-13 new way of testing uart
2019-04-16 bugfixes according to possible out of range buffers access
    [rte_wx.c]
2019-04-28 quality factor for ds12b20 fix
    [dallas.c, main.h, packet_tx_handler.c, wx_handler.c]
2019-05-04 added slew rate limiter to tx20 driver
2019-05-05 added function to generate kiss frame from own aprs frames
2019-05-05 sending own generated WX frames do host via KISS
2019-07-06 a bugfix of major bug in sleew rate limiter in tx20 support
    [main.h]
2019-08-21 prototype version with splited RX and TX pin for dallas one wire
2019-08-28 storing input pin in separate variable
2019-09-03 one-wire moved from pins conflicting with i2c. ELF name changed
2019-09-08 - Fixed i2c timeout keeper - Added new function to reinitialize i2c controller after failure - Fixed CRC4 calculation for MS5611 sensor driver - Fixed timeout handling in MS5611 sensor driver
    [main.c, main.h, ms5611.c, ms5611.h, wx_handler.c]
2019-09-08 - Added a pressure and temperature validator in MS5611 driver basing on min & max values
2019-09-11 - Fixed critical bug in TX20 anemometer driver , which caused gusts to be calculated wrong - Button will trigger WX packets instead of Beaons if _METEO is triggered
    [main.c, main.h]
2019-09-24 hardware documentation and gerber files added
    [b.gbl, bs.gbs, opis.gbl, opis.gtl, t.gtl, ts.gts]
2019-10-02 corrected gerber files
    [b.gbl, bs.gbs, opis.gbl, opis.gtl, t.gtl, ts.gts]
2019-10-27 - Merging USART driver from ParaMETEO-UMB project to fix a bug with sending first byte twice - Merging Dallas one-wire temperature sensor from ParaMETEO-UMB to provide temperature averaging
    [dallas.c, dallas.h, main.c, packet_tx_handler.c, rte_wx.c, rte_wx.h, wx_handler.c]
2019-10-30 extended pressure resolution to proper .1 of hPa
2019-12-16 resetting power to sensors if no comms received
    [it_handlers.c, main.c, main.h, wx_handler.c, wx_handler.h]
2019-12-22 temperature slew rate inhibiter to allow first measuremenets to be retrieved from the sensor
2019-12-26 first sketch of a driver for analogue pulses/voltage anemometers
    [skalowania.ods]
2019-12-27 analogue windspeed
    [skalowania.ods]
2019-12-28 DMA Channel 7 initialization functionality refactored to external file to stub in UT
2020-01-01 function to convert time between pulses to windspeed
    [skalowania.ods]
2020-01-04 Set of features implemented in code responsible for handling an analogue anemometer -> timer capture-compare configuration -> dma configuration to copy timer values into buffer -> converting impulse 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
    Missing wind direction sensing using external U/f ic
    [LedConfig.c, it_handlers.c, main.c, main.h, packet_tx_handler.c, rte_wx.c, rte_wx.h, wx_handler.c]
2020-01-05 new readme, schematics, partlist etc
2020-01-30 wind direction calculation basing on the frequency value
    [skalowania.ods]
2020-02-01 direction from analog anemometer corrected
    [analog_anemometer.c, analog_anemometer.h, it_handlers.c, main.c, main.h, rte_wx.c, rte_wx.h, wx_handler.c]
2020-02-02 recalculation of the wind direction angle fixed
    [analog_anemometer.c, analog_anemometer.h, main.c]
2020-02-23 - First cketch of UMB client (UMB master) - Conditional compiling of analog anemometer driver
2020-03-01 more tweaks within analog anemometer driver
2020-03-03 some more refactoring inside tx20 driver
2020-03-03 quick bugfix in SendWXFrame
    [main.h]
2020-03-06 calculating targer ms5611 pressure value from average calculated from 4 elements long history
2020-03-26 - handling timeout for serial port when driver is waiting for starting receive - sending quality factor for anemometer
2020-03-29 fixed umb quality factor calculator
    [main.c, main.h, packet_tx_handler.c, serial.h]
2020-04-04 changed configuration of UART pin. Added hardware errata
    [main.c, main.h, rte_wx.c, rte_wx.h]
2020-04-10 sending a status message on UMB errors
    [main.c, main.h, packet_tx_handler.c, rte_wx.c, rte_wx.h]
2020-04-11 - Storing an error code from a response on UMB offline request - Sending status on any UMB errors detected
    [main.c, main.h, packet_tx_handler.c]
2020-04-11 software version changed to correct one
    [main.h]
2020-04-12 multi uart based on DE08 software version
2020-04-13 new context aware serial drivers tested with HW-RevA
2020-04-18 errata to hardware design files
    [b.gbl, bs.gbs, opis.gbl, opis.gtl, t.gtl, ts.gts]
2020-04-27 handling missing i2c state
    [main.c, main.h]
2020-05-09 corrected coefficient in analog anemoemter calc
    [analog_anemometer.c, main.c, main.h]
2020-06-06 bugfix in routine which sends wx using kiss
    [main.h, packet_tx_handler.c]
2020-06-14 added watchdog, changed telemetry temperatuer scaling
2020-06-21 longer IWDG watchdog to omit a reset during sending telemetry description
    [main.c]
2020-06-21 - Bosh BMA150 sensor deiver prototype - bugfixes in i2c (sending only first byte, correct types of function parameters)
    [bma150.c, i2c.h, main.c, main.h, ms5611.c, rte_wx.c, rte_wx.h, wx_handler.c]
2020-06-21 function to read raw measuremenets from sensor
2020-06-23 work on bme280 drivers, the name of files was corrected
    [bme280.c, bme280.h, main.c, rte_wx.c, rte_wx.h, wx_handler.c]
2020-06-26 bugfix with not enabling the timer back after the U/f converter failure
    [analog_anemometer.c, main.h]
2020-07-11 BOM to hardware revision C added
2020-07-12 led blinking code unified
2020-07-25 Quality Factors unified across different kinds of sensors
2020-08-05 Viscous digi in prototype state
2020-08-06 first sketch of Davis Vantage Pro2 driver
2020-08-25 added serial receive function with immediate timeout calculation. first test and minor bugfixes in davis code
    [main.c, serial.h]
2020-08-30 a little bit more photos of partially assembled pcb
2020-09-02 bugfix in serial driver code which were handling len_modifier parameter in wrong way
    [main.c]
2020-09-25 few bugfixes in mobus rtu and serial driver
    [main.c]
2020-09-26 few more bugfixes in serial driver and serial crc callback for modbus rtu
    [it_handlers.c, main.c, serial.h]
2020-10-11 modbus-rtu scaling corrections, digi initialization and mute own packets
    [main.c, main.h, wx_handler.c]
2020-10-18 experiments with sserial driver
2020-10-18 untested - changes within modbus-rtu and serial code to fix problem with idle frames
    [serial.h]
2020-10-24 more modbus-rtu channels and errors status messsage
    [main.c, main.h, rte_main.c, rte_main.h, rte_wx.c, rte_wx.h, rtu_configuration.h]
2020-10-27 modbus rtu: rx error counters for each functions in queue
    [rtu_configuration.h]
2020-10-28 configuration for polaris, sopotnia wielka and compilation date pumped up
2020-10-29 fix in modbus-rtu I/O routines and cpu load calculator
    [LedConfig.h, delay.c, delay.h, it_handlers.c, main.c, main.h]
2020-10-30 serial driver hotfix
2020-11-04 Squashed commit of the following:
    commit b986715dd438d4579029296317b72ef17fdaa2b8
    Author: Mateusz Lubecki <sp8ebc@interia.pl>
    Date: Wed Nov 4 17:01:46 2020 +0100
    telemetry tweaking
    commit 5d4e9f7de0ed479224db92fe7b1df72ef5a51660
    Author: Mateusz Lubecki <sp8ebc@interia.pl>
    Date: Wed Nov 4 07:25:45 2020 +0100
    reverting modbus rtu changes
    [main.c, main.h, packet_tx_handler.c]
2020-11-05 modbus-rtu: sensor power control and quality factors adjusted to modbus-rtu com errors, changed value returned from getters when parameters is not conf
    [main.h, rte_wx.c, rte_wx.h, rtu_configuration.h, wx_handler.c]
2020-11-25 fixes in wx packets content and min/max valid pressure
    [rtu_configuration.h]
2020-11-27 bugfix in rtu temperature getter
2021-01-07 waiting for a while if more than one frame is transmitted from single packet_tx_handler call
2021-01-09 Sparkfun SEN15901 aka PM1S analog/mechanic anemometer
    [skalowania.ods]
2021-01-12 some configuration moved to the separate structure instead of direct defines. bugfix for callsigns shorter than 6 characters
    [PathConfig.c, PathConfig.h, config_data.h, main.c, main.h]
2021-02-26 fixed compilation for certain configurations
    [main.h, packet_tx_handler.c]
2021-03-09 bugfixing specific for certain station configuration
    [main.h, rte_wx.c, rte_wx.h, wx_handler.c]
2021-03-11 some refactoring and changes in cooperating between modbus-rtu and internal sensors
2021-03-12 quality factors in telemetry for BME sensor
2021-03-13 fixed anemometer watchdog, adjusted timers not to spam RF network as much
    [main.h, packet_tx_handler.c, wx_handler.c]
2021-03-23 worarounds of problem with communication with PV controller
    [main.c]
2021-03-23 fixed string fields lenght in config data
    [config_data.h]
2021-03-23 average queue lenght inside VE.direct driver shortened
2021-04-04 open collector initialization moved before turning on relay
2021-04-23 changed liker script to allocate less space for the stack to fix crashes with sprintf, refactoring of wx_handlers almost done
    [config_data.h, wx_handler.c, wx_handler.h, wx_handler_humidity.c, wx_handler_humidity.h, wx_handler_pressure.c, wx_handler_pressure.h]
2021-04-24 fixed bug in bme280_get_humidity
    [analog_anemometer.c, bme280.c, wx_handler.c, wx_handler_temperature.c]
2021-04-29 working linker script placing the configuration structures in right places in sections
    [configuration_handler.h]
2021-05-09 configuration restoring
    [configuration_handler.h]
2021-05-12 float to string converting function
    [configuration_handler.h]
2021-05-18 reseting +12V_SW in meteo watchdog and rebooting whole controller in case of hard temperature measurement fault
    [main.c, main.h, wx_handler.c, wx_handler.h]
2021-05-24 fix weird openocd issues with erasing flash memory
    [io.c, main.h]
2021-05-24 bugfixes in UMB protocol driver - using serial port context
    [main.c, packet_tx_handler.c]
2021-05-27 added system files for stm32l4xx
2021-05-30 analog anemometer driver and dallas one wire drivers ported to stm32l4 platform
2021-05-30 serial driver reworked to work on stm32l4xx family
    [i2c_stm32f1x.c, main.c, serial_stm32f1x.c, serial_stm32l4x.c]
2021-06-04 few more files refactored to stm32l4x
2021-06-06 flash programming driver for stm32l4x
2021-06-13 porting main.c and serial driver
2021-06-13 compiling but not linking for stm32l471
    [configuration_handler.h]
2021-06-13 stm32l471 startup assembling fixed
2021-07-03 adc calibration fixed
2021-07-05 i2c seems to initialize properly
2021-07-06 i2c works but w/o timeout handling
2021-07-06 i2c timeout enabled
2021-07-07 some bugfixes in usart driver
    [main.c, serial.h, serial_stm32l4x.c]
2021-07-31 counting too big u/f frequency output
    [analog_anemometer.c]
2021-08-01 ADC initialization corrected
2021-08-03 PLL configuration corrected for L476_Parameteo target
    [io.c, it_handlers.c]
2021-08-18 return values from drivers
2021-08-22 wakeup timer configuration moved to separate function
2021-08-22 power save function but not yet working
2021-08-23 first working prototype of freezing micro in STOP2
2021-08-23 power modes explanation in pwr_save.h
2021-09-01 powersaving features
2021-09-10 a lot of work on powersaving
2021-09-11 some changes around and related to power saving
2021-09-12 daily with power saving works
2021-09-13 bugfixes in DAC configuration
    [it_handlers.c, main.c, pwr_save.c, pwr_save.h]
2021-09-21 fixed wind speed handling & regarding dma configuration
    [TimerConfig.c, analog_anemometer.c, it_handlers.c, main.c, main.h]
2021-09-21 led diodes switching corrected
    [LedConfig.h, it_handlers.c]
2021-09-22 few improvements in powersaving
2021-09-22 error bigger/bigger-equals within powersaving handler
    [pwr_save.c]
2021-09-28 bugfixes: wind direction > 180 degrees and spikes on windspeed
    [analog_anemometer.c, analog_anemometer.h, main.h, pwr_save.c, pwr_switch.c, rte_wx.c, rte_wx.h, station_config_target_hw.h]
2021-11-29 some unfinished bugfixes in digipeater code
    [main.c, main.h]
2022-01-03 bugfix in handling ParaMETEO power, missing io_12v_sw___cntrl_vbat_g_disable call
    [main.h, pwr_switch.c, station_config_target_hw.h]
2022-01-09 bugfix in digi initialization
    [main.h, pwr_save.c, pwr_save.h]
2022-01-11 changed linkerscript for parameteo
    [configuration_handler.h]
2022-01-12 flashing config from kiss transmission
    [configuration_handler.h]
2022-01-13 removed sections for configuration data from ParaMETEO linker script, temporary workaround for ParaMETEO hw rev b power management
    [config_data_default.c, configuration_handler.c, main.c, pwr_save.c]
2022-01-25 uart rx terminating callback for sim800c
2022-02-17 bugfix in serial port driver and sim800 engineering
    [main.c, serial_stm32l4x.c]
2022-02-20 fixing corrupted STM32F100 build
    [configuration_handler.c, main.c, main.h]
2022-02-26 sim800 aprsis logging working, fixed serial reset in wrong place
    [aprsis.c, aprsis.h, main.c]
2022-03-06 aprsis beacon and closing connection of failed login attempt
    [aprsis.c, aprsis.h, main.c, main.h]
2022-03-27 cutoff on too low battery voltage
    [io.c, it_handlers.c, main.c, packet_tx_handler.c, pwr_save.c, pwr_save.h, rte_main.c, rte_main.h]
2022-04-03 fix in +5V_C voltage switching in ParaMETEO
    [io.c, main.c, pwr_save.h, station_config_target_hw.h, wx_pwr_switch.c, wx_pwr_switch.h]
2022-04-05 sending battery voltage in telemetry
2022-04-05 bugfix in windsensor handling related to misusing power supply state
    [analog_anemometer.c, io.h, main.h, wx_handler.c]
2022-04-06 bugfix in low voltage cutoff, switching powersave mode on low battery voltage, eight bit in telemetry to send low battery warning
    [main.h, packet_tx_handler.c, pwr_save.c, pwr_save.h, pwr_save_configuration.h]
2022-04-07 bugfix in serial port driver regarding switching between internal and external tx buffer
    [main.c, main.h, serial.h, serial_stm32f1x.c, serial_stm32l4x.c]
2022-04-08 bugfix in sending VBATT_LOW in telemetry
    [main.h]
2022-04-09 bugfix in powersaving, wrong handling voltage between cutoff and low level, sending battery voltage with startup beacon
    [main.c, main.h, packet_tx_handler.c, pwr_save.c]
2022-04-10 missing headers for http request
    [aprsis.c]
2022-04-19 pwm input
2022-04-20 Merge: Fixing wakeup deadlock during cutoff (#7)
    * averaging measred battery voltage
    * bugfix in average battery voltage, using average vbatt only in telemetry
    * sending status message on any change of cutoff state
    * bugfix with DCD deadlock after wakeup
    * some random debugging with deadlock
    * more debugging
    * bugfix in measuring Vbatt voltage, vbatt averager separated from getter
    * some comments
    [io.c, io.h, it_handlers.c, main.c, main.h, packet_tx_handler.c, pwr_save.c, pwr_save_configuration.h]
2022-04-20 configuration files reorganized
    [parameteo-test-raw-packets.txt]
2022-04-22 switchng pwr_save_pooling to use average battery voltage instead of momentary
2022-04-30 http client rx callback fix for empty response body
    [aprsis.c]
2022-05-06 gsm module power button control
2022-05-07 weather sensor pooling fixed
    [io.h, wx_handler.c]
2022-05-08 api, aprsis: send data to both systems. fixed indexer configuration
    [aprsis.c, aprsis.h, main.c, packet_tx_handler.c, packet_tx_handler.h]
2022-05-08 gsm tcpip close function bugfix, comments and hashdefines cleaned
    [api.c, aprsis.c, aprsis.h, io.c, main.c, packet_tx_handler.c, station_config_target_hw.h]
2022-05-09 daily, a lot of reworking. tcp disconnecto doesn't work
    [api.c, aprsis.c, aprsis.h, main.c, main.h]
2022-05-11 reseting pool timers in main.c
    [main.c, main.h, pwr_save.c]
2022-05-23 ZZ06 unstablegit add *git add *
    [analog_anemometer.c, main.h, pwm_input_stm32l4x.c]
2022-05-25 return type for sim800 gsm module driver. api client now accepts ports greater 9999
2022-06-07 fixed TE control pin for rs495 transveriver
    [io.c]
2022-06-08 storing temperature readings for all sensors enabled. bugix? or workaround? of pwm input code
    [main.h, pwm_input_stm32l4x.c, rte_wx.c, rtu_configuration.h, wx_handler_temperature.c]
2022-06-08 pwm input frequency clock increased
2022-06-09 added M4a powersave mode which allows to keep gsm modem enabled in normal powersave modes, added missing api fields
    [api.c, api_configuration.h, config_data.h, config_data_default.c, config_data_first.c, config_data_second.c, main.h]
2022-07-02 switching to i5 mode instead of sleepin in l6 and l7 of RTC isn't working
2022-08-04 critical bugfix in stm32l4 serial driver - to narrow type srl_rx_lenght_param_addres, improved callback for tcpip connecting
    [serial_stm32l4x.c]
2022-08-07 not working linkerscript for STM32L476 target - to be fixed
    [main.h]
2022-08-14 reworked configuration handler for STM32L476 target
    [config_data_first.c, config_data_second.c, configuration_handler.c]
2022-08-15 configuration NvMem area properly handled for STM32L4xx target
2022-08-18 daily with kiss commnication
    [configuration_handler.h]
2022-08-20 fix with erasing flash memory in STM32F100 target
    [configuration_handler.c, main.h]
2022-08-21 bufix stm32f100: do not read a content of DR register in IDLE state handler within irq handler, callback and pooling callback for KISS_GET_RUNNING_CONFIG
    [configuration_handler.h]
2022-08-26 bufix in offsetting current config
2022-08-28 crc32 calculation replaced with software library
    [configuration_handler.c]
2022-08-29 fixed restoring default configuation on parameteo
    [configuration_handler.c, kiss_callback.c, main.c]
2022-09-08 kiss protocol: erasing and downloading startup config
    [configuration_handler.h]
2022-09-13 kiss communication: fixed flashing startup
    [kiss_callback.c]
2022-09-17 dust sensor sketch
    [configuration_handler.h]
2022-09-18 dust sensor: first working sketch
2022-09-19 config data: engineering to disable some stuff in the application
    [configuration_handler.h]
2022-09-20 api: mac calculation
    [configuration_handler.h]
2022-09-22 fatfs integration, first version of spi library
2022-09-25 spi daily
2022-09-28 spi, something not work
    [max31865.c, spi_stm32l4xx.c]
2022-10-02 spi expiremnts almost working
2022-10-02 spi seems to work
2022-10-03 max31865 pooling - not finished, some tweaks and comments for spi driver
2022-10-04 retrieving raw results from pt100 sensor
2022-10-05 conveting max ADC results into temperature
2022-10-05 max31865: another way of converting to temperature
2022-10-20 temperature handling refactoring
2022-10-22 temperature measurement handling refactored (probably)
2022-10-30 spi data race fix to be tested
    [max31865.c, spi_stm32l4xx.c]
2022-11-05 vbat measurement: disabling adc after taking measure
2022-11-05 race condition in RTC clock selection fixerd
    [main.c, pwr_save.c]
2022-11-05 poting missing stuff from max31865
    [max31865.c, max31865.h]
2022-11-06 sending rtc state and battery voltage in bootup beacon
2022-11-06 last value from average and storing current fault status from max31865
2022-11-06 bugfix: transient glitch with turning vbat_c on during startup
    [io.c, main.c]
2022-11-20 patch to make STM32F100 work again
2023-01-31 backport max31865 driver from tatry variant
2023-01-31 backporting spi driver changes from tatry variant
2023-02-01 vbat_r power cycle daily
    [configuration_handler.h]
2023-02-02 power cycling vbat_r if engineering2 is enabled
2023-02-03 cycle vbat r only when radio is not transmitting
    [configuration_handler.h]
2023-02-14 bugfix of ms5611 pressure measurements bouncing up and down
    [main.h, packet_tx_handler.c]
2023-04-09 conditional compilation of nvm logger using platform depends defines, loading battery scaling from configuration
    [configuration_handler.h]
2023-06-02 switchin vbatt_m on and off
2023-06-02 bugfix: wrong sizeof argument leading to damaging modbus rtu config
    [configuration_handler.c, main.h]
2023-06-10 - Move push button handling to seaparate *.c and *.h files - Store SIM card and gsm network registration status in dedicated enums - Power cycle and reset GPRS modem if there is SIM card failure or i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
    [configuration_handler.h]
2023-06-12 WARNING THIS COMIT DOESNT COMPILE!! Please previous or next one. Requesting engineering from GSM module and button handling
2023-06-12 buttons with programable function
    [configuration_handler.h]
2023-06-14 sketch of aprs-is igate
    [configuration_handler.h]
2023-06-16 fixes in aprsis igate code after ut
    [aprsis.c, aprsis.h, main.c, main.h, packet_tx_handler.c]
2023-06-21 initialize io for buttons only if there is any function configured to them
2023-06-27 kiss communication dids
    [configuration_handler.h]
2023-06-29 did daily
    [configuration_handler.h]
2023-07-22 - KISS DID: distinguish size_byte value for integer and float types - KISS DID: returning did value as first two bytes, before size_byte - KISS diagnostics: bugfix in NRC service identifier - APRS-IS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
    [aprsis.c, kiss_callback.c, main.c, packet_tx_handler.c, pwr_save.c, rte_main.c]
2023-07-22 - KISS DID: distinguish size_byte value for integer and float types - KISS DID: returning did value as first two bytes, before size_byte - KISS diagnostics: bugfix in NRC service identifier - APRS-IS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
    [aprsis.h, aprsis_config.h, kiss_configuation.h, main.c, main.h, packet_tx_handler.c, pwr_save.c]
2023-07-22 aprs-is igate: adding missing newline after data to be sent to server, inhibiting some status messags while in aggresive powersave, sligtly different reinitialization after waking up
    [aprsis.c, io.c, io.h, main.c, main.h, packet_tx_handler.c, packet_tx_handler.h, pwr_save.c]
2023-07-23 restarting ADC after wake up if conversion is not working
    [main.c]
2023-07-23 aprs-is igate: bugfix not receiving data from server after non-heartbeat was received
    [aprsis.c]
2023-08-01 Update CURRENT-DRAW-MEASUREMENTS
2023-10-08 reworking L6/L7 powersave modes with STOP2 sleep completely to engage iwdg
    [it_handlers.c, main.c, main.h, pwr_save.c, pwr_save.h, pwr_save_configuration.h, rte_main.c, rte_main.h]
2023-10-09 powersave rework around handling an exit from STOP2 sleep
    [pwr_save.c, pwr_save.h]
2023-10-11 reduced frequency of modbus rtu status messages on error
    [pwr_save.c, pwr_save.h, rtu_configuration.h]
2023-10-15 different way of handling aprsis timeout and do not query for engineering while reconnecting
    [configuration_handler.h]
2023-10-16 aprsis: another watchdog to reset controller if connection cannot be established for very long time
    [aprsis.c, aprsis.h, main.c, main.h, pwr_save.c, pwr_save.h]
2023-10-22 refactoring rtc backup registers set/get/reset to separate code module
    [backup_registers.c, backup_registers.h, configuration_handler.c, it_handlers.c, main.c, main.h, packet_tx_handler.c, packet_tx_handler.h]
2023-10-29 aprsis: sending gsm status to aprs-is server, powersave: different handling of cutoff event using both average and current measurements, powersave: sampling battery voltage every 10 seconds instead o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
2023-10-30 aprsis telemetry: battery voltage fix, serial port driver: disable TX interrupts while there is an interrupt in TX_IDLE state, powersaving: few changes and deinitializing GSM uart before go to deep s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
    [aprsis.c, aprsis.h, main.c, packet_tx_handler.c, pwr_save.c, pwr_save.h, serial_stm32l4x.c]
2023-10-30 revert changes in serial drivers
    [serial_stm32l4x.c]
2023-10-31 simplified state machine for aggressive powersaving in WX + GSM mode, inhibiting powersave state machine when GSM module may be busy on sending weather packet
2023-11-01 internal watchdog enabled once again, fixed quality factor for modbus-rtu himidity sensors, average voltage margin for cutoff condition
    [main.h, packet_tx_handler.c, pwr_save.c, pwr_save_configuration.h, rte_wx.c, rte_wx.h, software_version.h, wx_handler_humidity.c]
2023-11-05 kiss did: few bugfixes here and there. warninggit add * internal watchdig is disabledgit add *!
    [backup_registers.c, main.h, variant.h, variant_parameteo.c]
2023-11-12 kiss communication. did: bugfix in lengh of response, get_version: bugfix in overwriting first byte of a response
    [kiss_callback.c, software_version.h]
2023-11-17 dallas temperature sensor: different handling of measurement results depends on quality factor, set qf to degraded if temperature is below or above set treshold. removed modbus rtu status message com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
2023-11-19 internal watchdog enabled once again. bugfix in sending telemetry channel descritpions
    [aprsis.c, aprsis.h, main.c, main.h, rte_main.c, rte_main.h, software_version.h, variant.h]
2023-11-26 bugfix in read DID response handler
    [memory_map_parameteo_stm32l476.xls]
2024-04-15 watchdog reenabled
    [memory_map_parameteo_stm32l476.xls]
2024-04-18 counting restarts caused by verification failure
    [memory_map_parameteo_stm32l476.xls]
2024-05-07 decoding and encoding kiss diagnostic messages as aprs messages
    [memory_map_parameteo_stm32l476.xls]
2024-05-23 remapping application completely to make a room for bootloader. doubling vector table to 0x08000000 to be able to run app without flashed bootloader
    [memory_map_parameteo_stm32l476.xls]
2024-05-26 nvm event logger and security access
    [configuration_handler.h, memory_map_parameteo_stm32l476.xls]
2024-07-03 cpu clock increased to 48MHz for STM32L476 target
2024-07-05 parameteo: cpu speed switchable by define
2024-07-05 prefilling battery voltage measurements
2024-07-13 NvmEvents2 (#15)
    * nvm
    * refactored some nvm event code to separate file
    * daily
    * nvm_event_log_push_new_event reworked to use x-macro
    * macro to create pointers for each logging instance
    * nvm event logger
    * nvm event logger, documentation and comments to macros and the module configuration
    * nvm event: commit before refactoring this bullshit
    * ready for integration
    * ready for second integration
    [memory_map_parameteo_stm32l476.xls]
2024-07-22 new event log format, timers prescaler
    [memory_map_parameteo_stm32l476.xls]
2024-07-24 spi chip select initialization fixed for hardware revision f
    [analog_anemometer.c, spi_slave_config.h, spi_stm32l4xx.c]
2024-08-03 probe max31865 temperature on bootup phase and disable dallas one wire from configuration
    [configuration_handler.h]
2024-08-17 ntp client, gsm communication state handler, fix in TCP connect callback
    [aprsis.c, aprsis.h, gsm_comm_state_handler.c, gsm_comm_state_handler.h, main.c]
2024-09-08 interrupting ntp and api communication if tcpip connection cant be established too many times. configuring PT1000_PT100 by station_config.h file
2024-09-16 few fixes in diagnostics routing control - returning general_reject, fixing 5254 routine - rtc set
    [kiss_callback.c, kiss_nrc_response.h]
2024-09-20 bugfix in memory validation for SRAM2
    [software_version.h, variant_parameteo.c]
2024-09-22 checking if max31865 suggest that PT is no connected, different way of checking weather measurements, more error and warning logging in aprsis
    [analog_anemometer.c, aprsis.c, aprsis.h, backup_registers.c, backup_registers.h, event_log.c, kiss_did_configuration.h]
2024-09-22 commenting out inhibit powersave
2024-09-23 less restrictive conditions to wakeup after cutoff due to low battery voltage
2024-09-29 HI_SPEED reduced to standard 24MHz, battery voltae measurement set to continous, do not turning TIM2 when it is not neccessary
2024-09-29 noreset debug launch configuration
    [stm32l4x-noreset.cfg]
2024-09-29 battery voltage measurement switched to non continous
2024-10-01 corrected cutoff average voltage margin
    [pwr_save_configuration.h, software_version.h]
2024-10-13 parameteo hw-rev f schematics and bom
    [bom_parameteo_hwrev_f.xls]
2024-10-21 umb master: checking if currently there is no other service request pending
2024-10-21 some delay after power button is pressed for gsm modem
2024-10-21 power cycling gsm modem if the handshake is not finished in long amount of time
2024-10-26 event log: changed entry structure to fix critical problem with misalignment with flash page size
    [memory_map_parameteo_stm32l476.xls]
2024-10-27 event log: calculating crc for each entry and counting errors
    [event_log.c, event_log.h, nvm_event.h]
2024-10-30 rework nvm_event_log_find_first_oldest_newest to remove continue statement in for loop, implementation of nvm_fix_broken_event_ids
    [event_log.h, memory_map.h, nvm_event.h, variant.h, variant_parameteo.c]
2024-11-09 correct handling of serial kiss protocol natively within a driver code, including escaping
    [event_log.h, event_log_t.h, kiss_communication.h, kiss_communication_defs.h, kiss_did_configuration.h, main.c]
2024-11-17 bugfix in generating nvm timestamp to take leap years into account, logging errors from UMB driver, disabling internal sensor completely
    [config_data_default.c, config_data_first.c, config_data_second.c, event_log.c, event_log_strings.h, main.c]
2024-11-19 new events from SIM800 driver code, option to disable wx values validation
    [configuration_handler.h]
2024-12-05 little bugfix in serial driver, umb watchdog
    [main.c, serial_stm32l4x.c, software_version.h, wx_handler.c]
2024-12-14 bugfix in umb watchdog
    [software_version.h, wx_handler_temperature.c]
2024-12-15 spi driver to exchange data at single transaction
2024-12-23 Agresive powersave test (#16)
    * dupa
    * aggressive powersave schedule
    [configuration_handler.h]
2024-12-27 aggressive powersave schedule. WARNINGgit add *! going to sleep not working. wakeups immediately for some reason
    [TimerConfig.c, build_datetime.h, config_data.h, it_handlers.c, main.c, packet_tx_handler.c, packet_tx_handler.h, pwr_save.c]
2024-12-28 fixed a bug with selecting RTC clock source, what caused sleeping to be completely screwed
    [build_datetime.h, it_handlers.c]
2024-12-31 powersave mode callback fixed to validate aggressive powersave wx frames interval
    [build_datetime.h, packet_tx_handler.c]
2025-01-20 spi driver: changes in IRQ handling for exchange mode. NEEDS THOROUGH TESTING
2025-01-25 sx1272 api for io pins control, full api to rf and status. first successfull TCXO startup and switch to stby xosc mode
2025-01-30 sx1262: fixed code to set interrupt mask, successfull transmit and then irq set
    [build_datetime.h, main.c, sx1262_irq_dio.c]
2025-02-09 fanet: assembling weather frames
2025-02-19 sx1262: driver fixedgit add *!
    [build_datetime.h, main.c, sx1262_modes.c]
2025-03-12 decoding supervisor failt and hardfault events
    [build_datetime.h, event_log.c, event_log_postmortem.c, event_log_strings.h]
2025-03-13 sx1262: looks like something which is transmitted wo problems
    [build_datetime.h, fanet_app.c]
2025-03-16 fanet test code, better way to blink leds
2025-04-24 sx1262: move busy to proper pin, add define to switch if schmidt-not trigger is put on busy and int
2025-05-13 sx1262: checking a result of call do SPI driver
2025-05-15 analog_anemometer: critical fix, initializing GPIO_InitTypeDef.OutputType to default value. probably fix for sx1262
    [analog_anemometer.c, build_datetime.h, fanet_app.c, main.c, spi_stm32l4xx.c, sx1262_internals.c, sx1262_internals.h, sx1262_irq_dio.c]
2025-05-19 sx1262: cleaning intermediate debug storage for last spi values
2025-06-03 spi interrupt restoerd
2025-06-06 sx1262: busy signal handled by interrupt
2025-06-08 sx1262: bugfix in sx1262_rf_packet_type_t
    [build_datetime.h, fanet_app.c, sx1262.c, sx1262_rf.c, sx1262_rf.h]
2025-06-17 sx1262: bugfix in function sx1262_data_io_write_buffer. solved a problem with unwanted zero appended to before data start
    [sx1262_data_io.c]
2025-06-26 partial fix for fanet weather frames
    [build_datetime.h, fanet_app.c]
2025-07-10 fanet: fix of weather frames
    [build_datetime.h, fanet_app.c]
2025-08-17 refactoring power saving pooling stuff to separate task and some static analysis fixes
    [analog_anemometer.c, build_datetime.h, configuration_handler.c, event_log.c, gsm_comm_state_handler.h, main.c, main_freertos_externs.h]
2025-08-17 power saving task working and waiting for another tasks not running
2025-08-18 rtos: suspending and restarting tasks for powersaving operation
2025-08-23 all tasks moved to separate directory, KISS serial communication handled by separate event-driven task, currently asserts on about 10 percents
2025-08-24 FreeRTOS: interrupt prioriuty grouping changed
2025-09-01 critical section around every sprintf, custom thread-safe sprintf
2025-09-03 gsm uart rx and tx done events
2025-09-28 fix: event on kiss serial port tx done
    [build_datetime.h, it_handlers.c]
2025-10-16 adc with oversampling and realtime audio processing handled by DMA
2025-11-01 dallas driver with critical sections
2025-11-05 fix storing task name in event_log_postmortem_checknstore_supervisor
    [build_datetime.h, event_log_postmortem.c, supervisor_config.h]
2025-11-06 delay_fixed replaced by rtos sleep when available, supervisor timeouts decreased to more sane values
    [build_datetime.h, delay.c, main.c, main.h, supervisor_config.h, task_fanet.c, task_ten_second.c]
2025-11-12 a way to disable analog anemometer and digi completely from config, additional logging for umb master library
    [configuration_handler.h]
2025-11-14 wx uart handling for UMB protocol moved to separate task
2025-11-27 supposed fix of a bug with UMB crc errors handling
    [build_datetime.h]
2025-12-04 resetting correct events in it_handlers_freertos_proxy. WATCHDOG DISABLEDgit add *!
    [build_datetime.h, it_handlers.c, main.h, software_version.h]
2025-12-10 kiss_program_startup.c refactored to separate file with a fix for programming startup config
    [build_datetime.h, kiss_callback.c, kiss_callback.h, kiss_configuation.h, main.c, main.h]
2026-01-03 refactoring to have powersaving working, debugging task_ev_aprs_trigger_handle
2026-01-09 powersave waiting for event - i am an idiot
2026-01-20 removing support for ParaTNC/STM32F100 platform
2026-02-15 taskENTER_CRITICAL fix in beacon_send_own
    [build_datetime.h, main.c]
2026-02-18 WIP: few bugfixes, works only if powersaving task is completely commented out
    [aprsis.c, backup_registers.c, build_datetime.h, packet_tx_handler.c, packet_tx_handler.h, rte_main.h]
2026-02-18 aprsis: gsm_sim800_tcpip_write replaced previously used async function, powersave task uncommented back
    [aprsis.c, build_datetime.h, task_one_minute.c, task_power_save.c]
2026-02-19 suspending supervisor when tasks are also suspended (for powersaving)
2026-02-23 debuf powersaving and shedule
2026-02-23 incrementing packet tx in the interrupt, controller wakes up correctly while in scheduled aggressive powersave, gsm is not working
    [build_datetime.h, it_handlers.c, packet_tx_handler.c, packet_tx_handler.h, pwr_save.c]
2026-02-24 new events in sim800 driveR
2026-03-01 sending weather packet in scheduled aggressive powersave fixed, although telemetry values isn't send
    [aprsis.c, build_datetime.h, main.c, pwr_save.c, pwr_save.h, task_event_apris_msg_triggers.c, task_main.c]
2026-03-11 power save: small delay in between switching voltages, anemometer: minimym valid uf freq
2026-03-18 not enabling unserviced TIM3 interrupt, freertos: increasing max priority and moving task_one_second to its own
2026-03-29 doxygen, README, and docs in main.c
    [doxygen.cfg]
2026-04-01 code format
    [configuration_handler.h]
2026-06-03 radio transmission semphore rework and some logging
    [build_datetime.h, event_log.c, event_log_strings.h, it_handlers.c, main.c, main.h, main_freertos_externs.h]
2026-06-04 probable fix to supervisor fail
    [build_datetime.h]
2026-06-07 more optimal power sequencing during startup
2026-06-10 bugfix in wx_pwr_handler disabling modbus-rtu voltgage and not powering it up again
    [build_datetime.h, io.c, io.h, main.c, wx_handler_temperature.c, wx_pwr_switch.c]
2026-06-21 fix of problem with the same radio frame sent to host PC after threads are restored after powersaving
    [build_datetime.h, task_event_radio_message.c]
2026-08-23 usart transmission using DMA
2026-08-24 USART dma transmission works??
2026-08-26 fix typo SRAM1->SRAM2 in memory map
    [debug_hardfault.c, debug_hardfault.h, event_log_postmortem.c, memory_map.h, supervisor.c, variant_parameteo.c]
2026-08-28 SRAM2_NOINIT area used as a target for event log
    [memory_map_parameteo_stm32l476.xls]
2026-09-08 sx1262 prototype enabled
2026-09-09 creating FANET wx frame from real data
2026-09-17 sending FANET weather frames triggered each one minute
2026-09-18 hotfix: workaround assert tripping on non-continous log entries seq numbers
    [build_datetime.h, main.h]
2026-09-29 bug: max13865 driver, configuration of sensor wiring (4 or 2 wire) is by mistake coupled with its resistance (pt100 / pt1000)
    [build_datetime.h, max31865.c, max31865.h]
2026-10-04 fix in configuring fanet_latitude in fanet_longitude
    [build_datetime.h, fanet_app.c, main.h, max31865.h]
2026-10-17 one minute task fix: triggering too frequent due to suspending and resuming from powersacing
2026-10-19 hardware revision h schematic and bom
